james-hepworth/masters/Simulation/README.txt

Instructions to run this simulation can be obtained from:

James Hepworth
james@hepworth.systems
