james-hepworth/masters/Mechanical Design/Mechanical Design Calulations.pdf

# Mechanical Design Calculations

In this document, scans are taken from the author’s notebook of design calculations that were made for various load bearing parts designed for use in the ISP assembly.

## Body Mounting Stand

The body mount supports the entire mass of the gimbal assembly. These calculations estimated deflection in the part when manufactured from 4 mm steel.

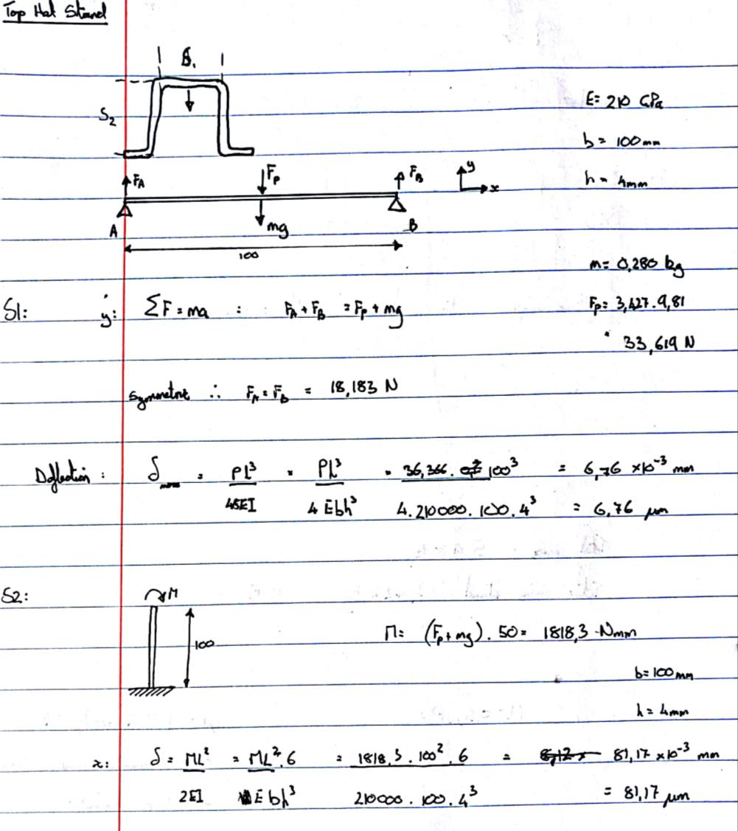
[picture p1: figure]

This part bore the load of the gimbal assembly, at the time of the design calculations, this part had a mass of 3.427 kg. The deflection of the horizontal section was estimated at only -6.76 μm in the y direction indicated, whilst calculations revealed that an x deflection of 81.17 μm would be present if the entire load was supported by one side of the vertical arms. Two arms clearly result in a smaller deflection. These estimates were very small and were acceptable values for the project. Therefore, the mounting stand was chosen to be made from 4 mm thick steel.

### Gimbal Base

The gimbal base supports the vertical uprights of the yaw gimbal which in turn support the telescope platform

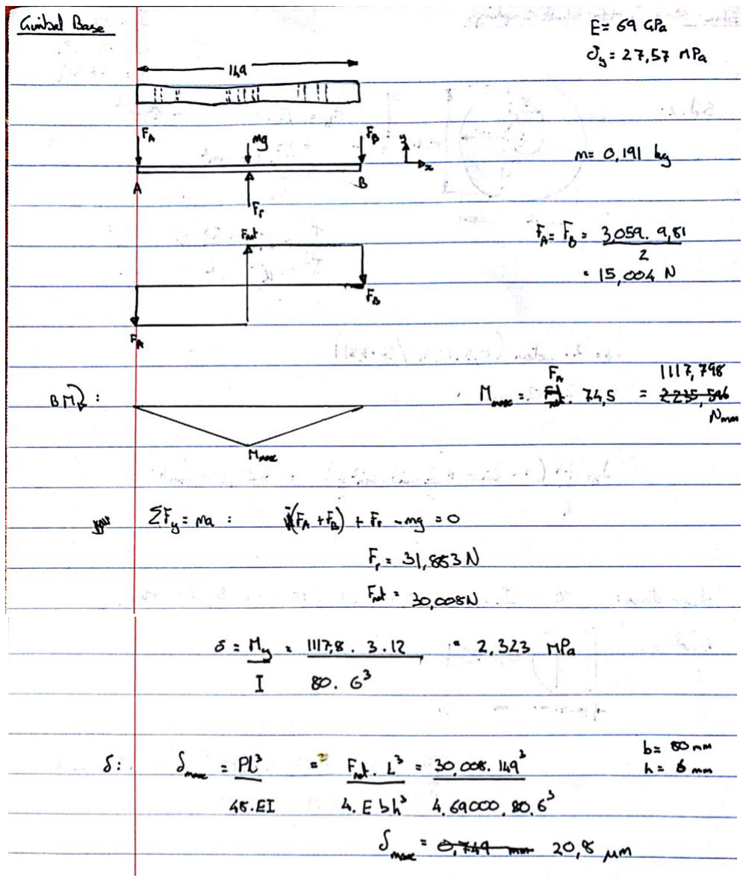
[picture p2: figure]

Calculations estimated an acceptable deflection of 20.8 μm being evident if the part was made from 6 mm Aluminum.

### Shear Stress in Motor Shaft Couplings

The motor shaft couplings joined the motors to the inertia of the gimbal or the telescope platform

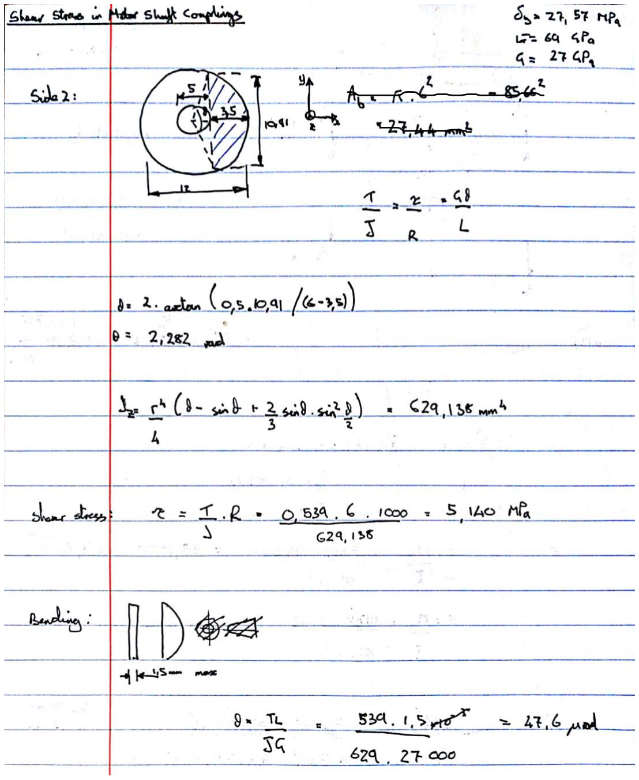
[picture p3: figure]

The calculations above show a shear stress of 5.14 MPa in response to the maximum motor torque of 0.539 Nm. This is well below the yield stress of approximately 27.57 MPa for 1060 Aluminum from which the parts are made. In addition, a twist angle 47.6 μrad was expected and was deemed acceptable for the project

### Gimbal Uprights

These parts support the pitch platform such that it can rotate freely.

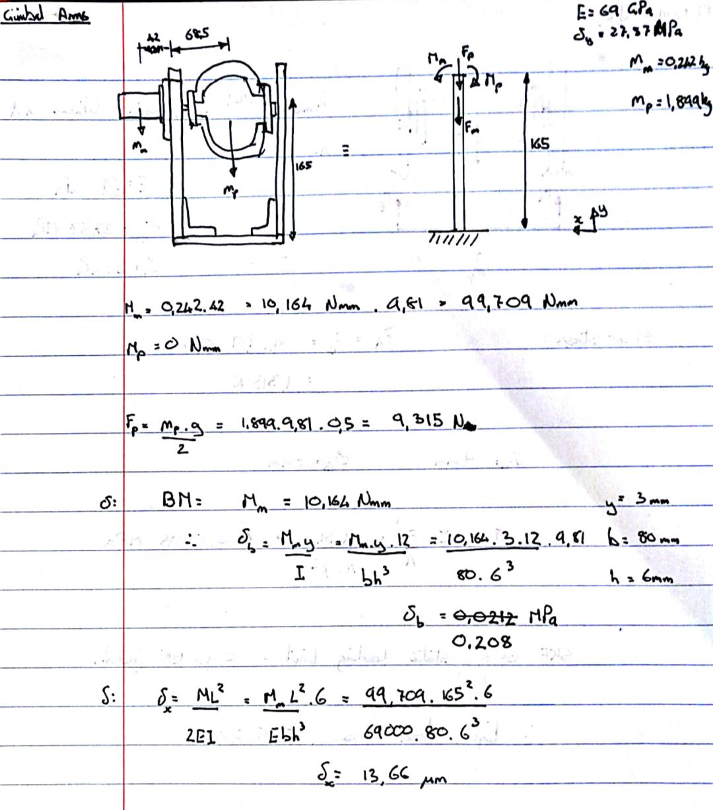
[picture p4: figure]

From the calculations above, a shear stress in the arms was evident at 0.208 MPa, far lower than the yield stress of the 1060 Aluminum from which they were made, and a deflection in the x direction of 13.7 μm was evident.

### Side 1 and Side 2 Turned

These parts supported the telescope platform and were required to bear the shear load of the telescope weight.

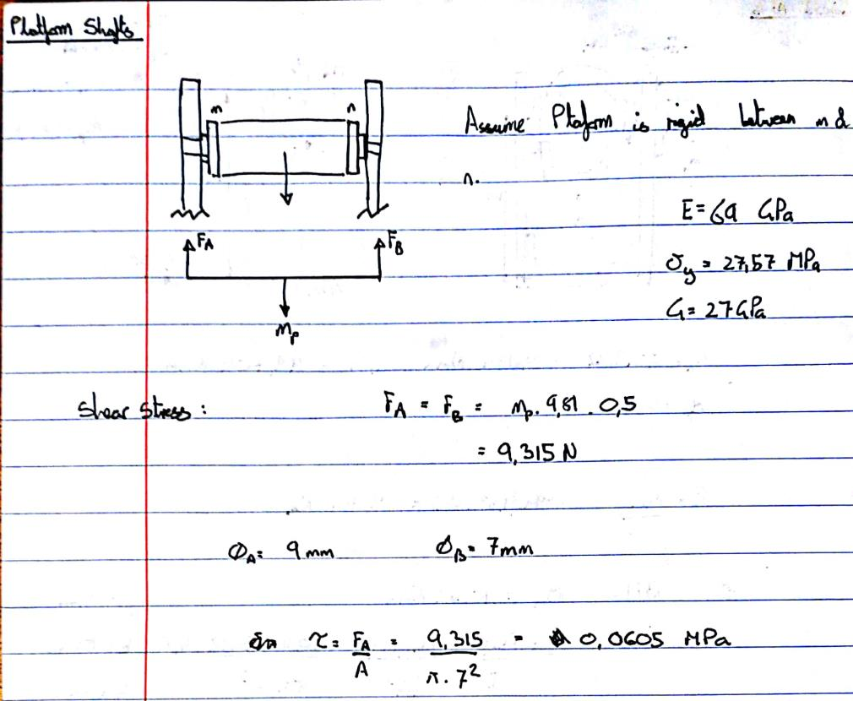
[picture p5: figure]

Shear stress in the parts at 0.061 MPa can be seen to be far lower than the limit for 1060 Aluminum from which they were made.

### Platform Sides

The platform sides support the load of the telescope and transfer it to the Side 1 and 2 turned parts. In the calculations below they can be seen to be under low stress and deflect by very small amounts when manufactured from 5 mm Aluminum.

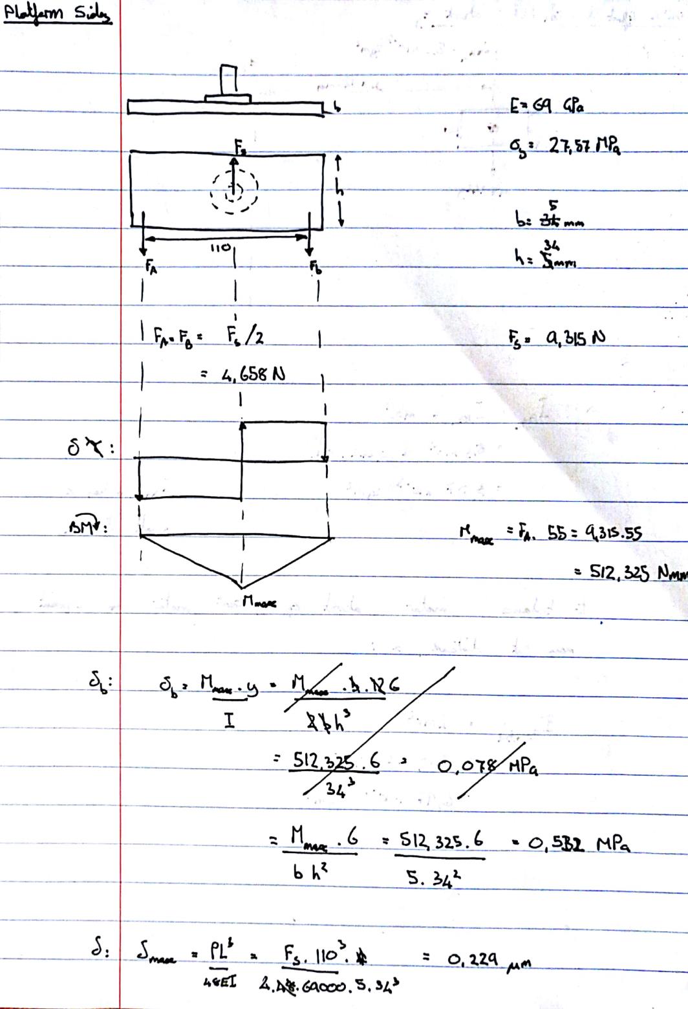
[picture p6: figure]
