james-hepworth/masters/Mechanical Design/SolidWorks Assemblies and Parts/Telescope Platform.SLDASM

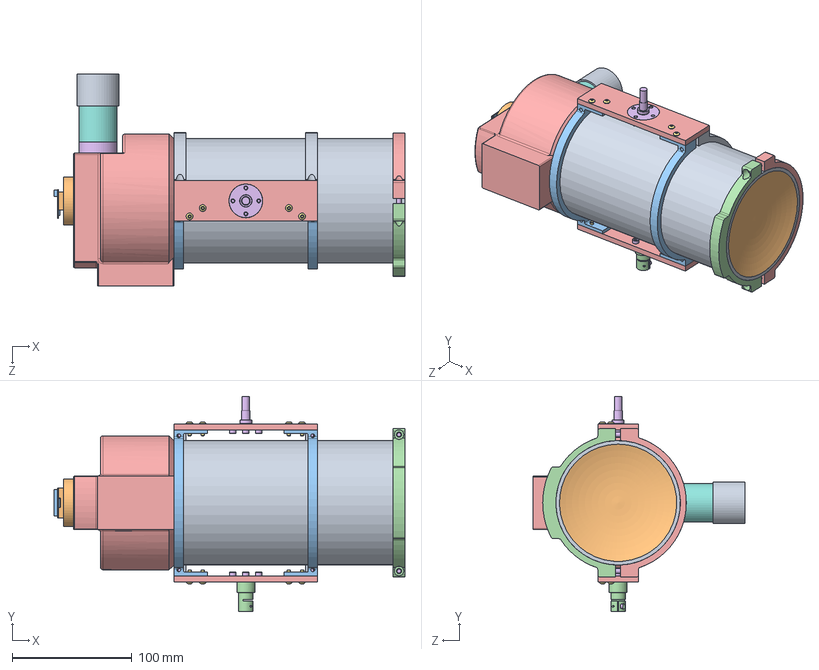
[picture p25: CAD file, 2018-11-27]
Mechanical Design/SolidWorks Assemblies and Parts/Telescope Platform.SLDASM
293.3 x 180.0 x 176.9 mm
Telescope Clamp x 2
CS-Mount Telescope Adapter
Raspberry Pi Cam
Telescope Mass2
Telescope Mass
socket head cap screw_iso x 15
Primary Mirror Mount
Primary Mirror
Tube
Filter
Secondary Mirror Mount
Lense Tube
Back Cover
Eyepiece 1
Lens 2
Eyepiece 2
Eyepiece 3
Lens 1
Tube Clamp Bottom x 2
Side2_Turned
Side_Housing x 2
Side1_Turned
socket button head screw_iso x 8
