james-hepworth/masters/Mechanical Design/SolidWorks Assemblies and Parts/Camera Assembly.SLDASM

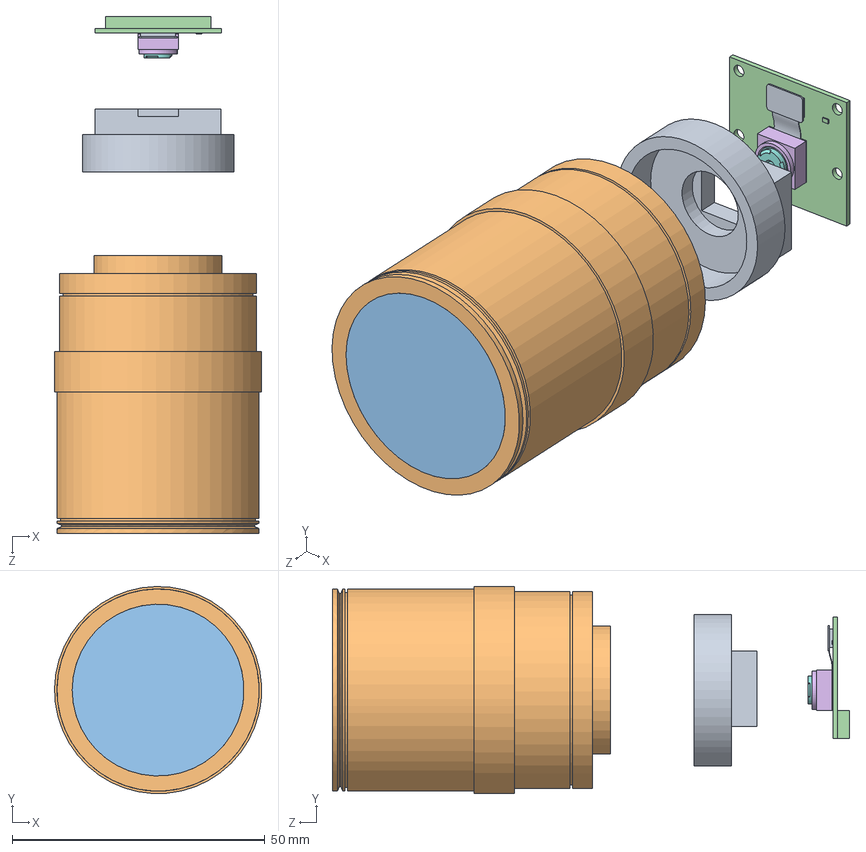
[picture p26: CAD file, 2018-11-27]
Mechanical Design/SolidWorks Assemblies and Parts/Camera Assembly.SLDASM
41.0 x 41.0 x 102.3 mm
CS-Mount Adapter
Actaul Lens
Lens Glass x 2
RasPi_Camera_Board
OVA5647
OVA5647_Housing
OVA5647_IR-Glas
OVA5647_Lens
OVA5647_Pigtail
