james-hepworth/masters/Mechanical Design/SolidWorks Assemblies and Parts/MPU 6050 IMU.SLDASM

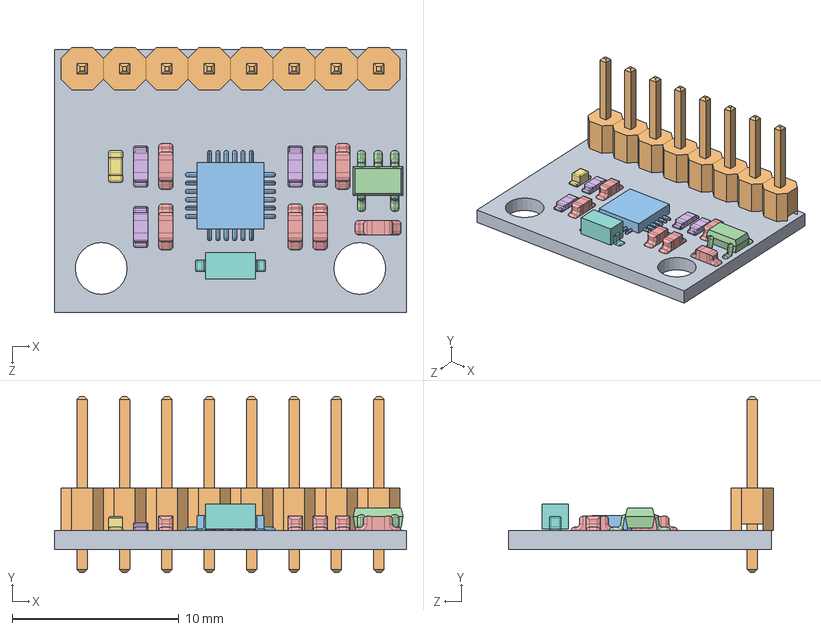
[picture p27: CAD file, 2018-11-27]
Mechanical Design/SolidWorks Assemblies and Parts/MPU 6050 IMU.SLDASM
21.1 x 10.6 x 15.9 mm
Base
pin header x 8
sensor chip
S2NH chip
Resistor small x 6
Resistor small black x 4
Small LED
Resistor black
