james-hepworth/masters/Mechanical Design/SolidWorks Assemblies and Parts/OVA5647.SLDASM

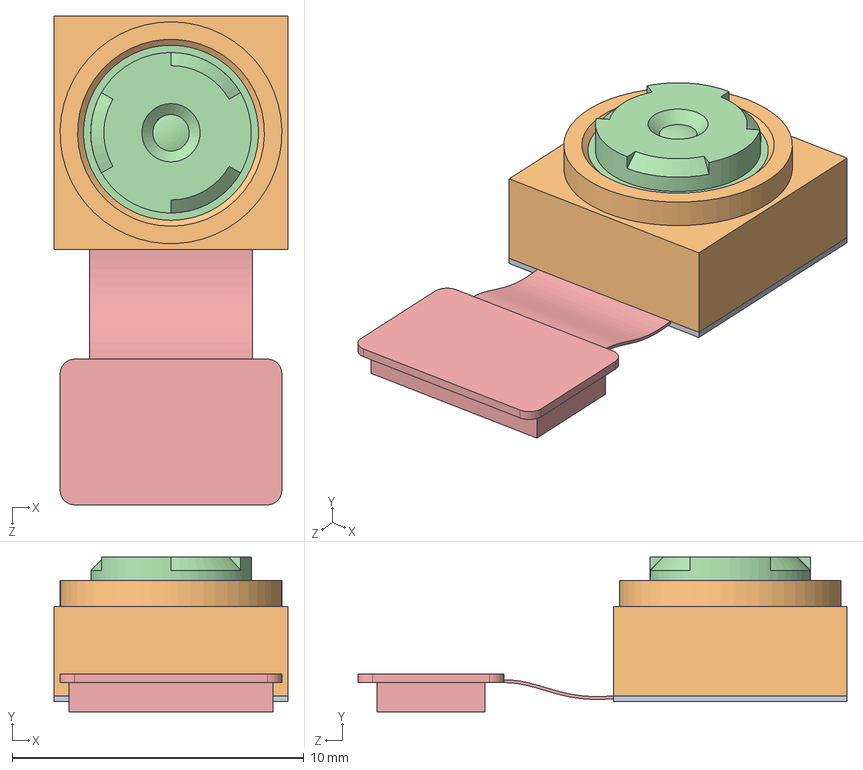
[picture p28: CAD file, 2018-11-27]
Mechanical Design/SolidWorks Assemblies and Parts/OVA5647.SLDASM
8.00 x 5.30 x 16.8 mm
OVA5647
OVA5647_Housing
OVA5647_IR-Glas
OVA5647_Lens
OVA5647_Pigtail
