james-hepworth/masters/Mechanical Design/SolidWorks Assemblies and Parts/Yaw Gimbal.SLDASM

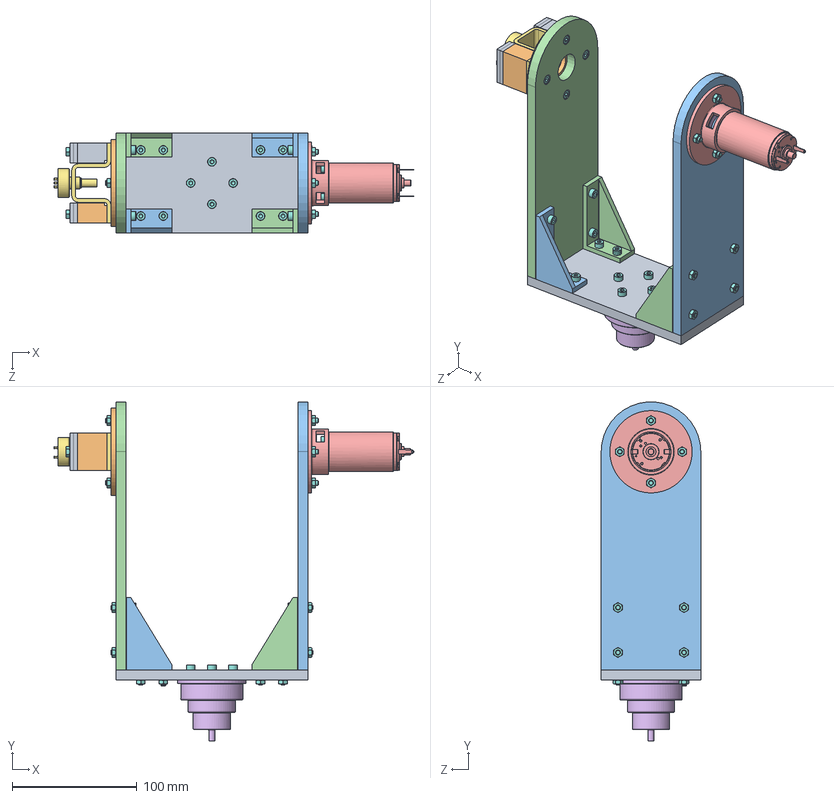
[picture p29: CAD file, 2018-11-27]
Mechanical Design/SolidWorks Assemblies and Parts/Yaw Gimbal.SLDASM
288.8 x 271.9 x 80.0 mm
Gimbal Base
Retaining Disk 1
Upright2
Upright1
3257 Mount
Bearing Mount
Pot Mount
socket head cap screw_iso x 34
Mass Block CNC L
Mass Block CNC R
Vertical Suport1 x 2
Vertical Suport2 x 2
3257G_CR_SW
Yaw Inner Race
Vishay 357 Pot
hex nut style 1 gradeab_iso x 24
Mass Block2 x 4
