james-hepworth/masters/Mechanical Design/SolidWorks Assemblies and Parts/Stand2.SLDASM

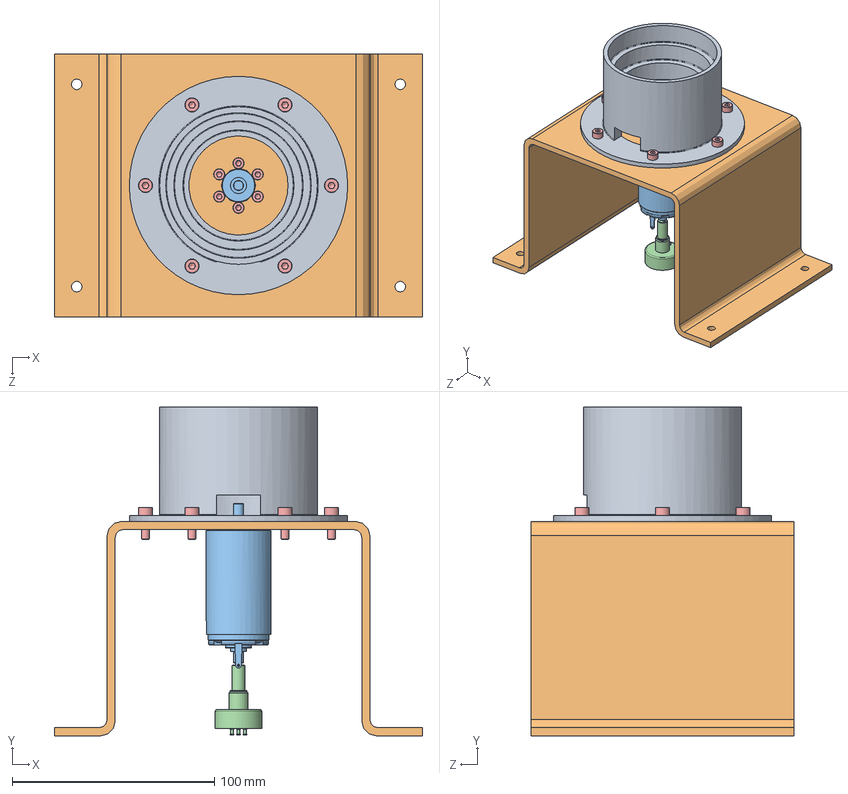
[picture p30: CAD file, 2018-11-27]
Mechanical Design/SolidWorks Assemblies and Parts/Stand2.SLDASM
182.0 x 162.5 x 130.0 mm
Body Mount
3257G_CR_SW
Yaw Outer Race
Vishay 357 Pot
socket head cap screw_iso x 12
