james-hepworth/masters/Mechanical Design/SolidWorks Assemblies and Parts/Eyepiece.SLDASM

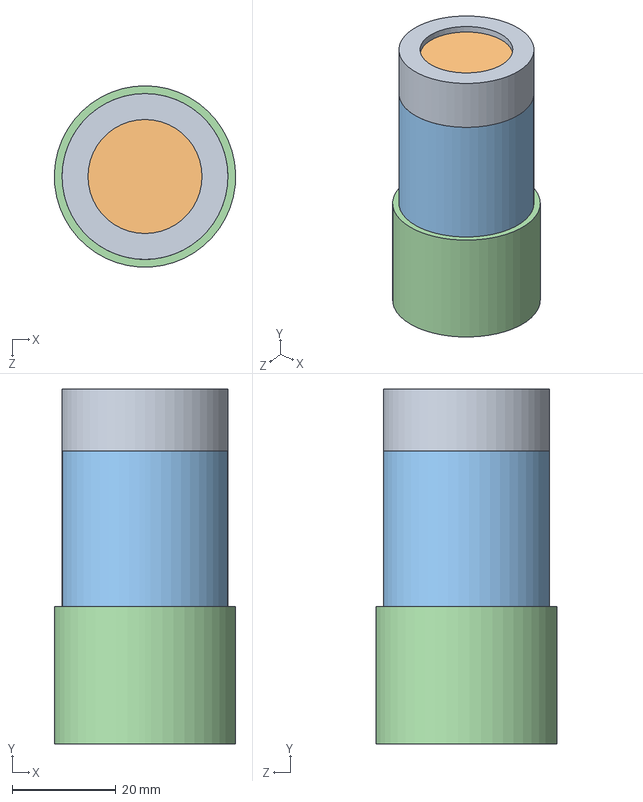
[picture p32: CAD file, 2018-11-27]
Mechanical Design/SolidWorks Assemblies and Parts/Eyepiece.SLDASM
35.0 x 68.5 x 35.0 mm
Eyepiece 1
Lens 2
Eyepiece 2
Eyepiece 3
Lens 1
