james-hepworth/masters/Mechanical Design/SolidWorks Assemblies and Parts/Gimbal.SLDASM

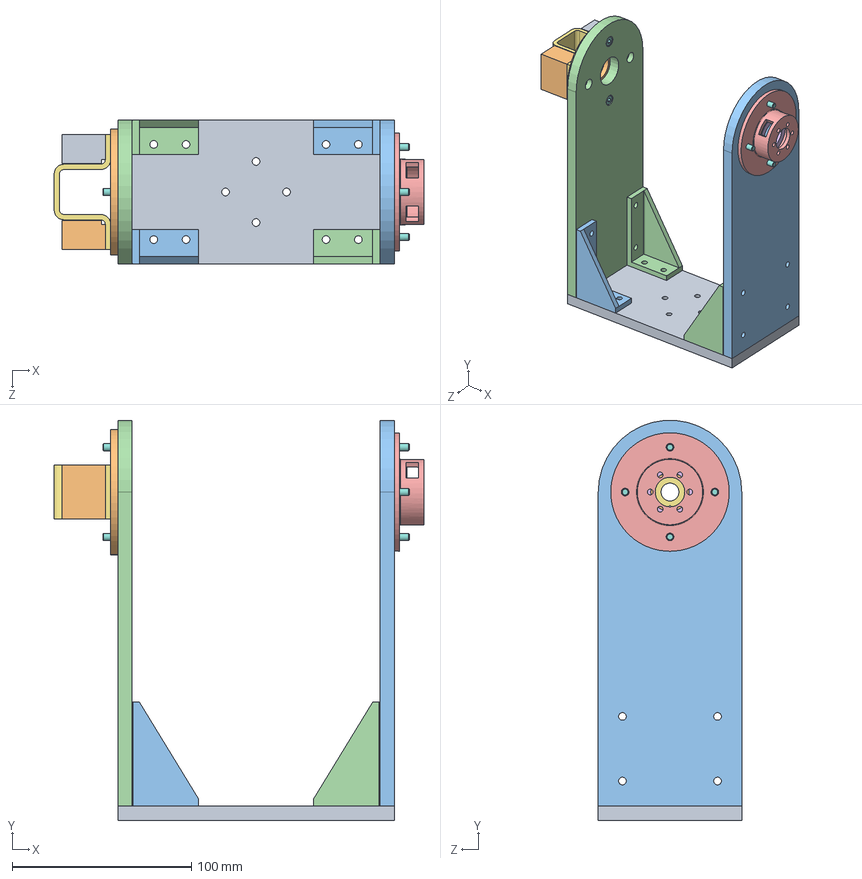
[picture p33: CAD file, 2018-11-27]
Mechanical Design/SolidWorks Assemblies and Parts/Gimbal.SLDASM
206.0 x 222.9 x 80.0 mm
Gimbal Base
Retaining Disk 1
Upright2
Upright1
3257 Mount
Bearing Mount
Pot Mount
socket head cap screw_iso x 6
Mass Block CNC L
Mass Block CNC R
Vertical Suport1 x 2
Vertical Suport2 x 2
