james-hepworth/masters/Mechanical Design/SolidWorks Assemblies and Parts/Base New.SLDASM

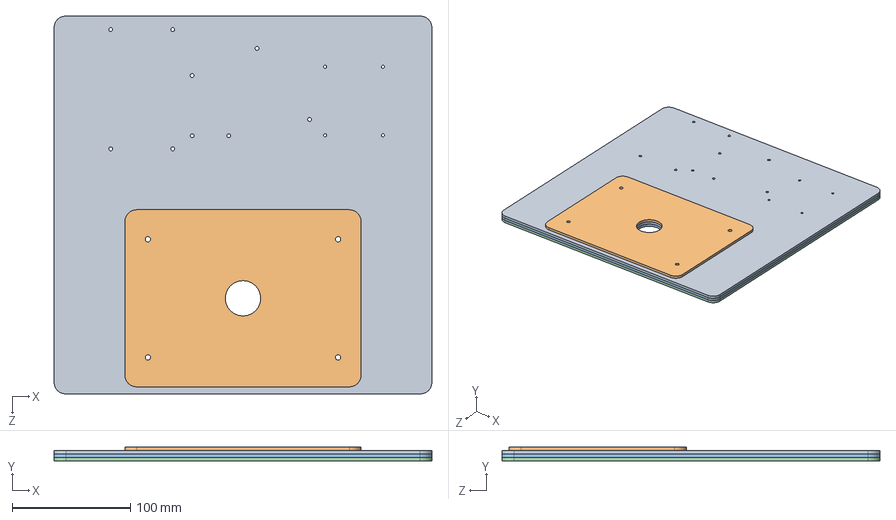
[picture p34: CAD file, 2018-11-27]
Mechanical Design/SolidWorks Assemblies and Parts/Base New.SLDASM
320.0 x 12.0 x 320.0 mm
System Base
System Base2
System Base3
System Base4
