james-hepworth/masters/Mechanical Design/SolidWorks Assemblies and Parts/127 TN9.sldasm

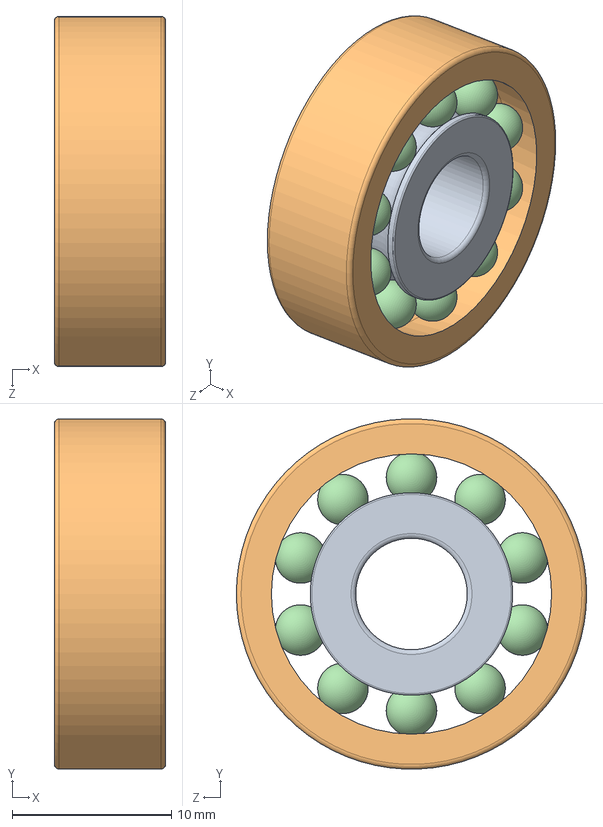
[picture p35: CAD file, 2018-11-27]
Mechanical Design/SolidWorks Assemblies and Parts/127 TN9.sldasm
7.00 x 22.0 x 22.0 mm
127 TN9_PART1
127 TN9_PART2
127 TN9_PART3 x 10
127 TN9_PART4 x 10
