james-hepworth/masters/Mechanical Design/SolidWorks Assemblies and Parts/ETX-90 Model.SLDASM

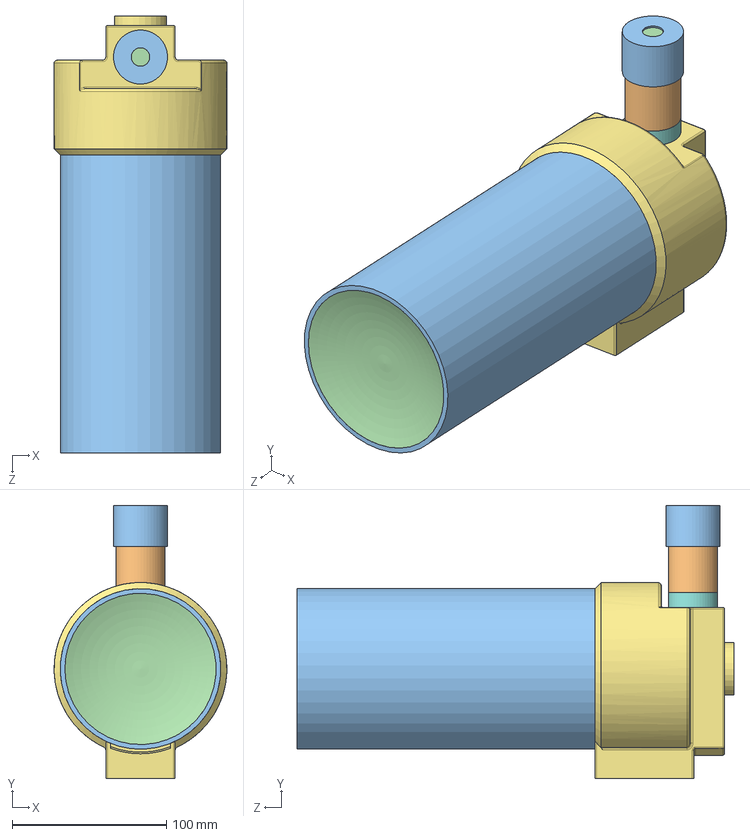
[picture p36: CAD file, 2018-11-27]
Mechanical Design/SolidWorks Assemblies and Parts/ETX-90 Model.SLDASM
112.0 x 176.9 x 283.0 mm
Primary Mirror Mount
Primary Mirror
Tube
Filter
Secondary Mirror Mount
Lense Tube
Back Cover
Eyepiece 1
Lens 2
Eyepiece 2
Eyepiece 3
Lens 1
