james-hepworth/masters/Mechanical Design/SolidWorks Assemblies and Parts/System Assembly.SLDASM

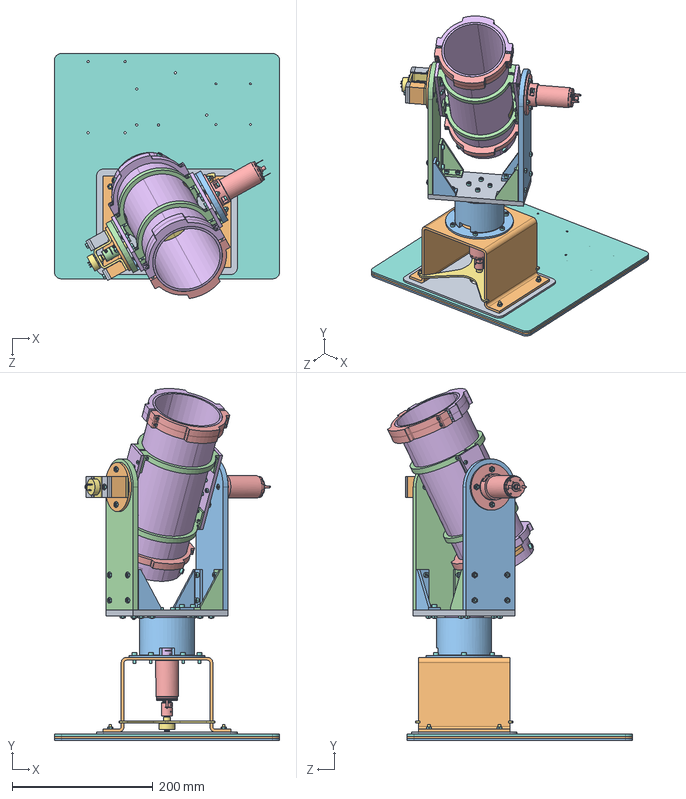
[picture p37: CAD file, 2018-11-27]
Mechanical Design/SolidWorks Assemblies and Parts/System Assembly.SLDASM
320.0 x 499.7 x 347.9 mm
Gimbal Base
Retaining Disk 1
Upright2
Upright1
3257 Mount
Bearing Mount
Pot Mount
socket head cap screw_iso x 72
Mass Block CNC L
Mass Block CNC R
Vertical Suport1 x 2
Vertical Suport2 x 2
3257G_CR_SW x 2
Yaw Inner Race
Vishay 357 Pot x 2
hex nut style 1 gradeab_iso x 36
Mass Block2 x 4
Body Mount
Yaw Outer Race
Tube Clamp Bottom x 2
Side2_Turned
Side_Housing x 2
Side1_Turned
socket button head screw_iso x 8
Cam Mount3
Cam Mount2
Cam Mount1
Base
pin header x 8
sensor chip
S2NH chip
Resistor small x 6
Resistor small black x 4
Small LED
Resistor black
IMU mount
CS-Mount Adapter
Actaul Lens
Lens Glass x 2
RasPi_Camera_Board
OVA5647
OVA5647_Housing
OVA5647_IR-Glas
OVA5647_Lens
OVA5647_Pigtail
Cam Tube x 2
Cam Holder x 4
pan head cross recess screw_iso x 6
Cam Mount3 H
Cam Mount2.1
M5 Insert x 4
Tube Clamp x 2
Tube Mass Bottom x 3
Tube Mass x 3
127 TN9_PART1
127 TN9_PART2
127 TN9_PART3 x 10
127 TN9_PART4 x 10
radial ball bearing_68_skf x 2
Pot Coupling1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
