james-hepworth/masters/Mechanical Design/SolidWorks Assemblies and Parts/Pitch Platform.SLDASM

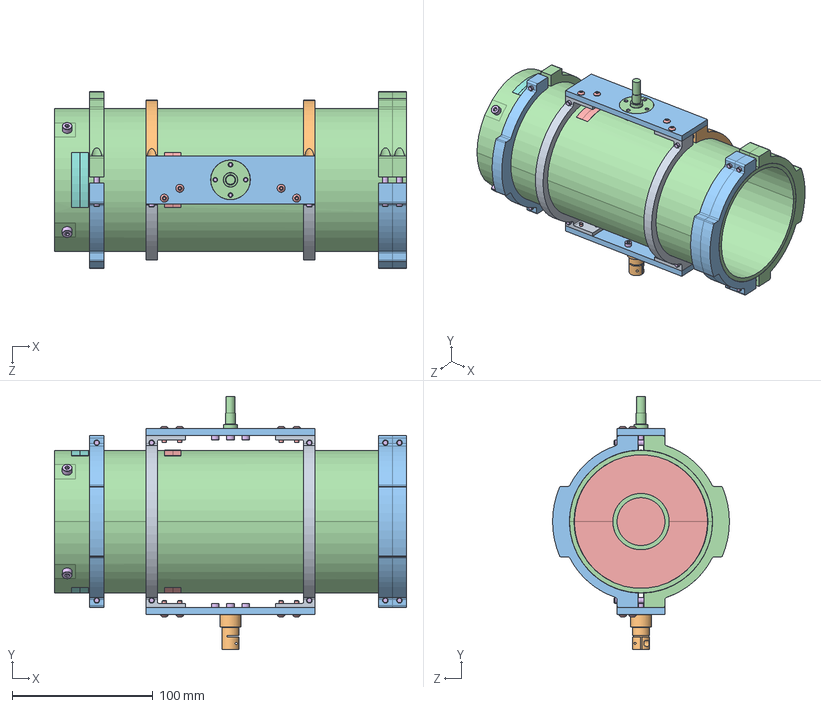
[picture p38: CAD file, 2018-11-27]
Mechanical Design/SolidWorks Assemblies and Parts/Pitch Platform.SLDASM
250.0 x 180.0 x 125.6 mm
Tube Clamp Bottom x 2
Side2_Turned
Side_Housing x 2
Side1_Turned
socket button head screw_iso x 8
socket head cap screw_iso x 26
Cam Mount3
Cam Mount2
Cam Mount1
Base
pin header x 8
sensor chip
S2NH chip
Resistor small x 6
Resistor small black x 4
Small LED
Resistor black
IMU mount
CS-Mount Adapter
Actaul Lens
Lens Glass x 2
RasPi_Camera_Board
OVA5647
OVA5647_Housing
OVA5647_IR-Glas
OVA5647_Lens
OVA5647_Pigtail
Cam Tube x 2
Cam Holder x 4
pan head cross recess screw_iso x 6
Cam Mount3 H
Cam Mount2.1
M5 Insert x 4
Tube Clamp x 2
Tube Mass Bottom x 3
Tube Mass x 3
