james-hepworth/masters/Mechanical Design/SolidWorks Assemblies and Parts/RasPi_Camera.SLDASM

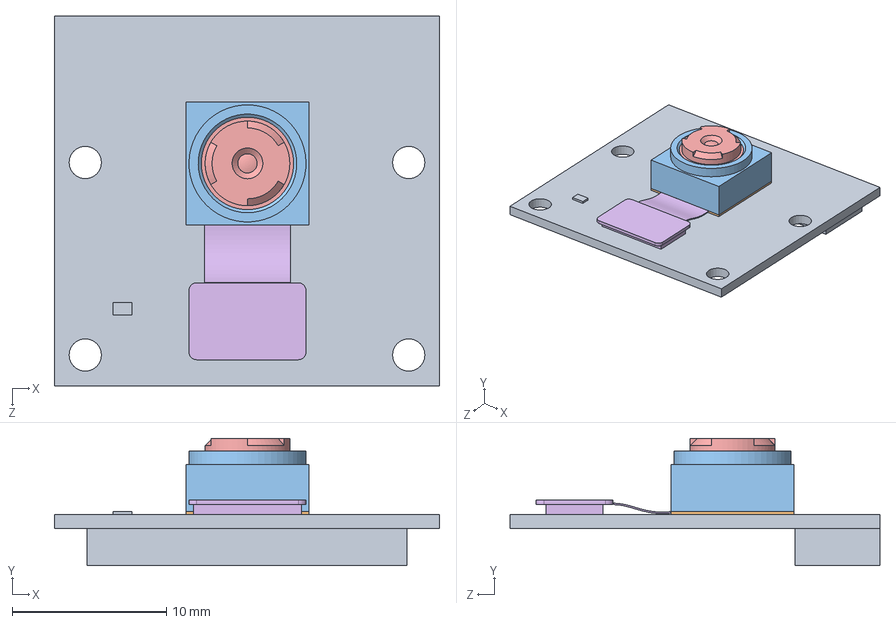
[picture p39: CAD file, 2018-11-27]
Mechanical Design/SolidWorks Assemblies and Parts/RasPi_Camera.SLDASM
25.0 x 8.25 x 24.0 mm
RasPi_Camera_Board
OVA5647
OVA5647_Housing
OVA5647_IR-Glas
OVA5647_Lens
OVA5647_Pigtail
