james-hepworth/masters/Mechanical Design/SolidWorks Assemblies and Parts/Telescop Modeller Tray.SLDASM

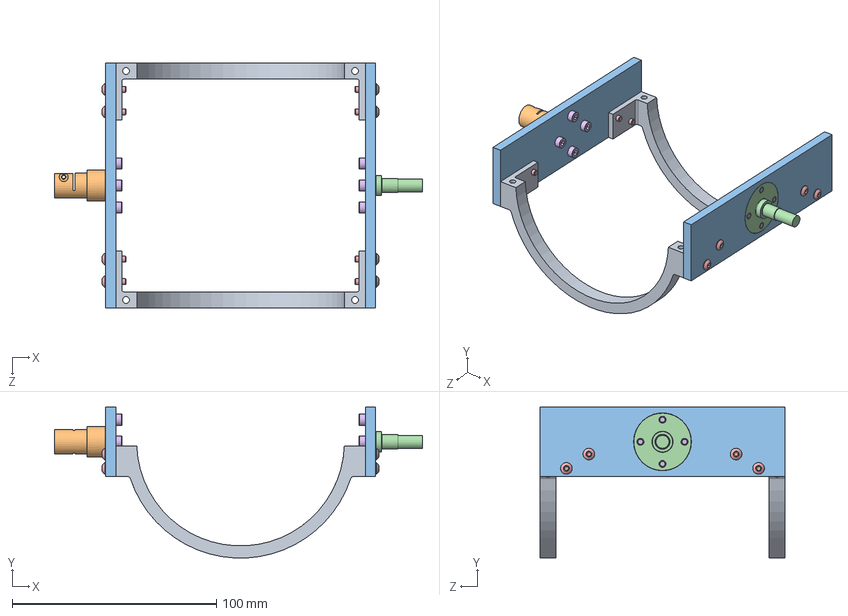
[picture p40: CAD file, 2018-11-27]
Mechanical Design/SolidWorks Assemblies and Parts/Telescop Modeller Tray.SLDASM
180.0 x 73.8 x 120.0 mm
Tube Clamp Bottom x 2
Side2_Turned
Side_Housing x 2
Side1_Turned
socket button head screw_iso x 8
socket head cap screw_iso x 8
