james-hepworth/masters/Mechanical Design/SolidWorks Assemblies and Parts/127 TN9_PART2.sldprt

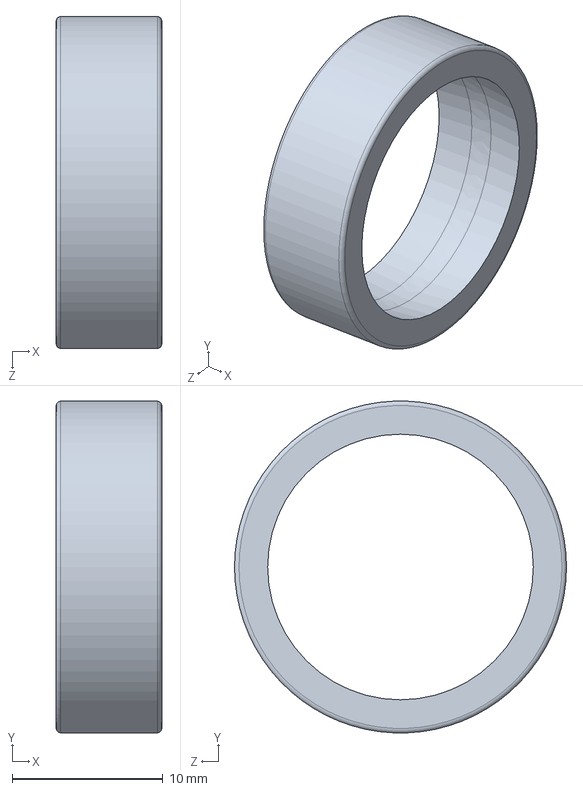
[picture p41: CAD file, 2018-11-27]
Mechanical Design/SolidWorks Assemblies and Parts/127 TN9_PART2.sldprt
7.00 x 22.0 x 22.0 mm
