james-hepworth/masters/Mechanical Design/SolidWorks Assemblies and Parts/Side1_Turned.SLDPRT

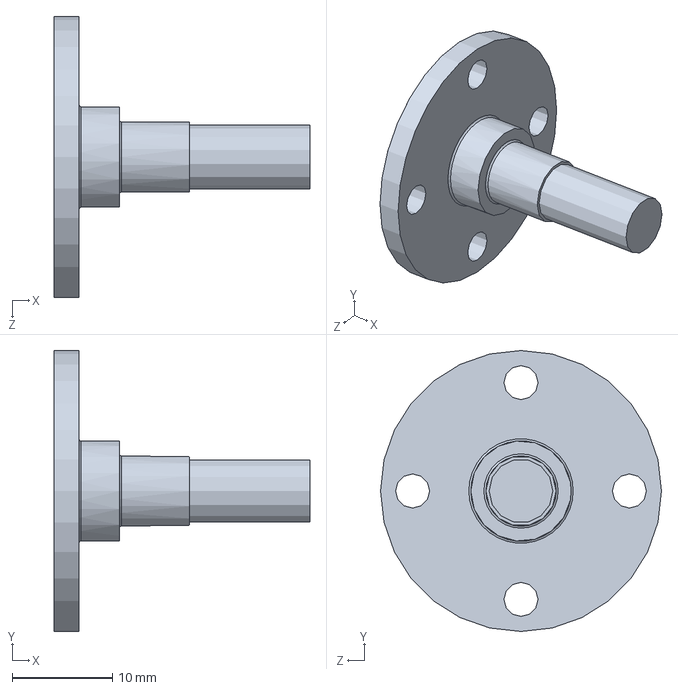
[picture p42: CAD file, 2018-11-27]
Mechanical Design/SolidWorks Assemblies and Parts/Side1_Turned.SLDPRT
25.5 x 28.0 x 28.0 mm
