james-hepworth/masters/Mechanical Design/SolidWorks Assemblies and Parts/OVA5647_Housing.SLDPRT

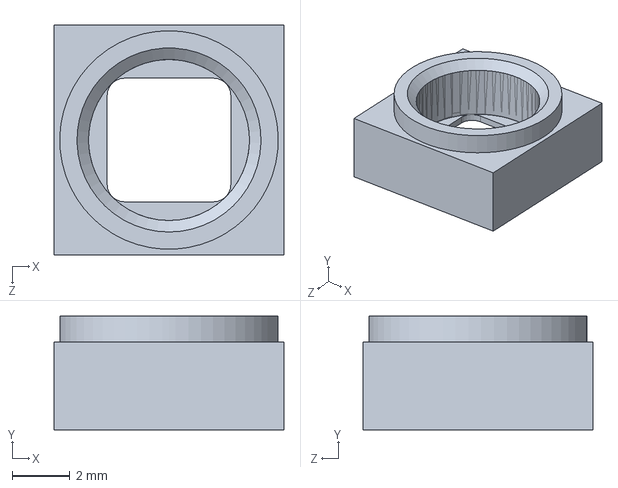
[picture p43: CAD file, 2018-11-27]
Mechanical Design/SolidWorks Assemblies and Parts/OVA5647_Housing.SLDPRT
8.00 x 3.95 x 8.00 mm
