james-hepworth/masters/Mechanical Design/SolidWorks Assemblies and Parts/Cam Mount3.SLDPRT

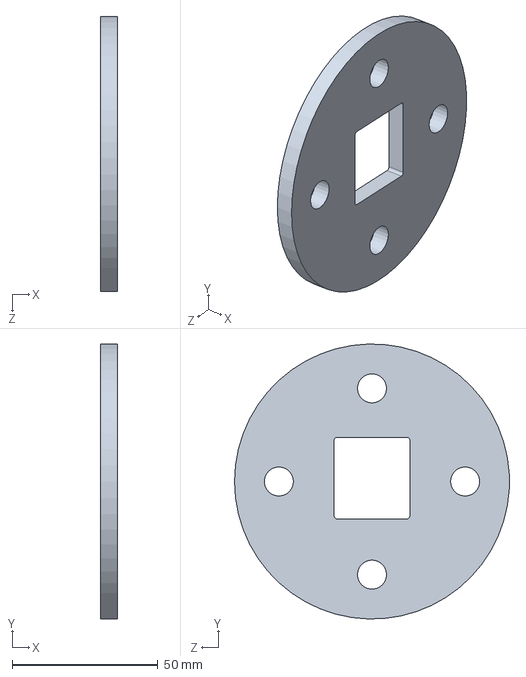
[picture p44: CAD file, 2018-11-27]
Mechanical Design/SolidWorks Assemblies and Parts/Cam Mount3.SLDPRT
6.00 x 94.5 x 94.5 mm
