james-hepworth/masters/Mechanical Design/SolidWorks Assemblies and Parts/Tube Mass.SLDPRT

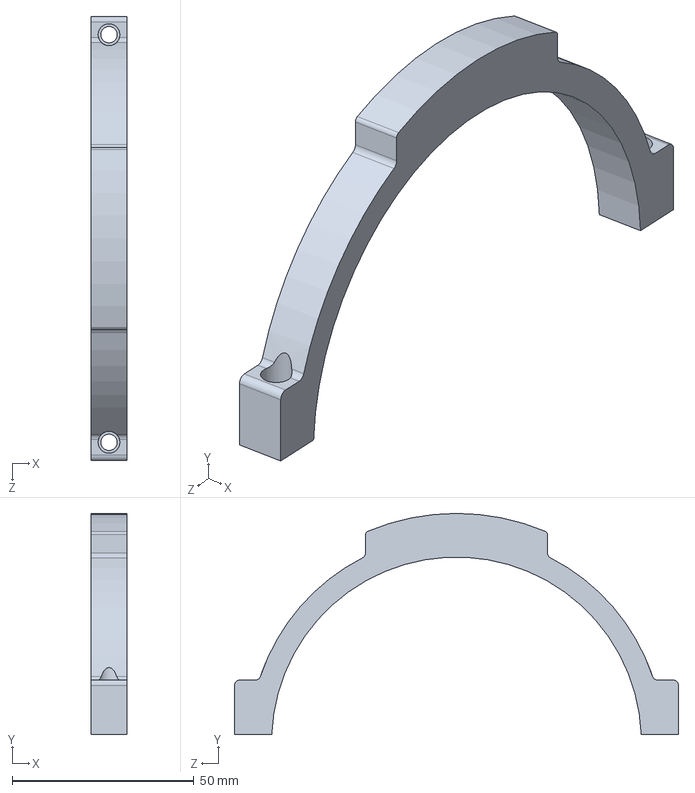
[picture p45: CAD file, 2018-11-27]
Mechanical Design/SolidWorks Assemblies and Parts/Tube Mass.SLDPRT
10.0 x 60.8 x 122.0 mm
