james-hepworth/masters/Mechanical Design/SolidWorks Assemblies and Parts/sensor chip.SLDPRT

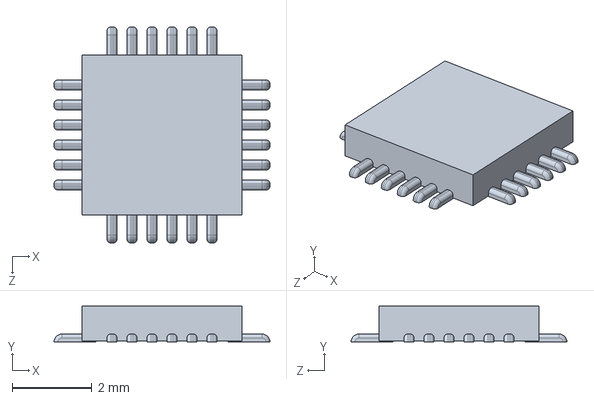
[picture p46: CAD file, 2018-11-27]
Mechanical Design/SolidWorks Assemblies and Parts/sensor chip.SLDPRT
5.40 x 0.9 x 5.40 mm
