james-hepworth/masters/Mechanical Design/SolidWorks Assemblies and Parts/Mass Block2.SLDPRT

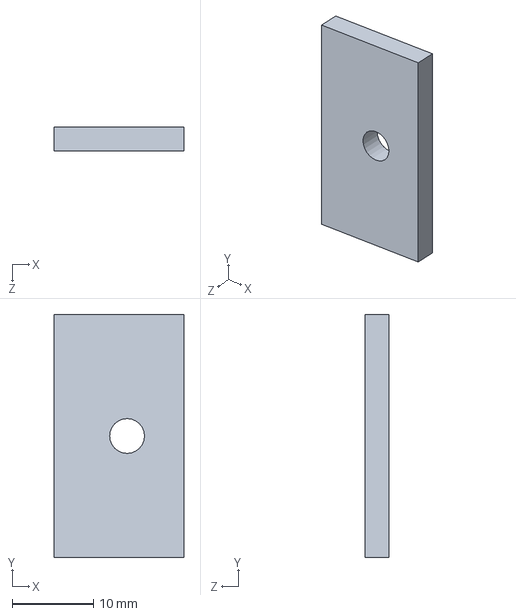
[picture p47: CAD file, 2018-11-27]
Mechanical Design/SolidWorks Assemblies and Parts/Mass Block2.SLDPRT
16.0 x 30.0 x 3.00 mm
