james-hepworth/masters/Mechanical Design/SolidWorks Assemblies and Parts/Pot Mount.SLDPRT

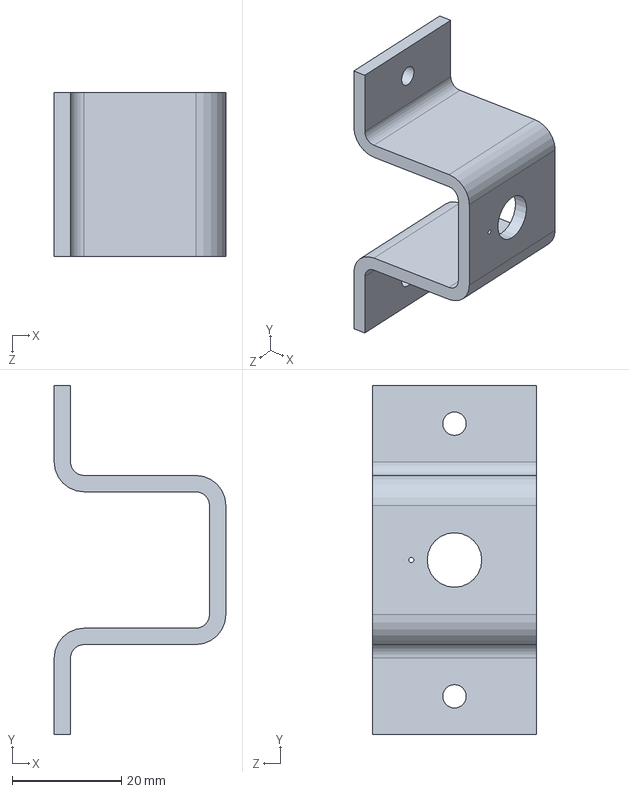
[picture p48: CAD file, 2018-11-27]
Mechanical Design/SolidWorks Assemblies and Parts/Pot Mount.SLDPRT
31.5 x 64.0 x 30.0 mm
