james-hepworth/masters/Mechanical Design/SolidWorks Assemblies and Parts/Side1.SLDPRT

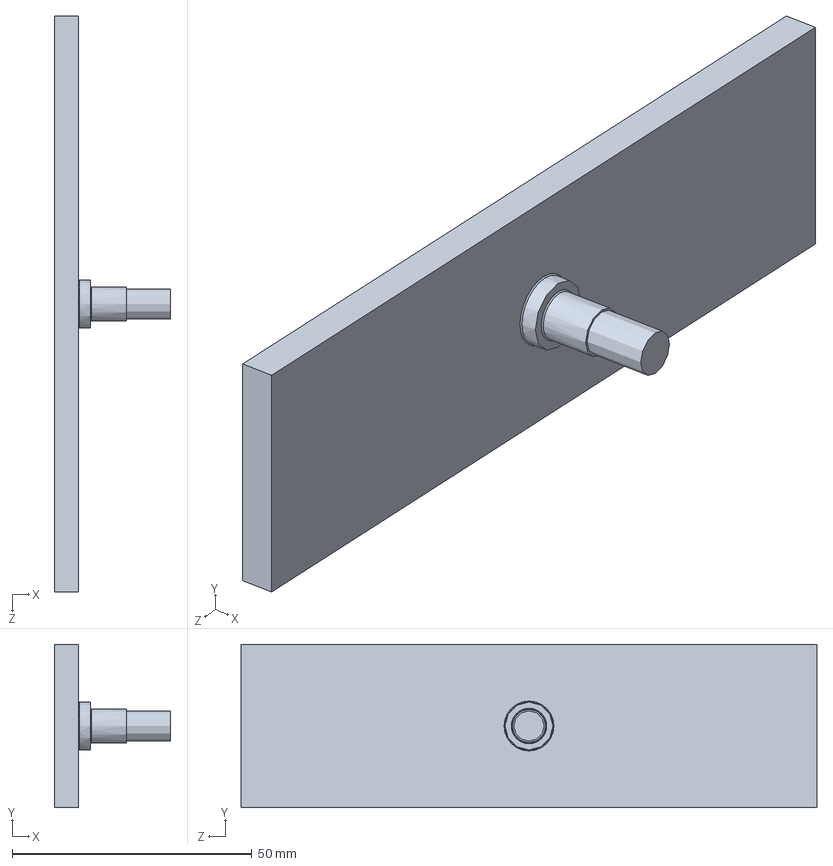
[picture p49: CAD file, 2018-11-27]
Mechanical Design/SolidWorks Assemblies and Parts/Side1.SLDPRT
24.2 x 34.0 x 120.0 mm
