james-hepworth/masters/Mechanical Design/SolidWorks Assemblies and Parts/Shaft Coupling.SLDPRT

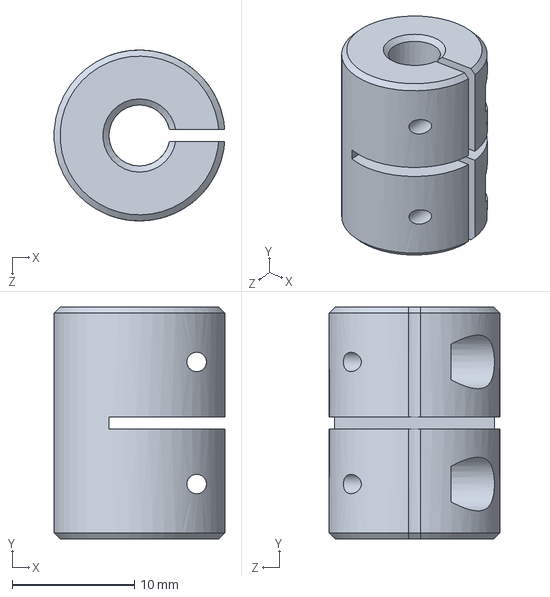
[picture p50: CAD file, 2018-11-27]
Mechanical Design/SolidWorks Assemblies and Parts/Shaft Coupling.SLDPRT
14.0 x 19.0 x 14.0 mm
