james-hepworth/masters/Mechanical Design/SolidWorks Assemblies and Parts/Yaw Inner Race.SLDPRT

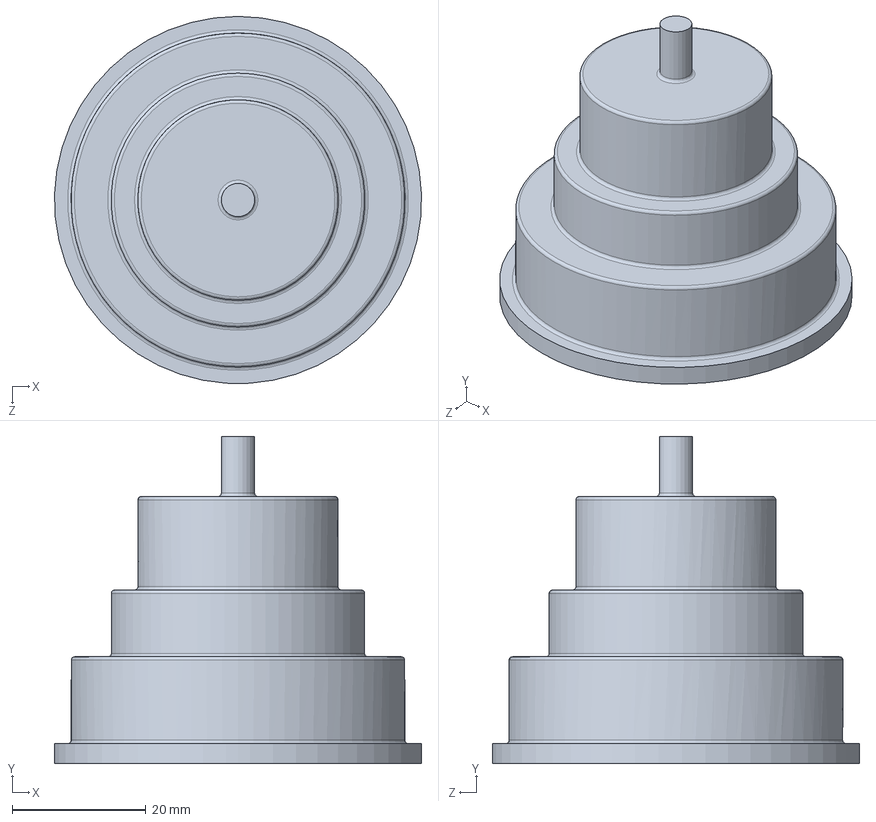
[picture p51: CAD file, 2018-11-27]
Mechanical Design/SolidWorks Assemblies and Parts/Yaw Inner Race.SLDPRT
55.0 x 49.0 x 55.0 mm
