james-hepworth/masters/Mechanical Design/SolidWorks Assemblies and Parts/System Base3.SLDPRT

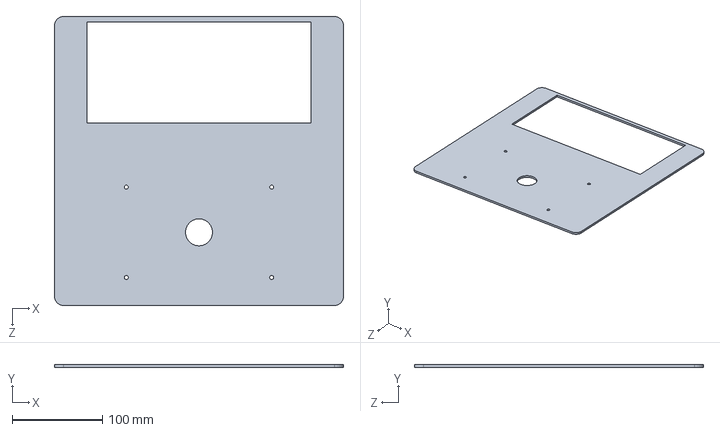
[picture p52: CAD file, 2018-11-27]
Mechanical Design/SolidWorks Assemblies and Parts/System Base3.SLDPRT
320.0 x 3.00 x 320.0 mm
