james-hepworth/masters/Mechanical Design/SolidWorks Assemblies and Parts/Part1.SLDPRT

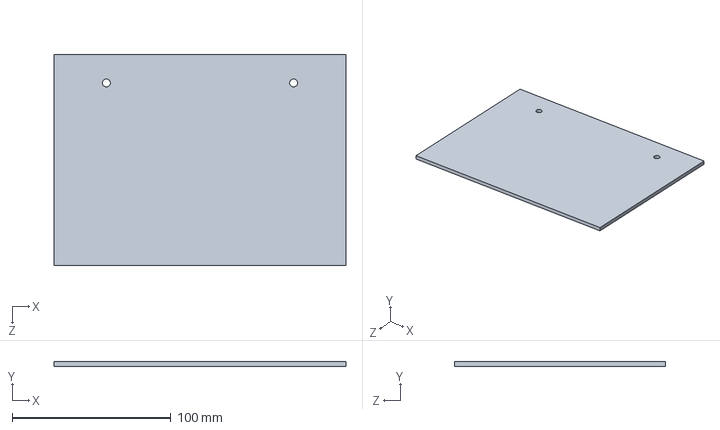
[picture p53: CAD file, 2018-11-27]
Mechanical Design/SolidWorks Assemblies and Parts/Part1.SLDPRT
183.8 x 3.00 x 133.0 mm
