james-hepworth/masters/Mechanical Design/SolidWorks Assemblies and Parts/Yaw Outer Race.SLDPRT

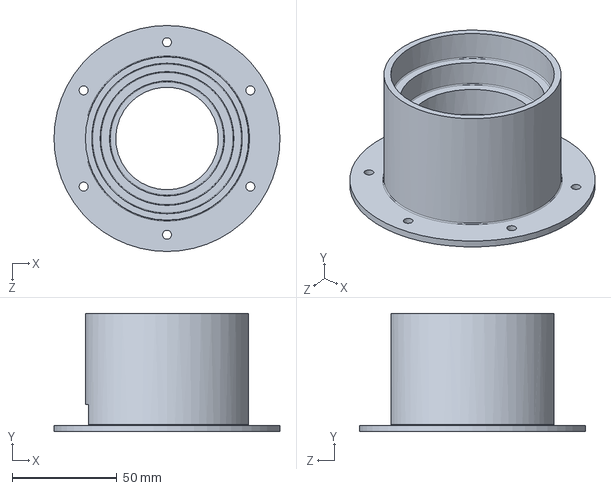
[picture p54: CAD file, 2018-11-27]
Mechanical Design/SolidWorks Assemblies and Parts/Yaw Outer Race.SLDPRT
108.0 x 56.5 x 108.0 mm
