james-hepworth/masters/Mechanical Design/SolidWorks Assemblies and Parts/Tube Mass Bottom.SLDPRT

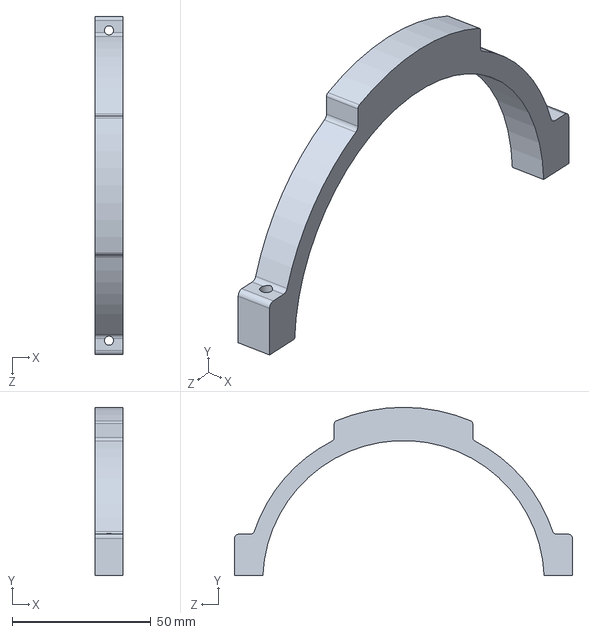
[picture p55: CAD file, 2018-11-27]
Mechanical Design/SolidWorks Assemblies and Parts/Tube Mass Bottom.SLDPRT
10.0 x 60.8 x 122.0 mm
