james-hepworth/masters/Mechanical Design/SolidWorks Assemblies and Parts/Back Cover.SLDPRT

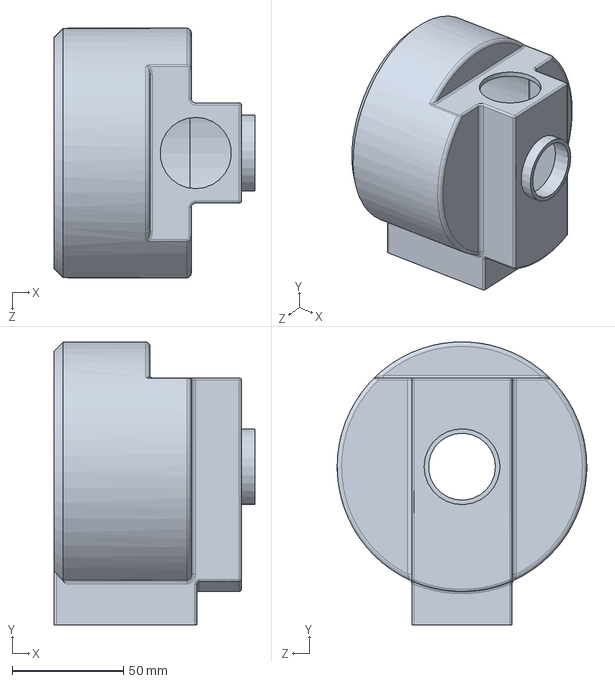
[picture p56: CAD file, 2018-11-27]
Mechanical Design/SolidWorks Assemblies and Parts/Back Cover.SLDPRT
90.0 x 126.9 x 112.0 mm
