james-hepworth/masters/Mechanical Design/SolidWorks Assemblies and Parts/Tube Clamp Bottom.SLDPRT

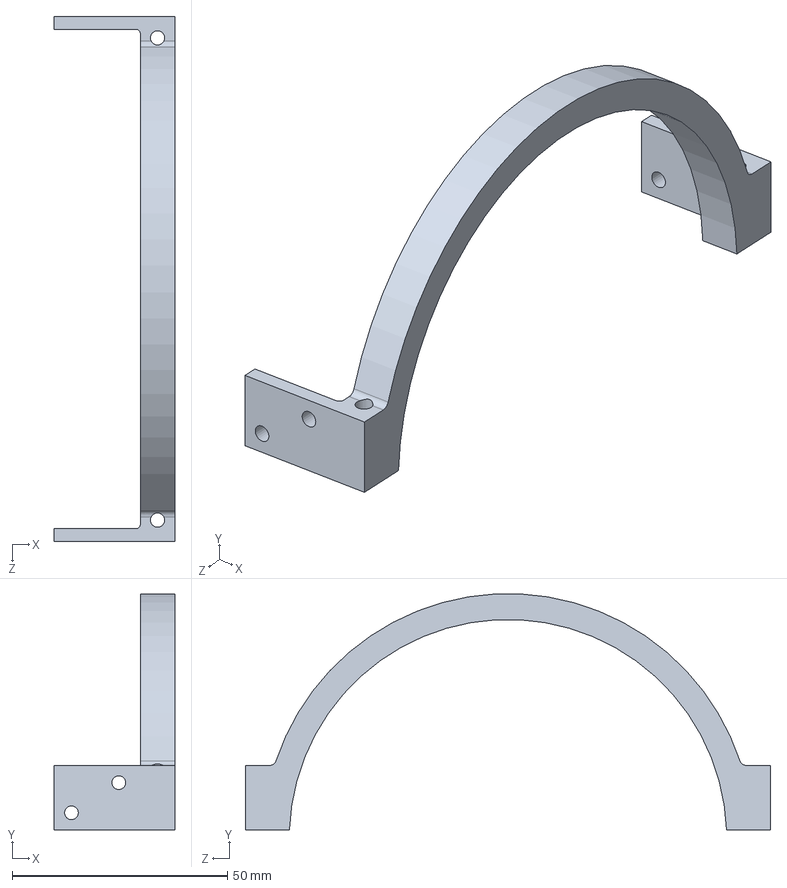
[picture p57: CAD file, 2018-11-27]
Mechanical Design/SolidWorks Assemblies and Parts/Tube Clamp Bottom.SLDPRT
28.0 x 54.8 x 122.0 mm
