james-hepworth/masters/Mechanical Design/SolidWorks Assemblies and Parts/Primary Mirror Mount.SLDPRT

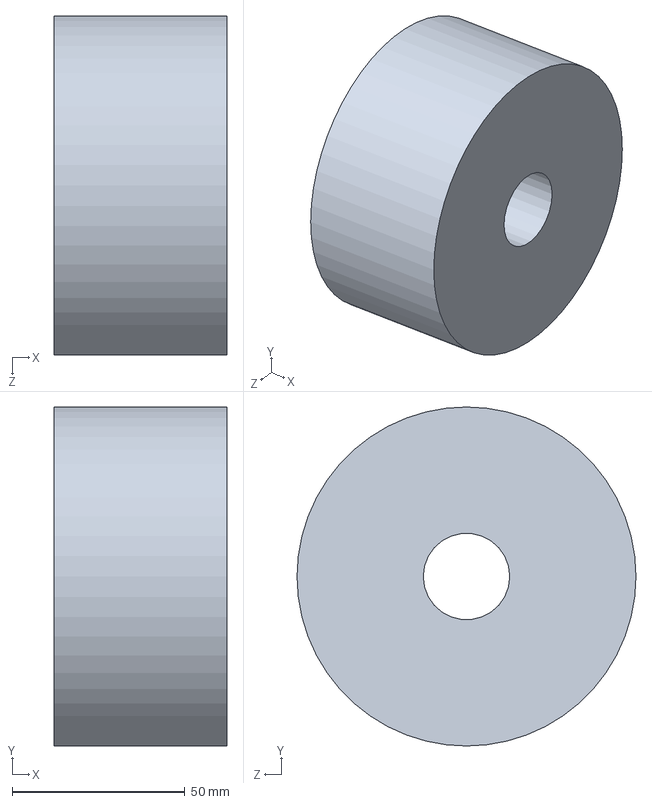
[picture p58: CAD file, 2018-11-27]
Mechanical Design/SolidWorks Assemblies and Parts/Primary Mirror Mount.SLDPRT
50.0 x 98.0 x 98.0 mm
