james-hepworth/masters/Mechanical Design/SolidWorks Assemblies and Parts/Small LED.SLDPRT

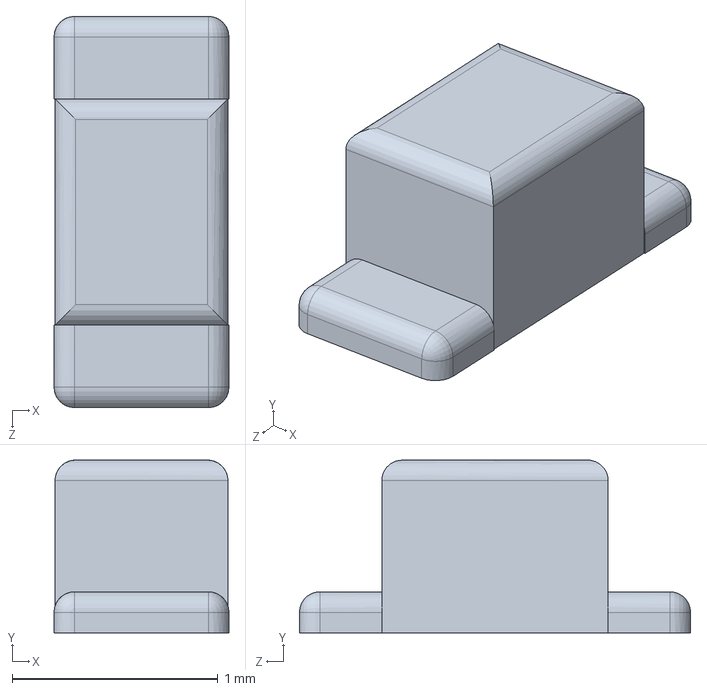
[picture p59: CAD file, 2018-11-27]
Mechanical Design/SolidWorks Assemblies and Parts/Small LED.SLDPRT
0.85 x 0.84 x 1.90 mm
