james-hepworth/masters/Mechanical Design/SolidWorks Assemblies and Parts/Pot Coupling2.SLDPRT

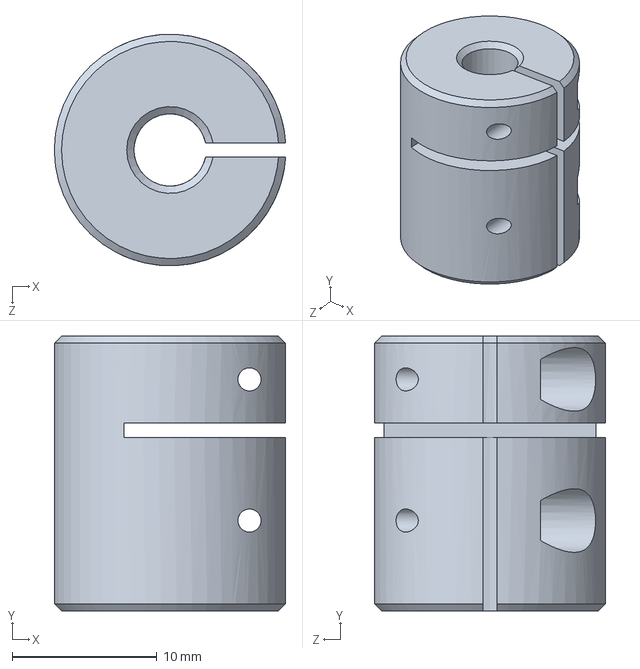
[picture p60: CAD file, 2018-11-27]
Mechanical Design/SolidWorks Assemblies and Parts/Pot Coupling2.SLDPRT
16.0 x 19.0 x 16.0 mm
