james-hepworth/masters/Mechanical Design/SolidWorks Assemblies and Parts/CS-Mount Telescope Adapter.SLDPRT

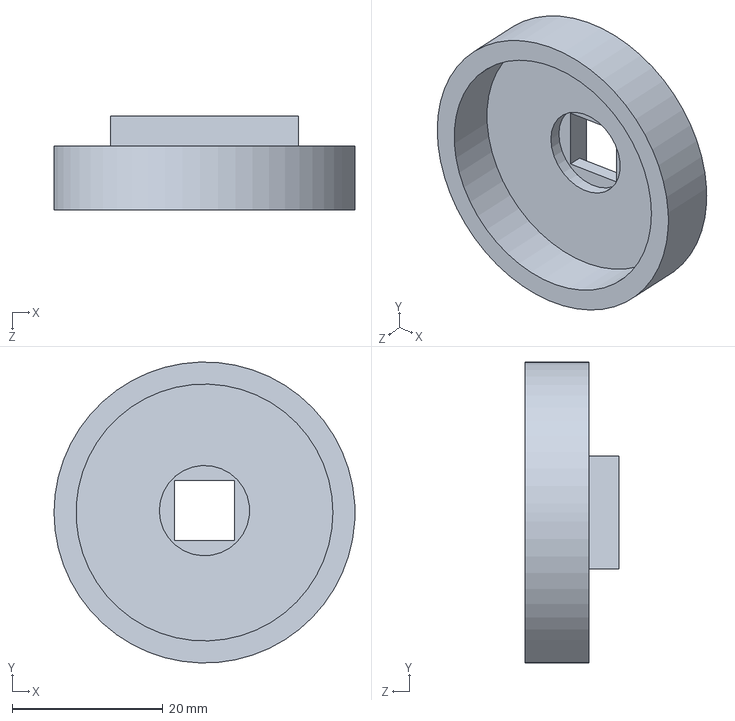
[picture p61: CAD file, 2018-11-27]
Mechanical Design/SolidWorks Assemblies and Parts/CS-Mount Telescope Adapter.SLDPRT
40.0 x 40.0 x 12.5 mm
