james-hepworth/masters/Mechanical Design/SolidWorks Assemblies and Parts/OVA5647_IR-Glas.SLDPRT

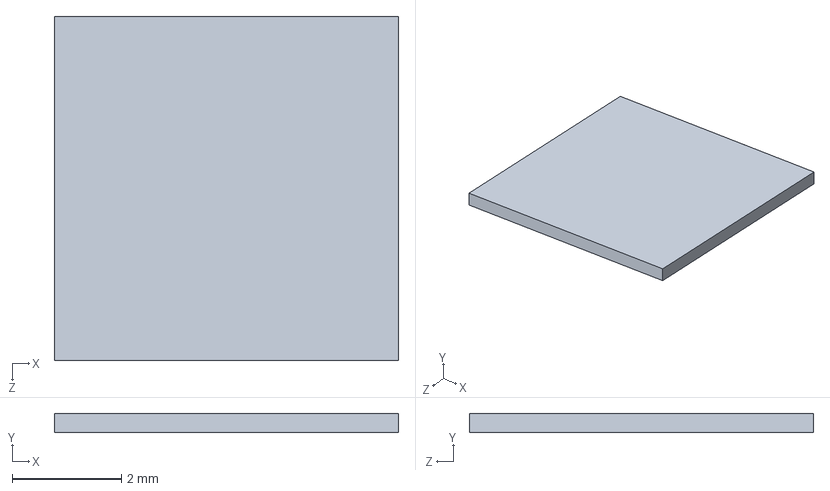
[picture p62: CAD file, 2018-11-27]
Mechanical Design/SolidWorks Assemblies and Parts/OVA5647_IR-Glas.SLDPRT
6.30 x 0.35 x 6.30 mm
