james-hepworth/masters/Mechanical Design/SolidWorks Assemblies and Parts/Lense Tube.SLDPRT

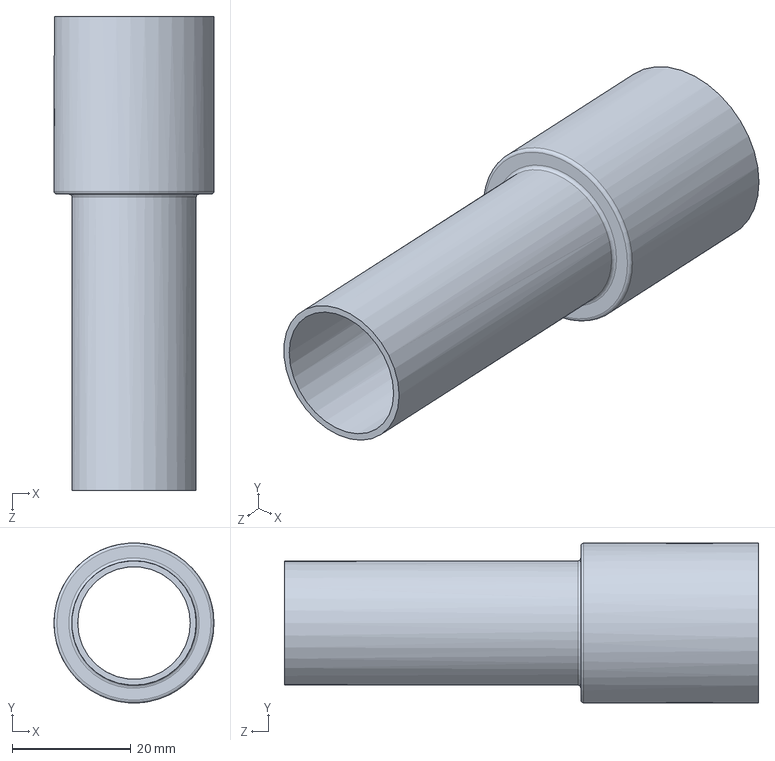
[picture p63: CAD file, 2018-11-27]
Mechanical Design/SolidWorks Assemblies and Parts/Lense Tube.SLDPRT
27.0 x 27.0 x 80.0 mm
