james-hepworth/masters/Mechanical Design/SolidWorks Assemblies and Parts/Raspberry Pi Cam.SLDPRT

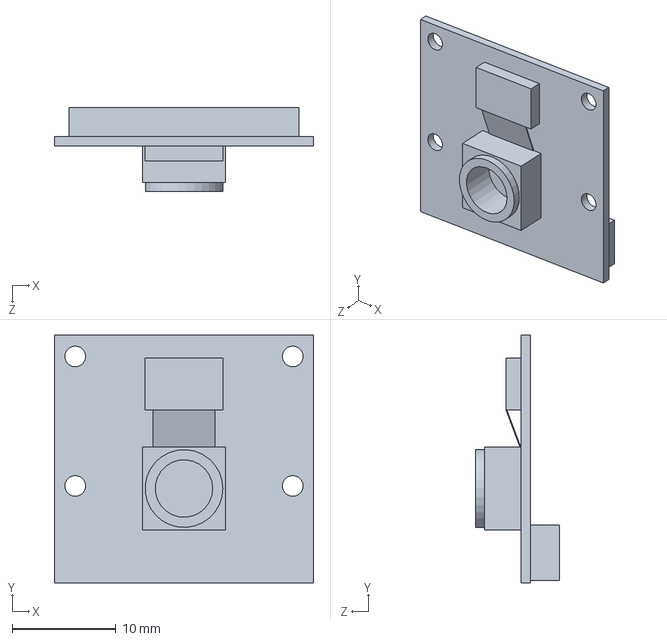
[picture p64: CAD file, 2018-11-27]
Mechanical Design/SolidWorks Assemblies and Parts/Raspberry Pi Cam.SLDPRT
25.0 x 23.9 x 8.15 mm
