james-hepworth/masters/Mechanical Design/SolidWorks Assemblies and Parts/Mass Block CNC L.SLDPRT

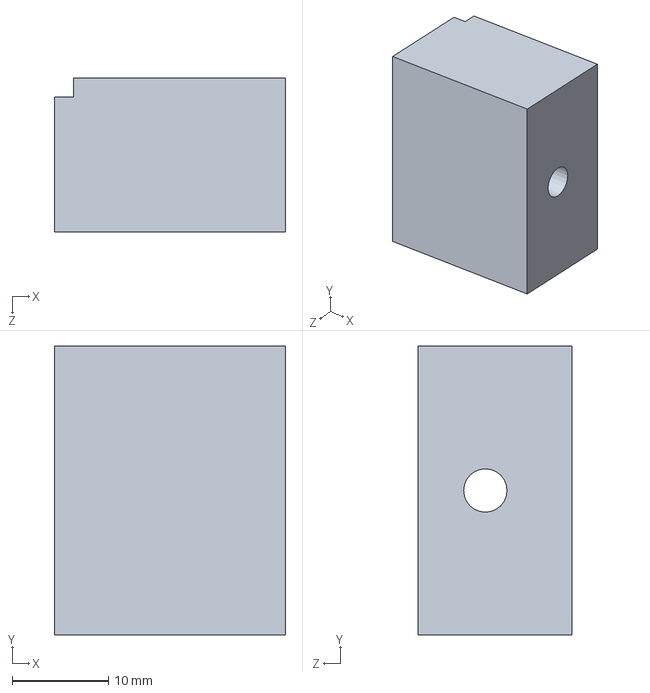
[picture p65: CAD file, 2018-11-27]
Mechanical Design/SolidWorks Assemblies and Parts/Mass Block CNC L.SLDPRT
24.0 x 30.0 x 16.0 mm
