james-hepworth/masters/Mechanical Design/SolidWorks Assemblies and Parts/Resistor small.SLDPRT

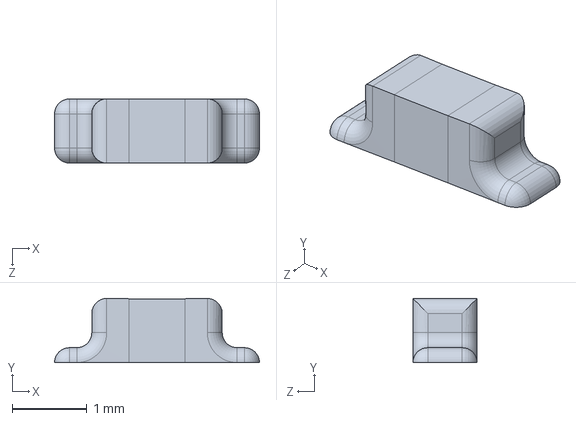
[picture p66: CAD file, 2018-11-27]
Mechanical Design/SolidWorks Assemblies and Parts/Resistor small.SLDPRT
2.75 x 0.86 x 0.86 mm
