james-hepworth/masters/Mechanical Design/SolidWorks Assemblies and Parts/Bearing Mount.SLDPRT

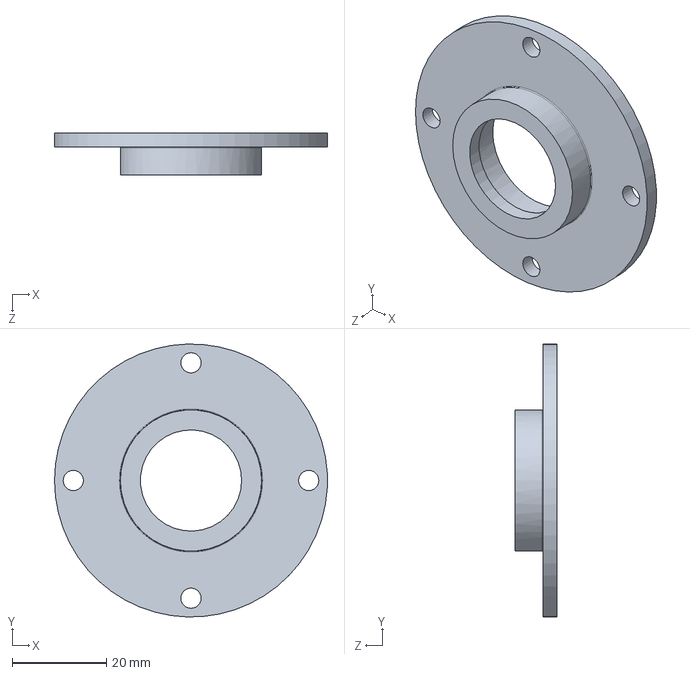
[picture p67: CAD file, 2018-11-27]
Mechanical Design/SolidWorks Assemblies and Parts/Bearing Mount.SLDPRT
58.0 x 58.0 x 9.00 mm
