james-hepworth/masters/Mechanical Design/SolidWorks Assemblies and Parts/Secondary Mirror Mount.SLDPRT

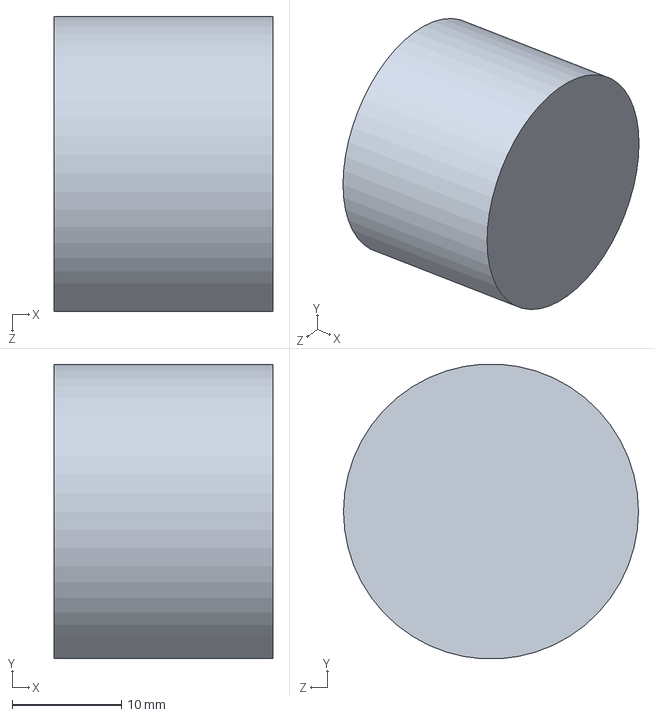
[picture p68: CAD file, 2018-11-27]
Mechanical Design/SolidWorks Assemblies and Parts/Secondary Mirror Mount.SLDPRT
20.0 x 26.9 x 27.0 mm
