james-hepworth/masters/Mechanical Design/SolidWorks Assemblies and Parts/Vertical Suport1.SLDPRT

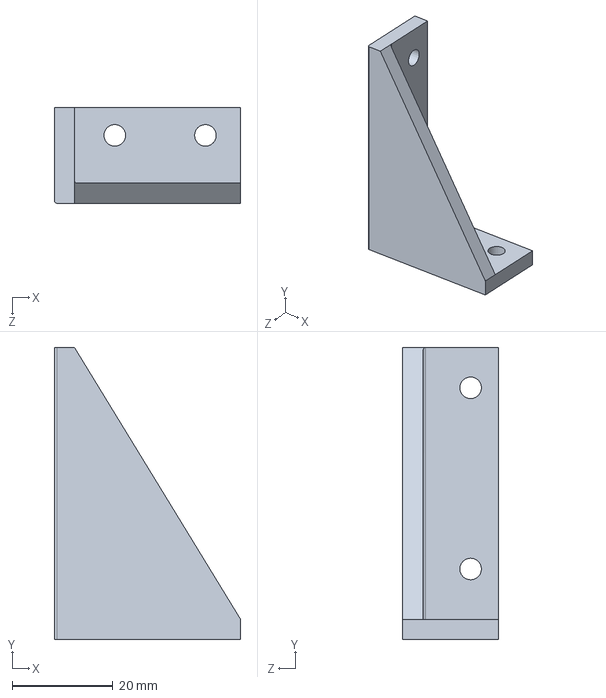
[picture p69: CAD file, 2018-11-27]
Mechanical Design/SolidWorks Assemblies and Parts/Vertical Suport1.SLDPRT
37.0 x 58.0 x 19.0 mm
