james-hepworth/masters/Mechanical Design/SolidWorks Assemblies and Parts/CS-Mount Adapter.SLDPRT

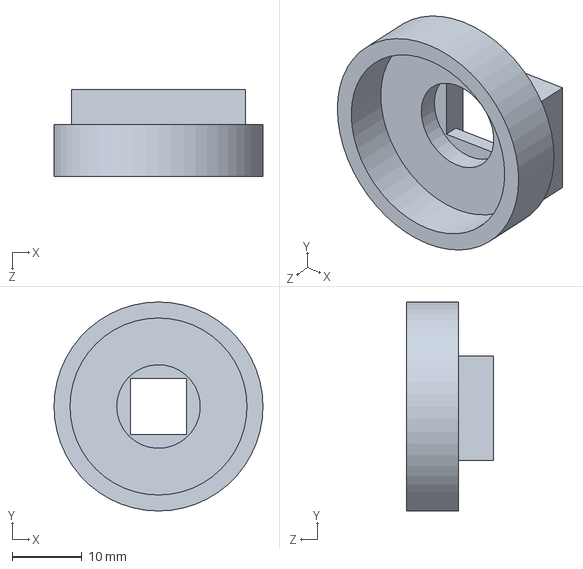
[picture p70: CAD file, 2018-11-27]
Mechanical Design/SolidWorks Assemblies and Parts/CS-Mount Adapter.SLDPRT
30.0 x 30.0 x 12.5 mm
