james-hepworth/masters/Mechanical Design/SolidWorks Assemblies and Parts/Primary Mirror.SLDPRT

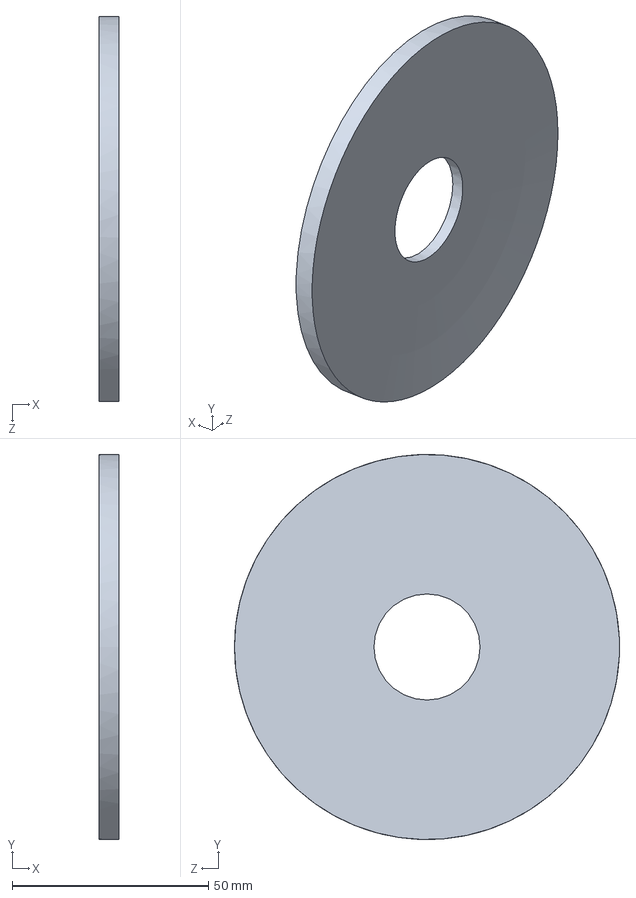
[picture p71: CAD file, 2018-11-27]
Mechanical Design/SolidWorks Assemblies and Parts/Primary Mirror.SLDPRT
5.00 x 98.0 x 98.0 mm
