james-hepworth/masters/Mechanical Design/SolidWorks Assemblies and Parts/Eyepiece 1.SLDPRT

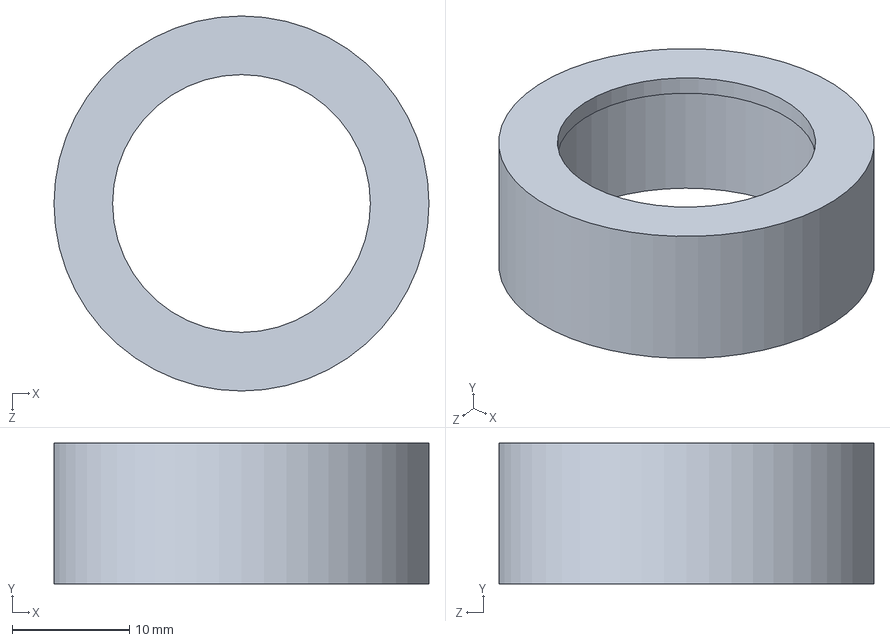
[picture p72: CAD file, 2018-11-27]
Mechanical Design/SolidWorks Assemblies and Parts/Eyepiece 1.SLDPRT
32.0 x 12.0 x 32.0 mm
