james-hepworth/masters/Mechanical Design/SolidWorks Assemblies and Parts/Side2.SLDPRT

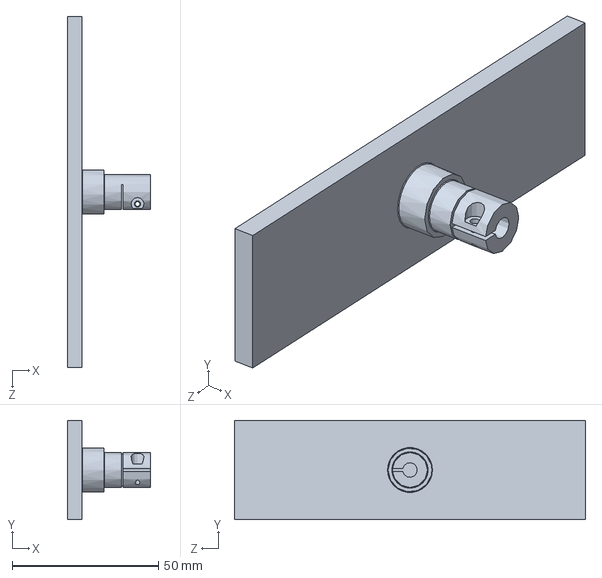
[picture p73: CAD file, 2018-11-27]
Mechanical Design/SolidWorks Assemblies and Parts/Side2.SLDPRT
28.5 x 34.0 x 120.0 mm
