james-hepworth/masters/Mechanical Design/SolidWorks Assemblies and Parts/Eyepiece 3.SLDPRT

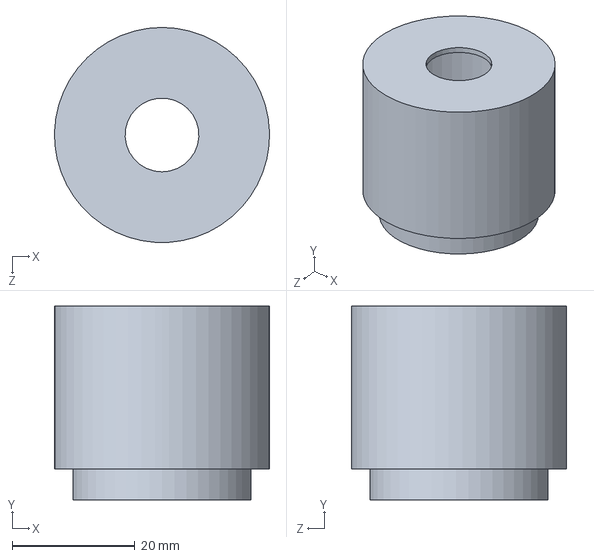
[picture p74: CAD file, 2018-11-27]
Mechanical Design/SolidWorks Assemblies and Parts/Eyepiece 3.SLDPRT
35.0 x 31.5 x 35.0 mm
