james-hepworth/masters/Mechanical Design/SolidWorks Assemblies and Parts/Cam Tube.SLDPRT

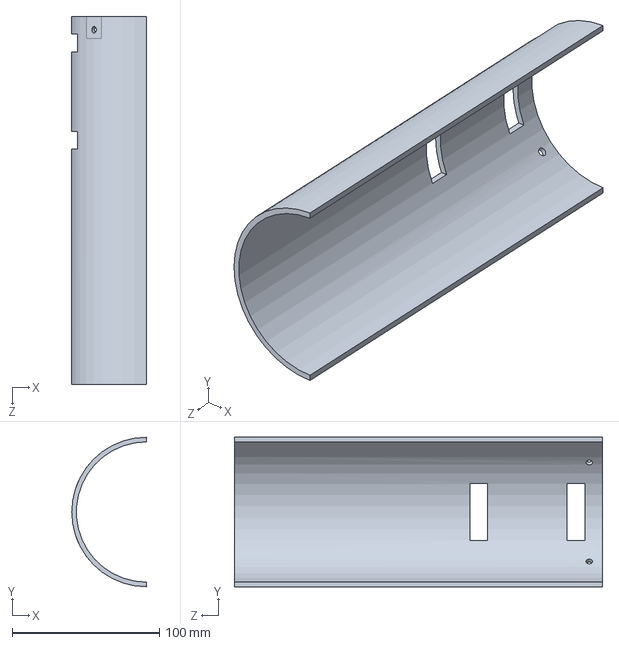
[picture p75: CAD file, 2018-11-27]
Mechanical Design/SolidWorks Assemblies and Parts/Cam Tube.SLDPRT
50.6 x 101.6 x 250.0 mm
