james-hepworth/masters/Mechanical Design/SolidWorks Assemblies and Parts/Pot Coupling1.SLDPRT

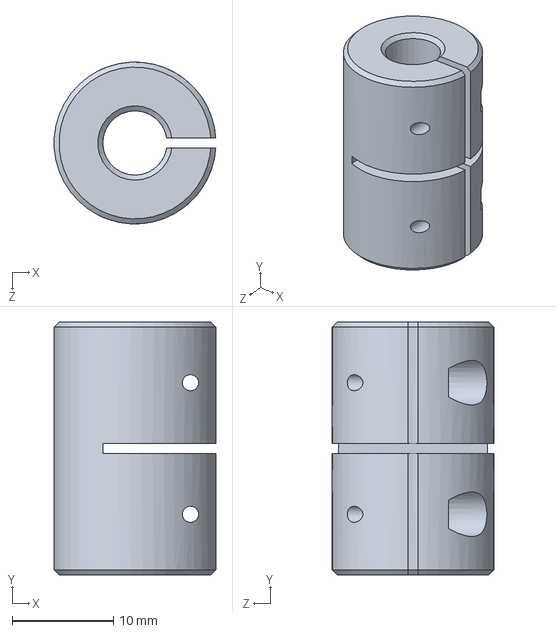
[picture p76: CAD file, 2018-11-27]
Mechanical Design/SolidWorks Assemblies and Parts/Pot Coupling1.SLDPRT
16.0 x 25.0 x 16.0 mm
