james-hepworth/masters/Mechanical Design/SolidWorks Assemblies and Parts/System Base.SLDPRT

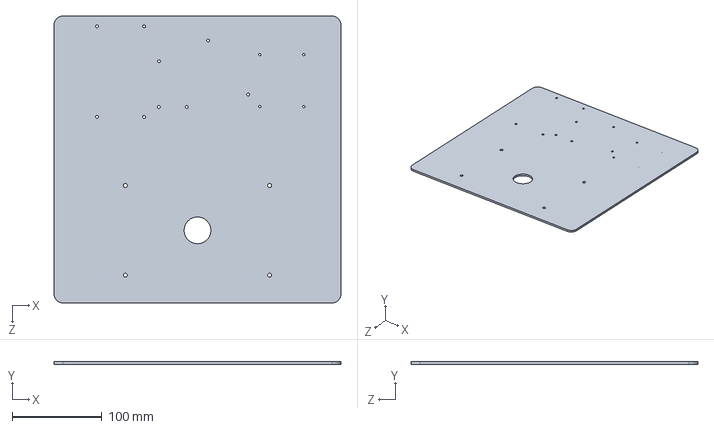
[picture p77: CAD file, 2018-11-27]
Mechanical Design/SolidWorks Assemblies and Parts/System Base.SLDPRT
320.0 x 3.00 x 320.0 mm
