james-hepworth/masters/Mechanical Design/SolidWorks Assemblies and Parts/Eyepiece 2.SLDPRT

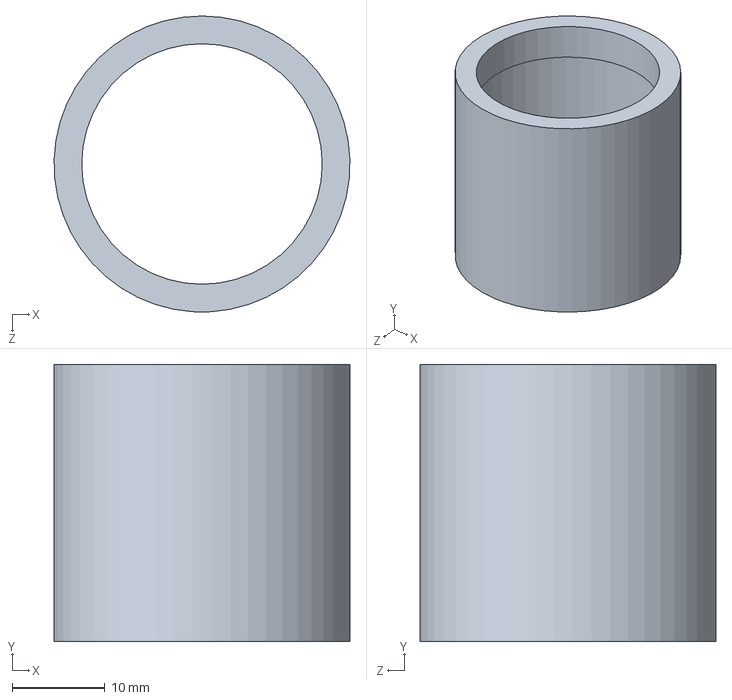
[picture p78: CAD file, 2018-11-27]
Mechanical Design/SolidWorks Assemblies and Parts/Eyepiece 2.SLDPRT
32.0 x 30.0 x 32.0 mm
