james-hepworth/masters/Mechanical Design/SolidWorks Assemblies and Parts/127 TN9_PART1.sldprt

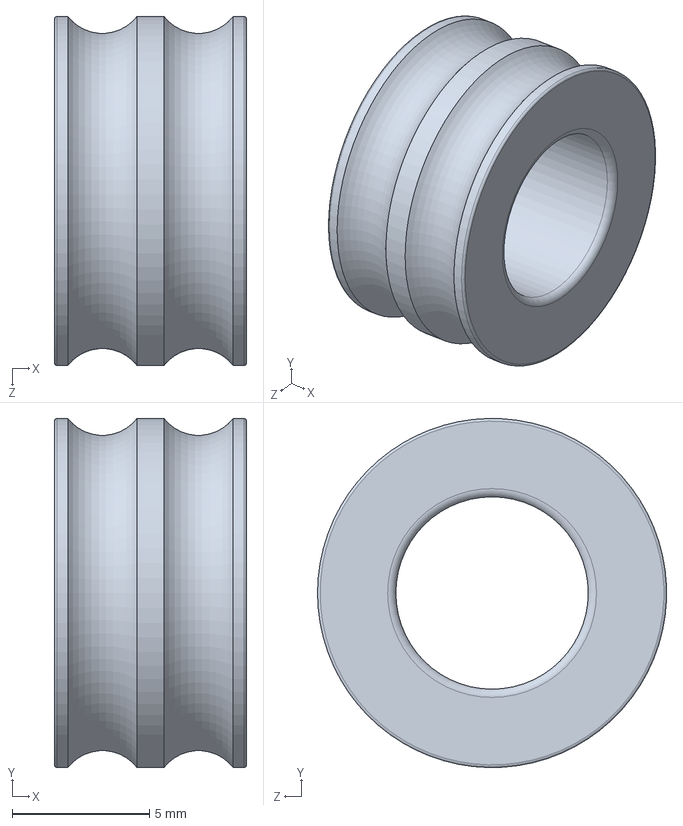
[picture p79: CAD file, 2018-11-27]
Mechanical Design/SolidWorks Assemblies and Parts/127 TN9_PART1.sldprt
7.00 x 12.7 x 12.7 mm
