james-hepworth/masters/Mechanical Design/SolidWorks Assemblies and Parts/Gimbal Support B.SLDPRT

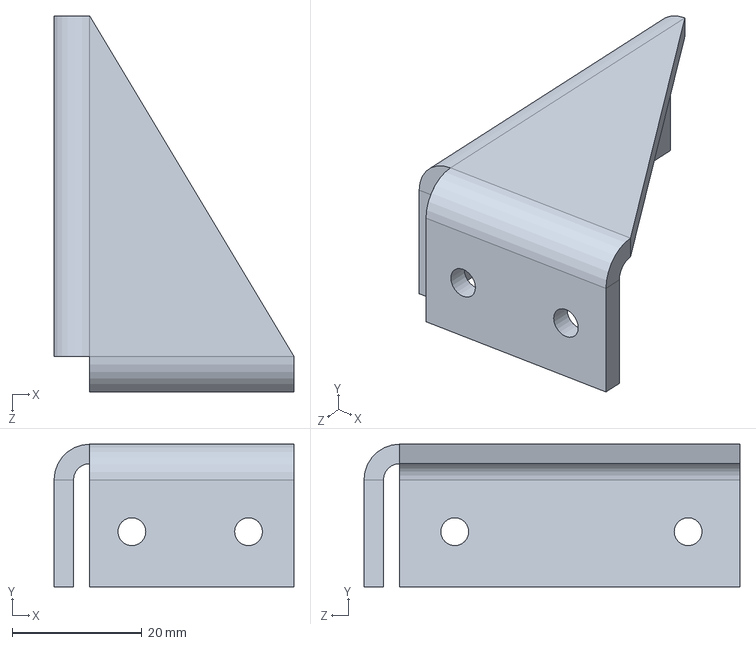
[picture p80: CAD file, 2018-11-27]
Mechanical Design/SolidWorks Assemblies and Parts/Gimbal Support B.SLDPRT
37.0 x 22.0 x 58.0 mm
