james-hepworth/masters/Mechanical Design/SolidWorks Assemblies and Parts/radial ball bearing_68_skf.sldprt

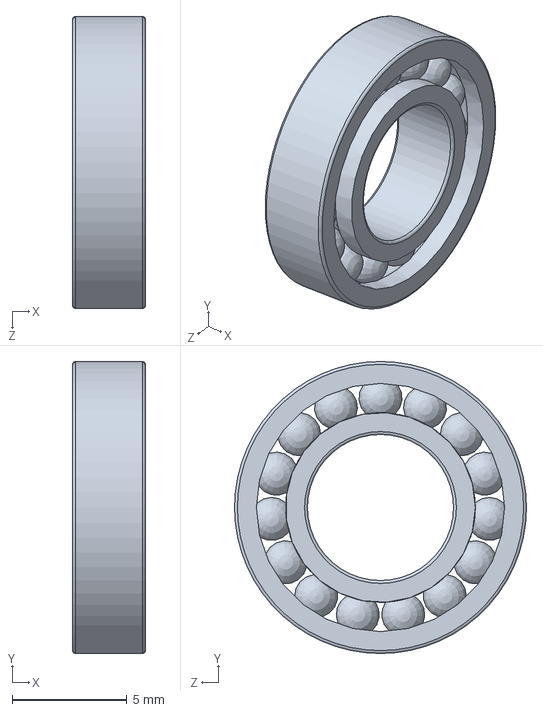
[picture p81: CAD file, 2018-11-27]
Mechanical Design/SolidWorks Assemblies and Parts/radial ball bearing_68_skf.sldprt
3.17 x 12.7 x 12.7 mm
