james-hepworth/masters/Mechanical Design/SolidWorks Assemblies and Parts/Retaining Disk 1.SLDPRT

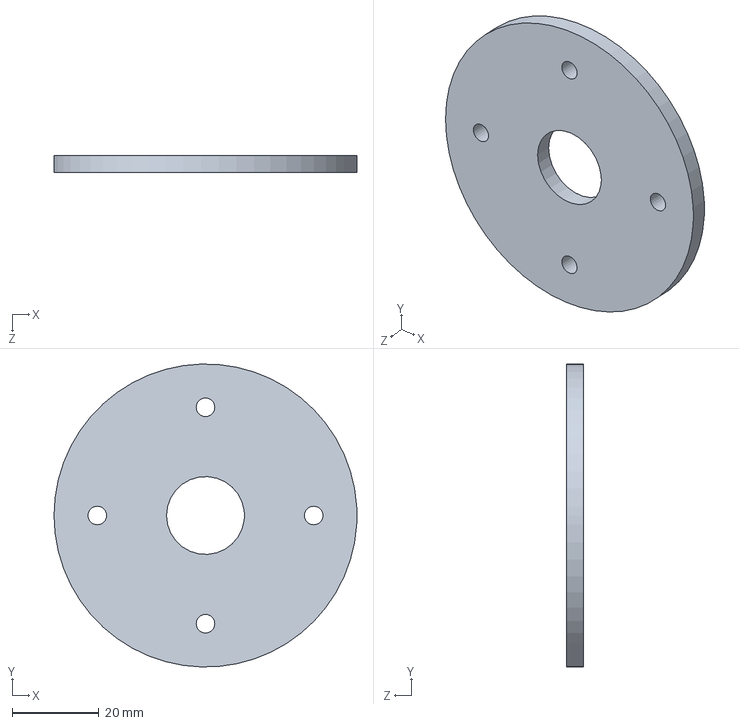
[picture p82: CAD file, 2018-11-27]
Mechanical Design/SolidWorks Assemblies and Parts/Retaining Disk 1.SLDPRT
70.0 x 70.0 x 4.00 mm
