james-hepworth/masters/Mechanical Design/SolidWorks Assemblies and Parts/Pot X-Mount.SLDPRT

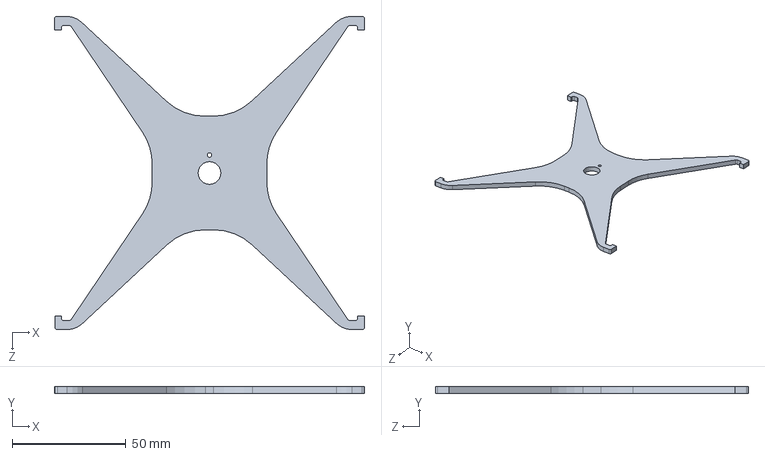
[picture p83: CAD file, 2018-11-27]
Mechanical Design/SolidWorks Assemblies and Parts/Pot X-Mount.SLDPRT
136.5 x 3.00 x 138.0 mm
