james-hepworth/masters/Mechanical Design/SolidWorks Assemblies and Parts/Side2_Turned.SLDPRT

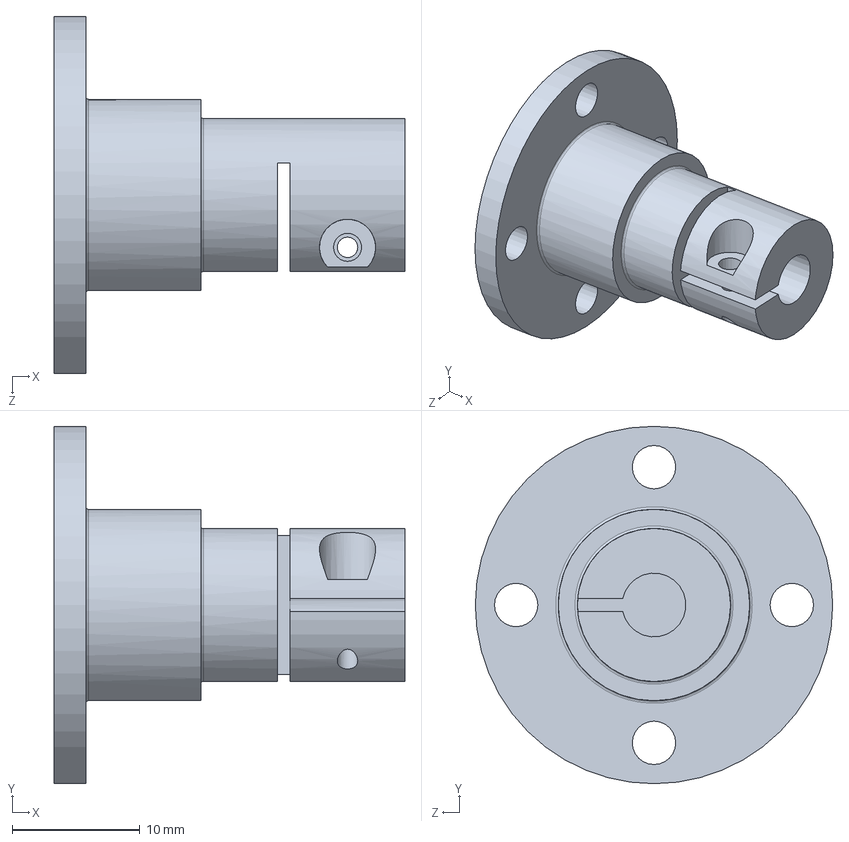
[picture p84: CAD file, 2018-11-27]
Mechanical Design/SolidWorks Assemblies and Parts/Side2_Turned.SLDPRT
27.5 x 28.0 x 28.0 mm
