james-hepworth/masters/Mechanical Design/SolidWorks Assemblies and Parts/View Finder.SLDPRT

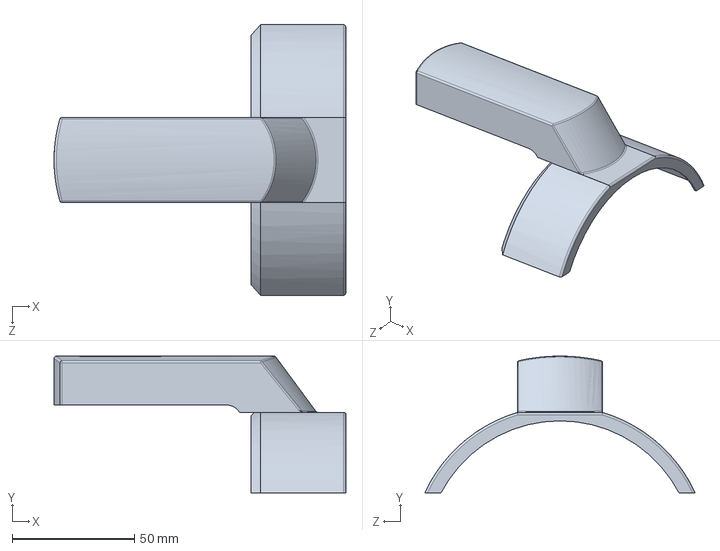
[picture p85: CAD file, 2018-11-27]
Mechanical Design/SolidWorks Assemblies and Parts/View Finder.SLDPRT
119.6 x 56.0 x 110.8 mm
