james-hepworth/masters/Mechanical Design/SolidWorks Assemblies and Parts/Resistor black.SLDPRT

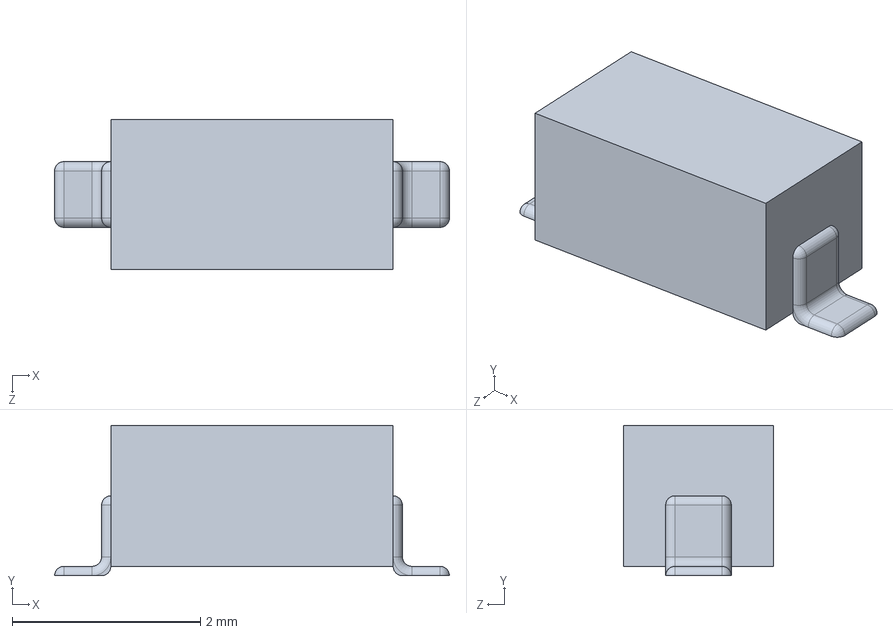
[picture p86: CAD file, 2018-11-27]
Mechanical Design/SolidWorks Assemblies and Parts/Resistor black.SLDPRT
4.20 x 1.60 x 1.60 mm
