james-hepworth/masters/Mechanical Design/SolidWorks Assemblies and Parts/Resistor small black.SLDPRT

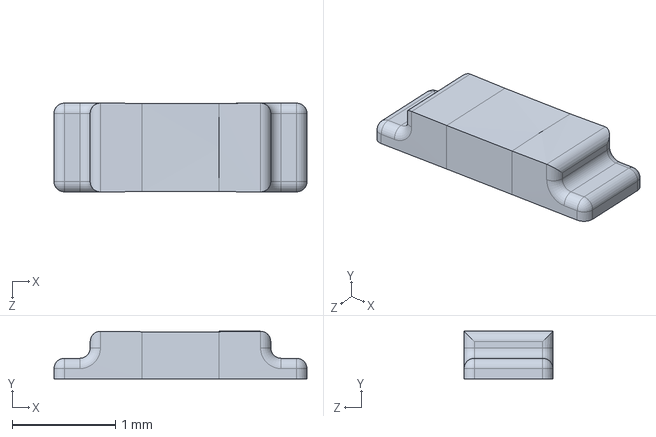
[picture p87: CAD file, 2018-11-27]
Mechanical Design/SolidWorks Assemblies and Parts/Resistor small black.SLDPRT
2.45 x 0.46 x 0.86 mm
