james-hepworth/masters/Mechanical Design/SolidWorks Assemblies and Parts/Lens 2.SLDPRT

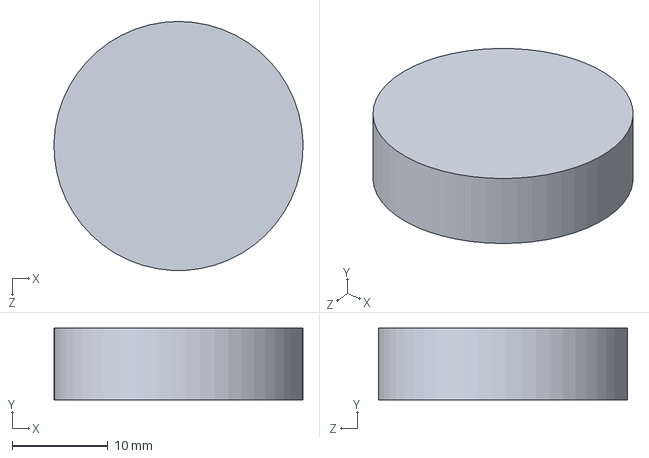
[picture p88: CAD file, 2018-11-27]
Mechanical Design/SolidWorks Assemblies and Parts/Lens 2.SLDPRT
26.0 x 7.50 x 26.0 mm
