james-hepworth/masters/Mechanical Design/SolidWorks Assemblies and Parts/127 TN9_PART4.sldprt

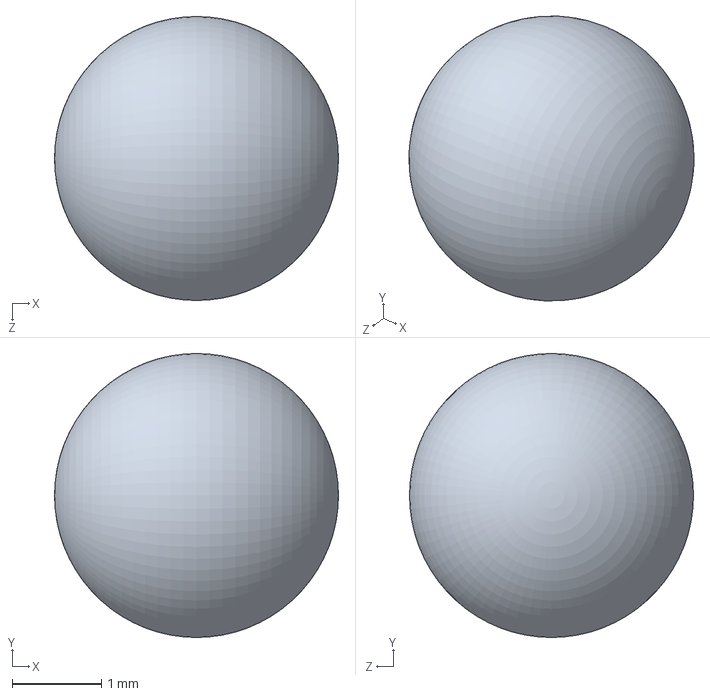
[picture p89: CAD file, 2018-11-27]
Mechanical Design/SolidWorks Assemblies and Parts/127 TN9_PART4.sldprt
3.17 x 3.18 x 3.17 mm
