james-hepworth/masters/Mechanical Design/SolidWorks Assemblies and Parts/3257 Mount.SLDPRT

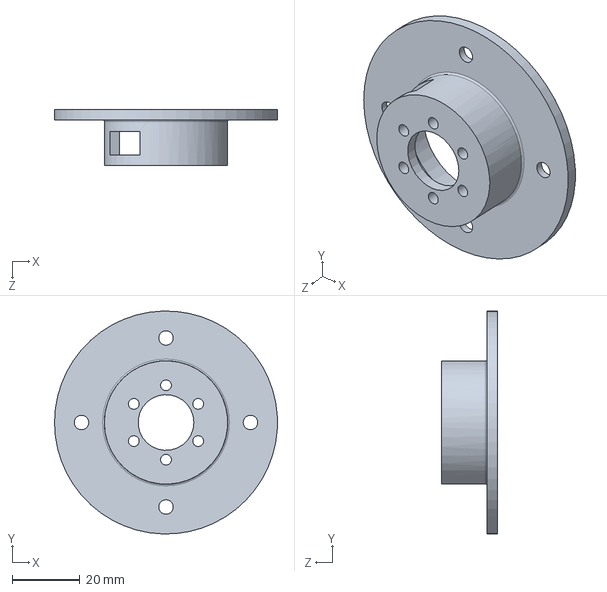
[picture p90: CAD file, 2018-11-27]
Mechanical Design/SolidWorks Assemblies and Parts/3257 Mount.SLDPRT
66.0 x 66.0 x 16.5 mm
