james-hepworth/masters/Mechanical Design/SolidWorks Assemblies and Parts/Lens 1.SLDPRT

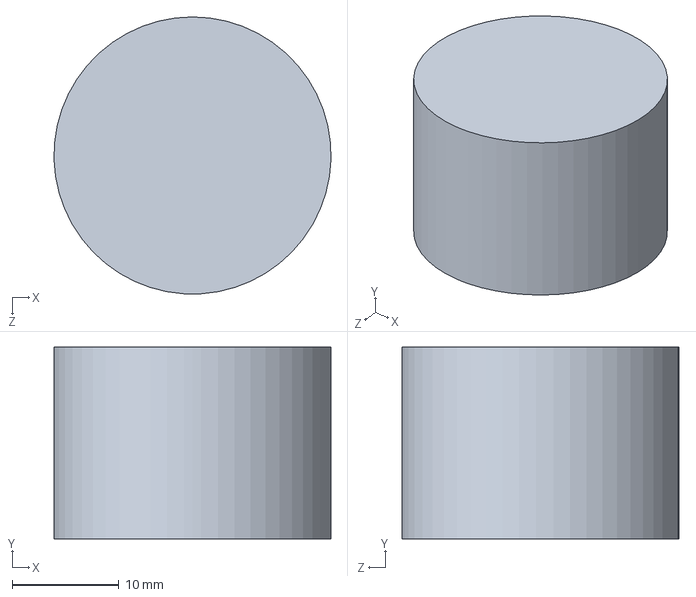
[picture p91: CAD file, 2018-11-27]
Mechanical Design/SolidWorks Assemblies and Parts/Lens 1.SLDPRT
26.0 x 18.0 x 26.0 mm
