james-hepworth/masters/Mechanical Design/SolidWorks Assemblies and Parts/IMU mount.SLDPRT

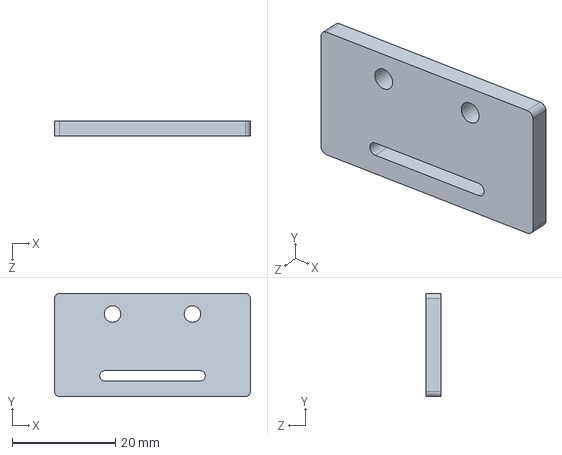
[picture p92: CAD file, 2018-11-27]
Mechanical Design/SolidWorks Assemblies and Parts/IMU mount.SLDPRT
38.0 x 20.0 x 3.00 mm
