james-hepworth/masters/Mechanical Design/SolidWorks Assemblies and Parts/Cam Holder.SLDPRT

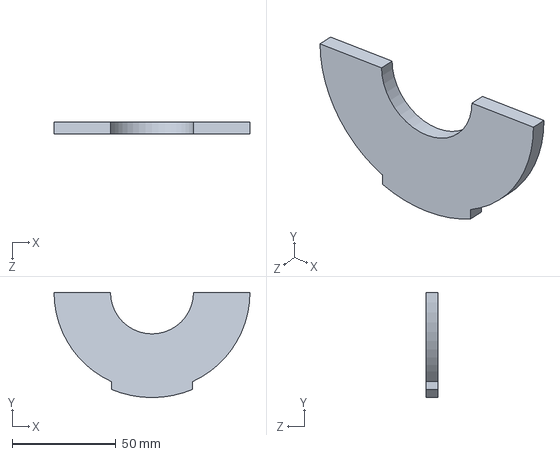
[picture p93: CAD file, 2018-11-27]
Mechanical Design/SolidWorks Assemblies and Parts/Cam Holder.SLDPRT
94.5 x 50.7 x 6.00 mm
