james-hepworth/masters/Mechanical Design/SolidWorks Assemblies and Parts/OVA5647_Lens.SLDPRT

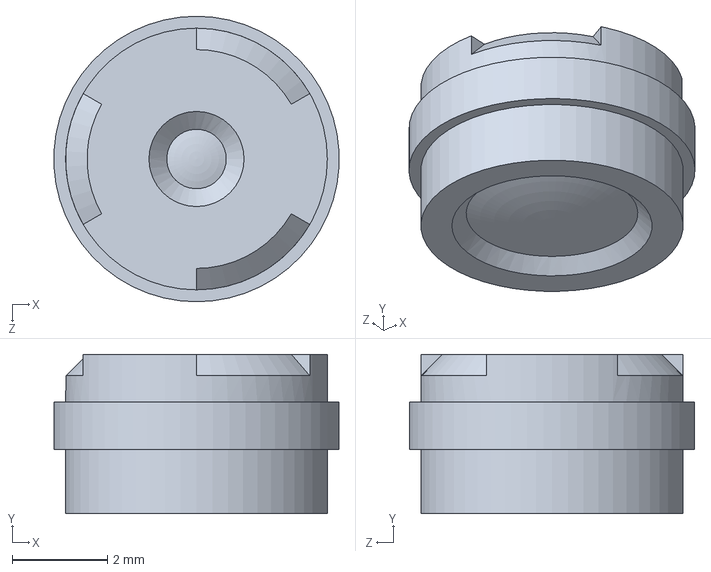
[picture p94: CAD file, 2018-11-27]
Mechanical Design/SolidWorks Assemblies and Parts/OVA5647_Lens.SLDPRT
5.99 x 3.35 x 6.00 mm
