james-hepworth/masters/Mechanical Design/SolidWorks Assemblies and Parts/pin header.SLDPRT

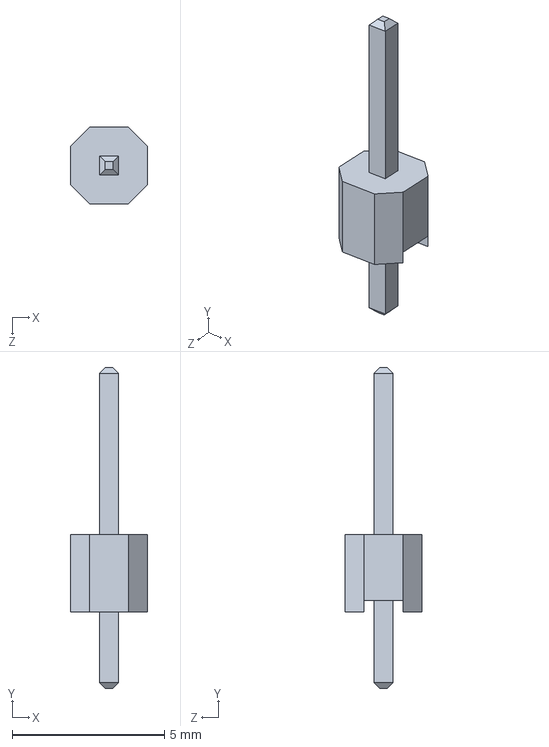
[picture p95: CAD file, 2018-11-27]
Mechanical Design/SolidWorks Assemblies and Parts/pin header.SLDPRT
2.54 x 10.6 x 2.54 mm
