james-hepworth/masters/Mechanical Design/SolidWorks Assemblies and Parts/System Base4.SLDPRT

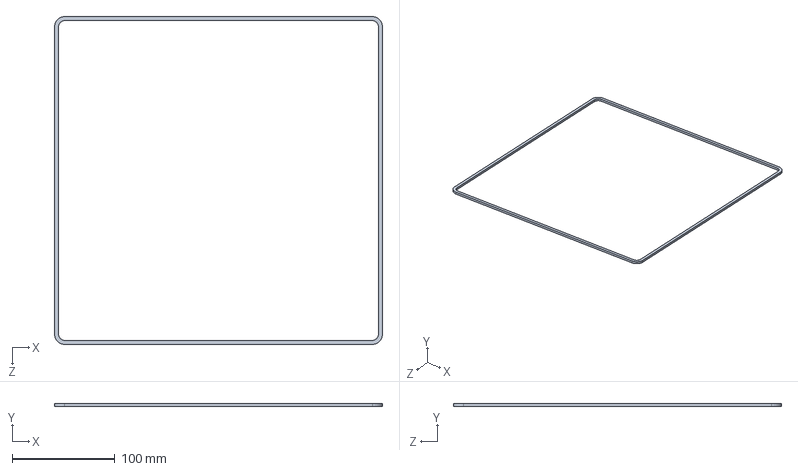
[picture p96: CAD file, 2018-11-27]
Mechanical Design/SolidWorks Assemblies and Parts/System Base4.SLDPRT
320.0 x 3.00 x 320.0 mm
