james-hepworth/masters/Mechanical Design/SolidWorks Assemblies and Parts/OVA5647_Pigtail.SLDPRT

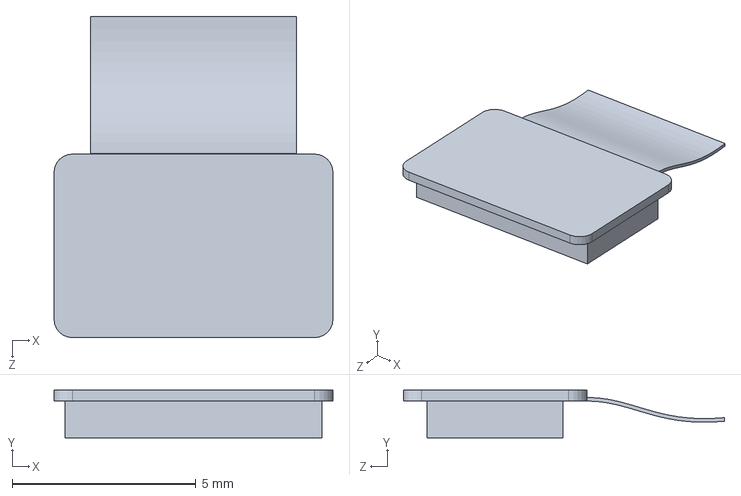
[picture p97: CAD file, 2018-11-27]
Mechanical Design/SolidWorks Assemblies and Parts/OVA5647_Pigtail.SLDPRT
7.60 x 1.30 x 8.75 mm
