james-hepworth/masters/Mechanical Design/SolidWorks Assemblies and Parts/Upright1.SLDPRT

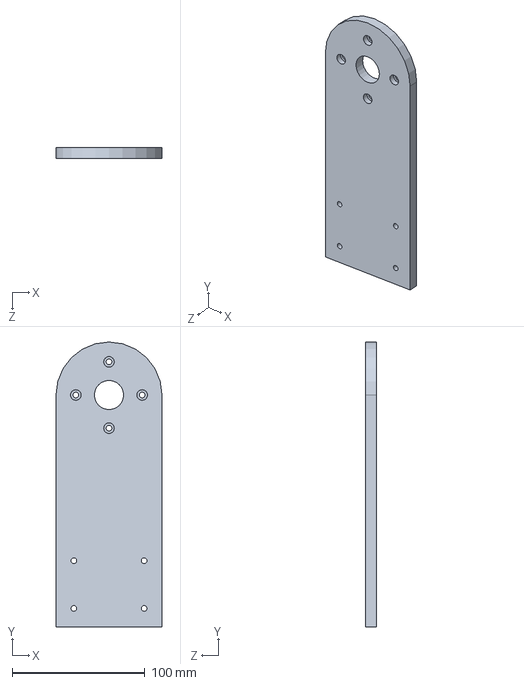
[picture p98: CAD file, 2018-11-27]
Mechanical Design/SolidWorks Assemblies and Parts/Upright1.SLDPRT
80.0 x 215.0 x 8.00 mm
