james-hepworth/masters/Mechanical Design/SolidWorks Assemblies and Parts/Telescope Clamp.SLDPRT

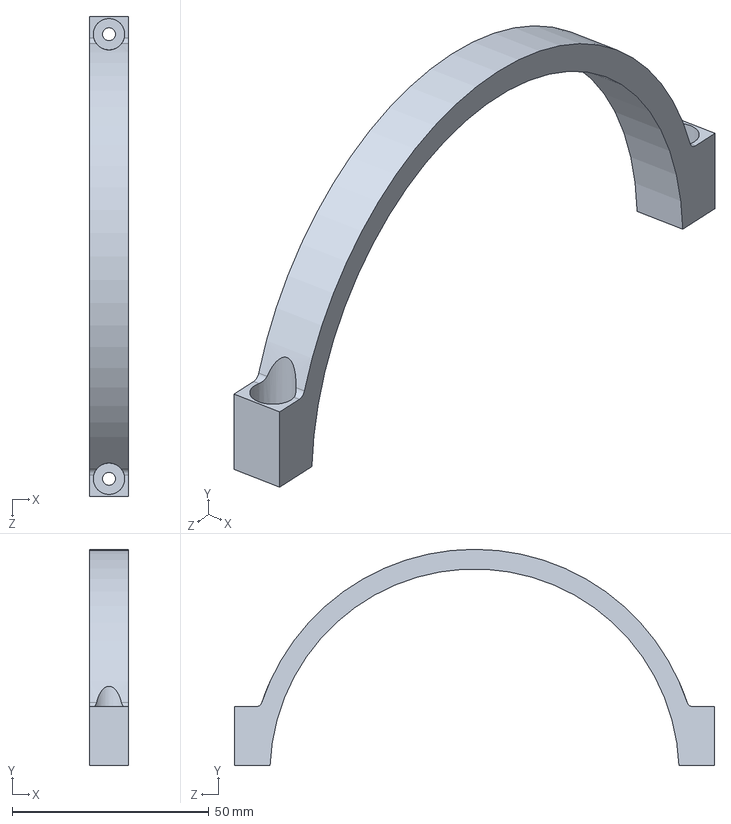
[picture p99: CAD file, 2018-11-27]
Mechanical Design/SolidWorks Assemblies and Parts/Telescope Clamp.SLDPRT
10.0 x 55.0 x 122.0 mm
