james-hepworth/masters/Mechanical Design/SolidWorks Assemblies and Parts/Telescope Mass.SLDPRT

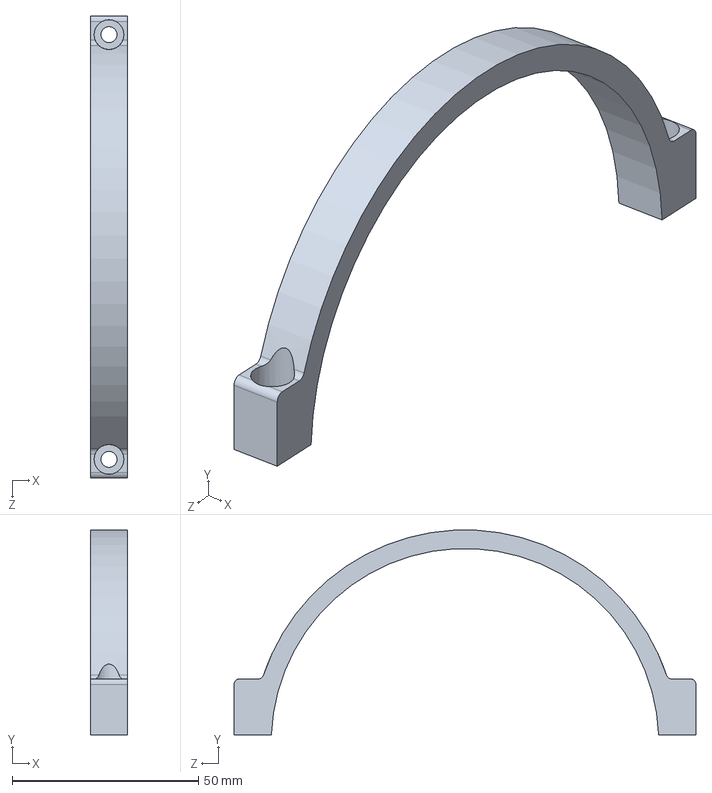
[picture p100: CAD file, 2018-11-27]
Mechanical Design/SolidWorks Assemblies and Parts/Telescope Mass.SLDPRT
10.0 x 54.9 x 124.0 mm
