james-hepworth/masters/Mechanical Design/SolidWorks Assemblies and Parts/System Base2.SLDPRT

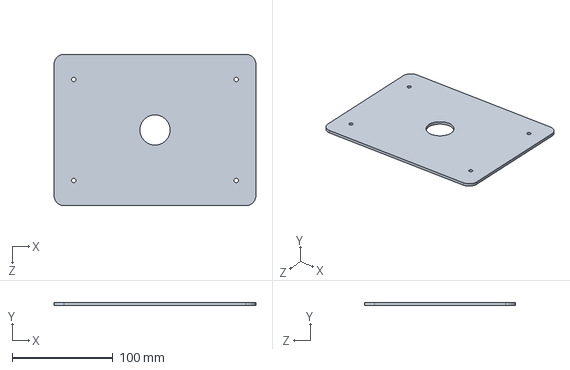
[picture p101: CAD file, 2018-11-27]
Mechanical Design/SolidWorks Assemblies and Parts/System Base2.SLDPRT
200.0 x 3.00 x 150.0 mm
