james-hepworth/masters/Mechanical Design/SolidWorks Assemblies and Parts/Actaul Lens.SLDPRT

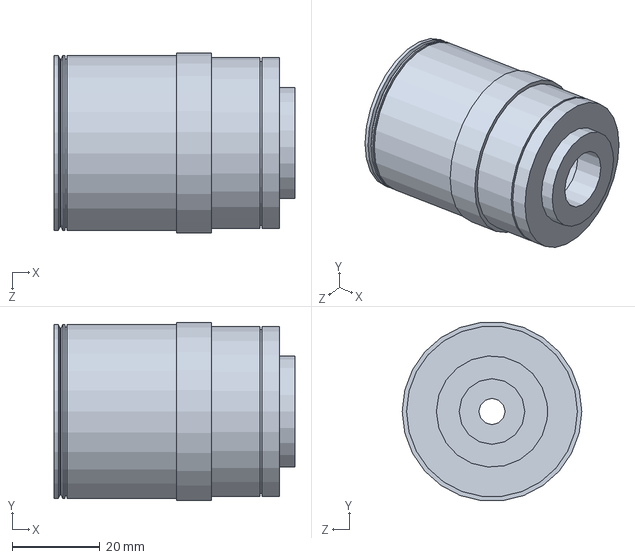
[picture p102: CAD file, 2018-11-27]
Mechanical Design/SolidWorks Assemblies and Parts/Actaul Lens.SLDPRT
55.0 x 40.7 x 41.0 mm
