james-hepworth/masters/Mechanical Design/SolidWorks Assemblies and Parts/S2NH chip.SLDPRT

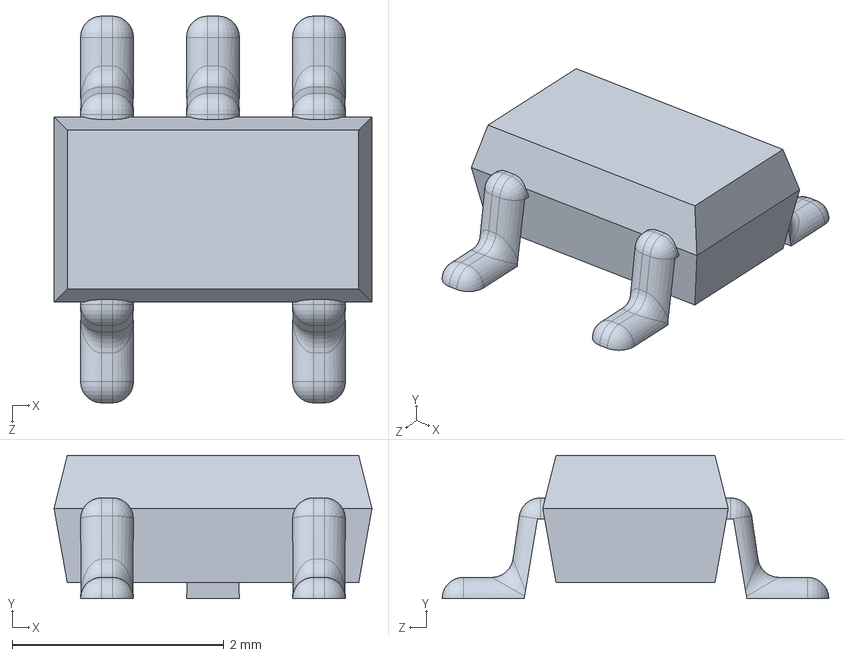
[picture p103: CAD file, 2018-11-27]
Mechanical Design/SolidWorks Assemblies and Parts/S2NH chip.SLDPRT
3.00 x 1.35 x 3.65 mm
