james-hepworth/masters/Mechanical Design/SolidWorks Assemblies and Parts/Tube.SLDPRT

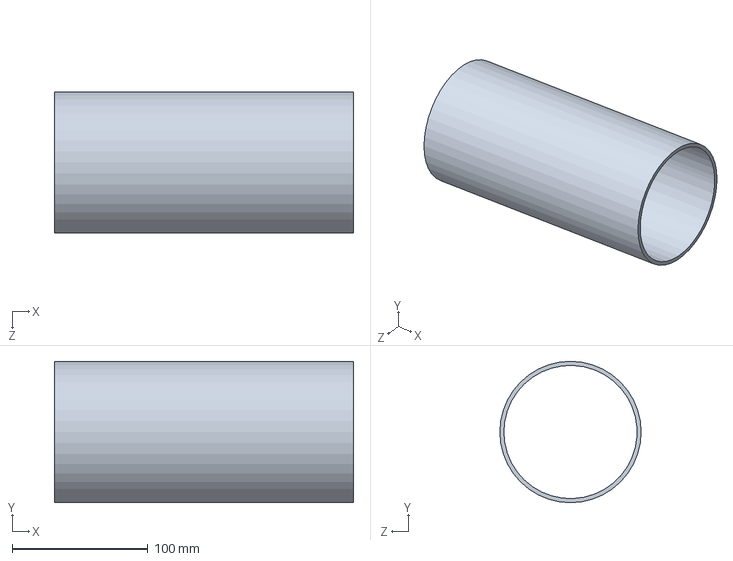
[picture p104: CAD file, 2018-11-27]
Mechanical Design/SolidWorks Assemblies and Parts/Tube.SLDPRT
220.0 x 104.0 x 104.0 mm
