james-hepworth/masters/Mechanical Design/SolidWorks Assemblies and Parts/Body Mount.SLDPRT

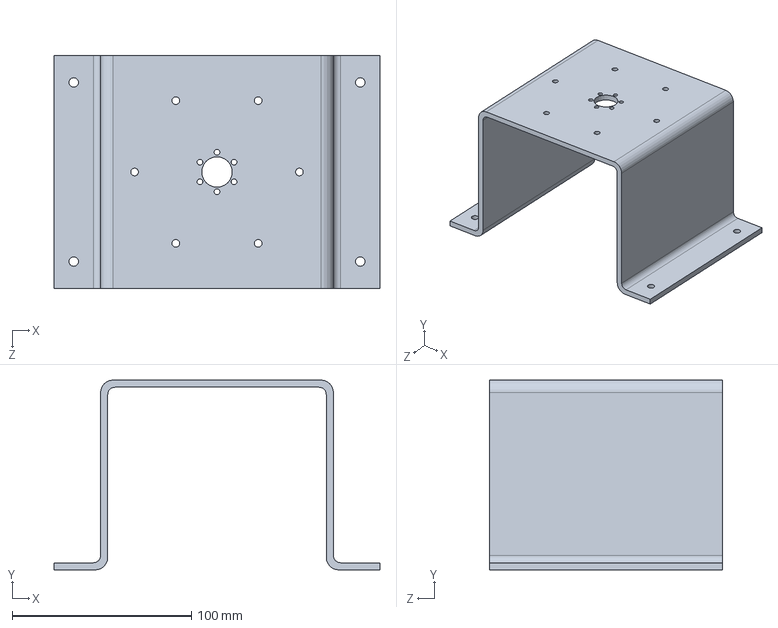
[picture p105: CAD file, 2018-11-27]
Mechanical Design/SolidWorks Assemblies and Parts/Body Mount.SLDPRT
182.0 x 106.0 x 130.0 mm
