james-hepworth/masters/Mechanical Design/SolidWorks Assemblies and Parts/Vishay 357 Pot.SLDPRT

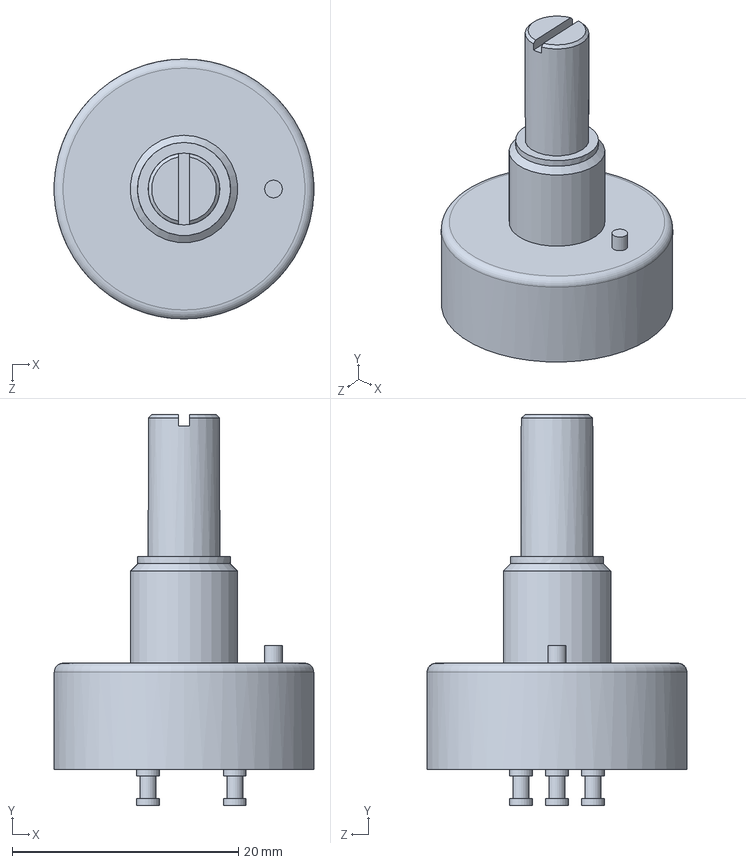
[picture p106: CAD file, 2018-11-27]
Mechanical Design/SolidWorks Assemblies and Parts/Vishay 357 Pot.SLDPRT
23.0 x 34.6 x 23.0 mm
