james-hepworth/masters/Mechanical Design/SolidWorks Assemblies and Parts/M5 Insert.SLDPRT

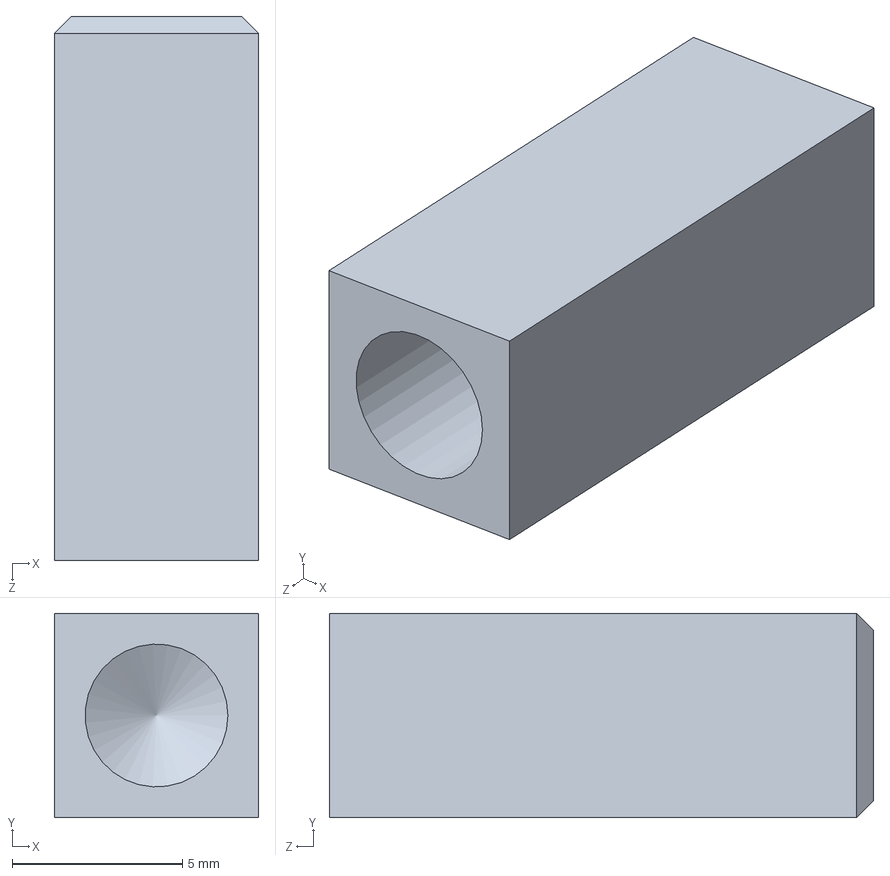
[picture p107: CAD file, 2018-11-27]
Mechanical Design/SolidWorks Assemblies and Parts/M5 Insert.SLDPRT
6.00 x 6.00 x 16.0 mm
