james-hepworth/masters/Mechanical Design/SolidWorks Assemblies and Parts/Cam Mount1.SLDPRT

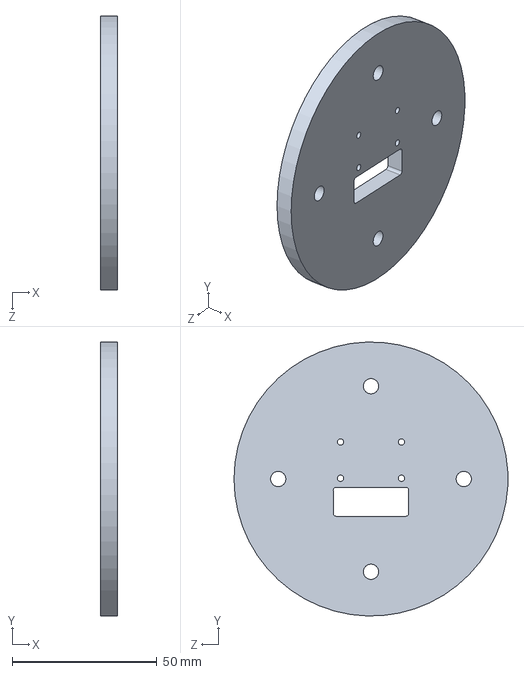
[picture p108: CAD file, 2018-11-27]
Mechanical Design/SolidWorks Assemblies and Parts/Cam Mount1.SLDPRT
6.00 x 94.5 x 94.5 mm
