james-hepworth/masters/Mechanical Design/SolidWorks Assemblies and Parts/Base.SLDPRT

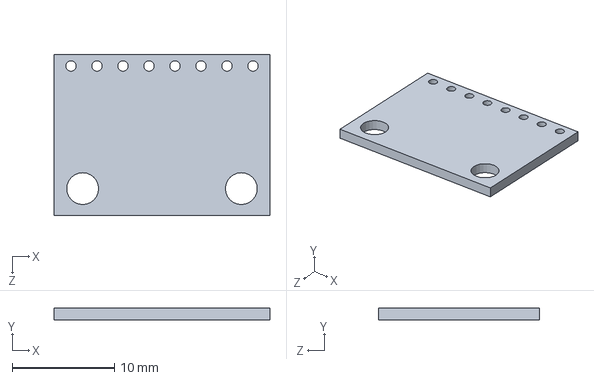
[picture p109: CAD file, 2018-11-27]
Mechanical Design/SolidWorks Assemblies and Parts/Base.SLDPRT
21.1 x 1.14 x 15.7 mm
