james-hepworth/masters/Mechanical Design/SolidWorks Assemblies and Parts/Filter.SLDPRT

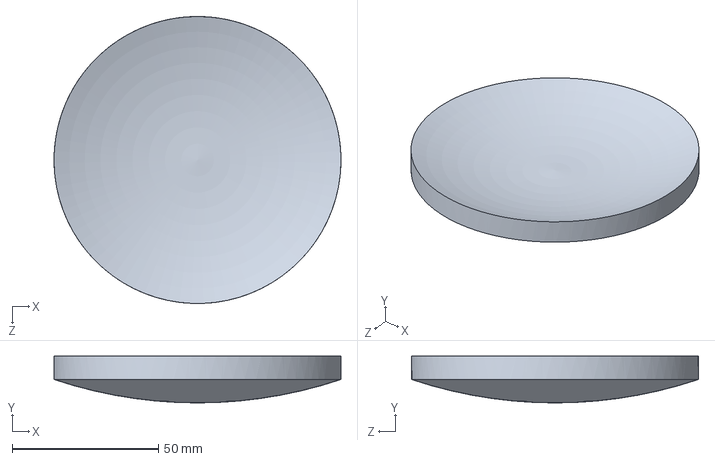
[picture p110: CAD file, 2018-11-27]
Mechanical Design/SolidWorks Assemblies and Parts/Filter.SLDPRT
98.0 x 16.0 x 98.0 mm
