james-hepworth/masters/Mechanical Design/SolidWorks Assemblies and Parts/Clamping Plate.SLDPRT

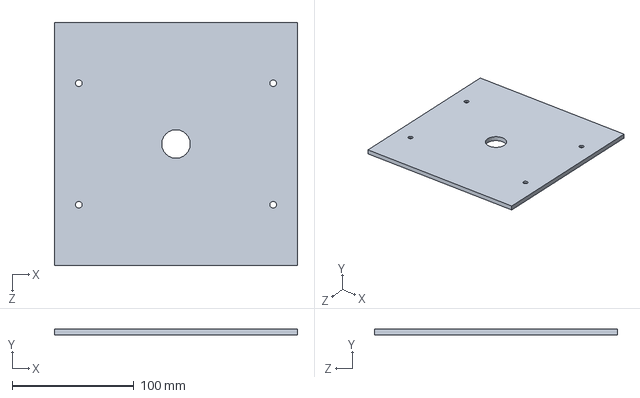
[picture p111: CAD file, 2018-11-27]
Mechanical Design/SolidWorks Assemblies and Parts/Clamping Plate.SLDPRT
200.0 x 5.00 x 200.0 mm
