james-hepworth/masters/Mechanical Design/SolidWorks Assemblies and Parts/Gimbal Base.SLDPRT

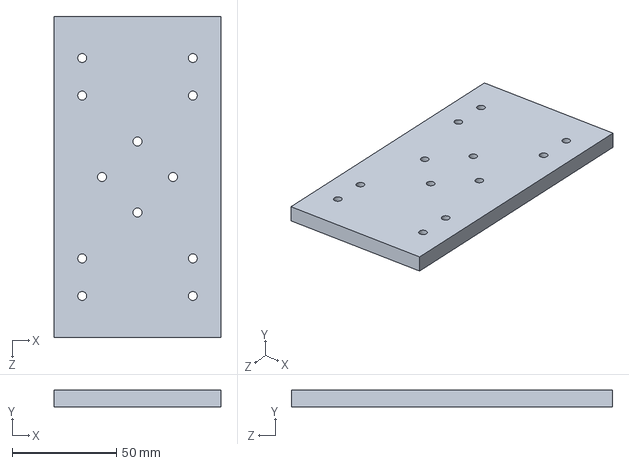
[picture p112: CAD file, 2018-11-27]
Mechanical Design/SolidWorks Assemblies and Parts/Gimbal Base.SLDPRT
80.0 x 8.00 x 154.0 mm
