james-hepworth/masters/Mechanical Design/SolidWorks Assemblies and Parts/3257G_CR_SW.SLDPRT

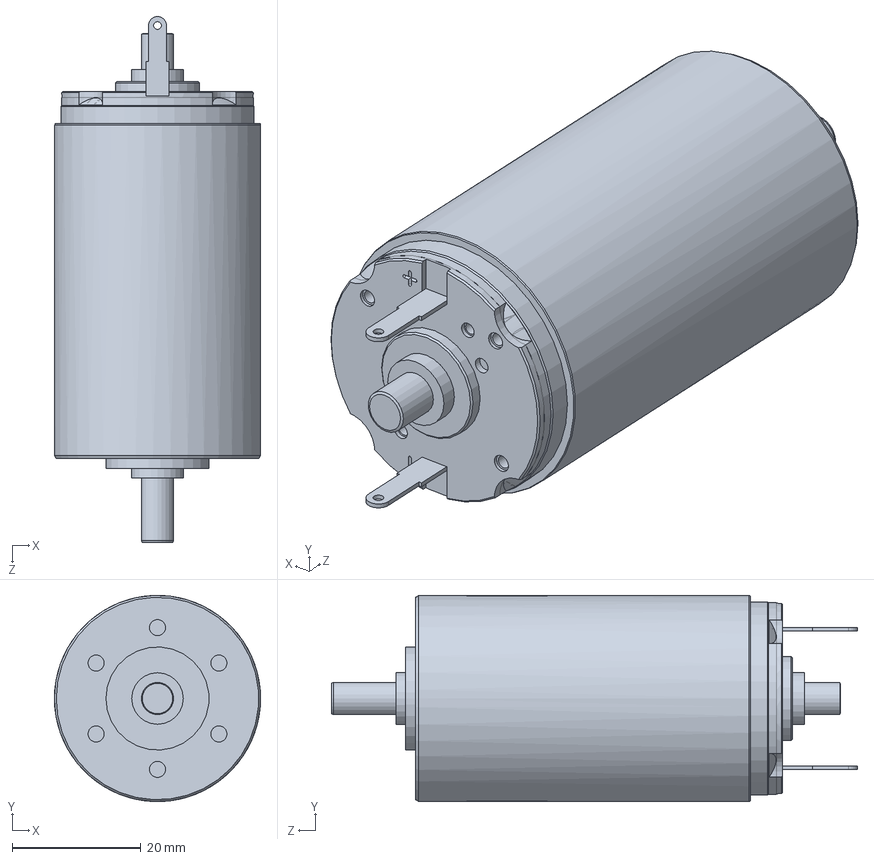
[picture p113: CAD file, 2018-11-27]
Mechanical Design/SolidWorks Assemblies and Parts/3257G_CR_SW.SLDPRT
32.0 x 32.0 x 81.6 mm
