james-hepworth/masters/Mechanical Design/SolidWorks Assemblies and Parts/Tube Clamp.SLDPRT

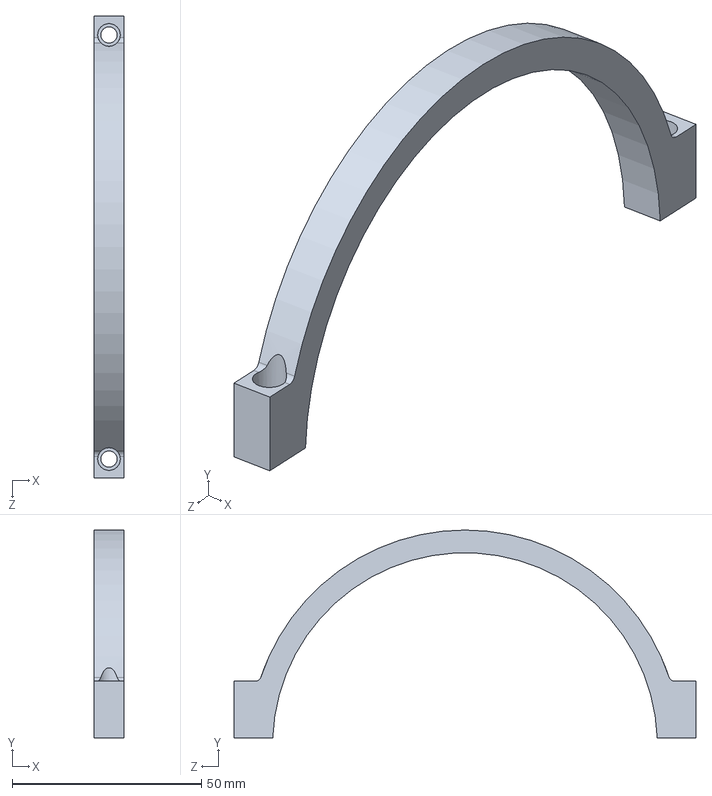
[picture p114: CAD file, 2018-11-27]
Mechanical Design/SolidWorks Assemblies and Parts/Tube Clamp.SLDPRT
8.00 x 54.9 x 122.0 mm
