james-hepworth/masters/Mechanical Design/SolidWorks Assemblies and Parts/Side_Housing.SLDPRT

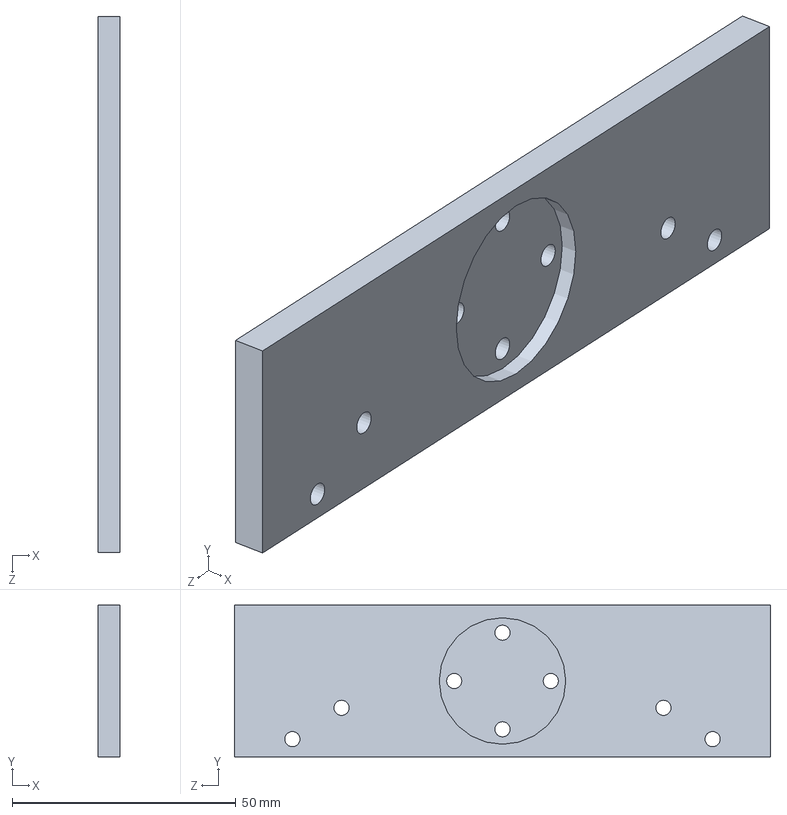
[picture p115: CAD file, 2018-11-27]
Mechanical Design/SolidWorks Assemblies and Parts/Side_Housing.SLDPRT
5.00 x 34.0 x 120.0 mm
