james-hepworth/masters/Mechanical Design/SolidWorks Assemblies and Parts/Lens Glass.SLDPRT

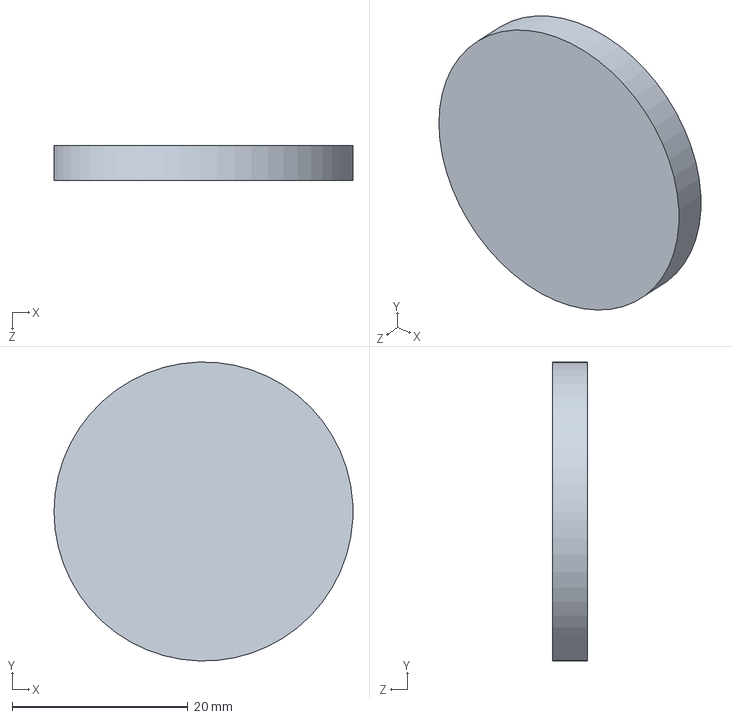
[picture p116: CAD file, 2018-11-27]
Mechanical Design/SolidWorks Assemblies and Parts/Lens Glass.SLDPRT
34.0 x 34.0 x 4.00 mm
