james-hepworth/masters/Mechanical Design/SolidWorks Assemblies and Parts/Cam Mount2.1.SLDPRT

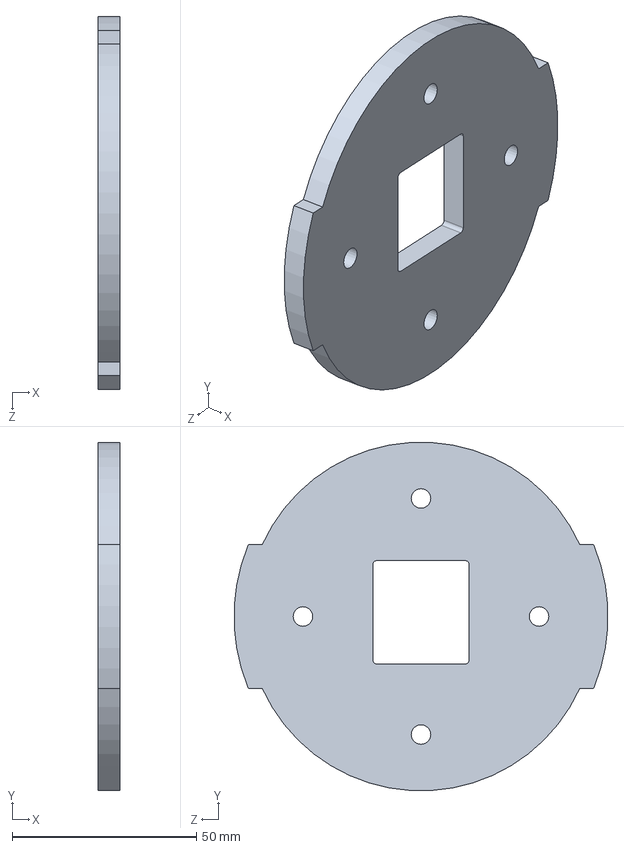
[picture p117: CAD file, 2018-11-27]
Mechanical Design/SolidWorks Assemblies and Parts/Cam Mount2.1.SLDPRT
6.00 x 94.3 x 101.2 mm
