james-hepworth/masters/Mechanical Design/SolidWorks Assemblies and Parts/RasPi_Camera_Board.SLDPRT

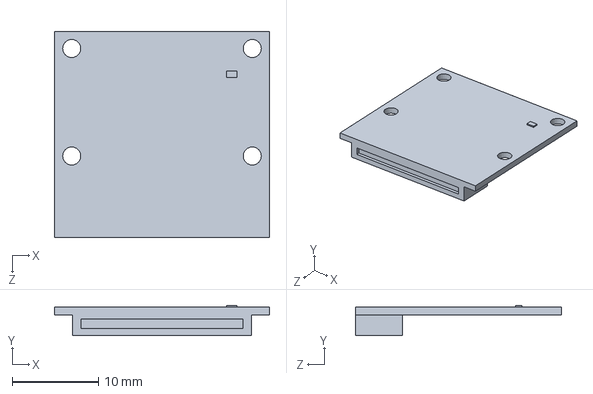
[picture p118: CAD file, 2018-11-27]
Mechanical Design/SolidWorks Assemblies and Parts/RasPi_Camera_Board.SLDPRT
25.0 x 3.50 x 24.0 mm
