james-hepworth/masters/Mechanical Design/SolidWorks Assemblies and Parts/Telescope Clamp2.SLDPRT

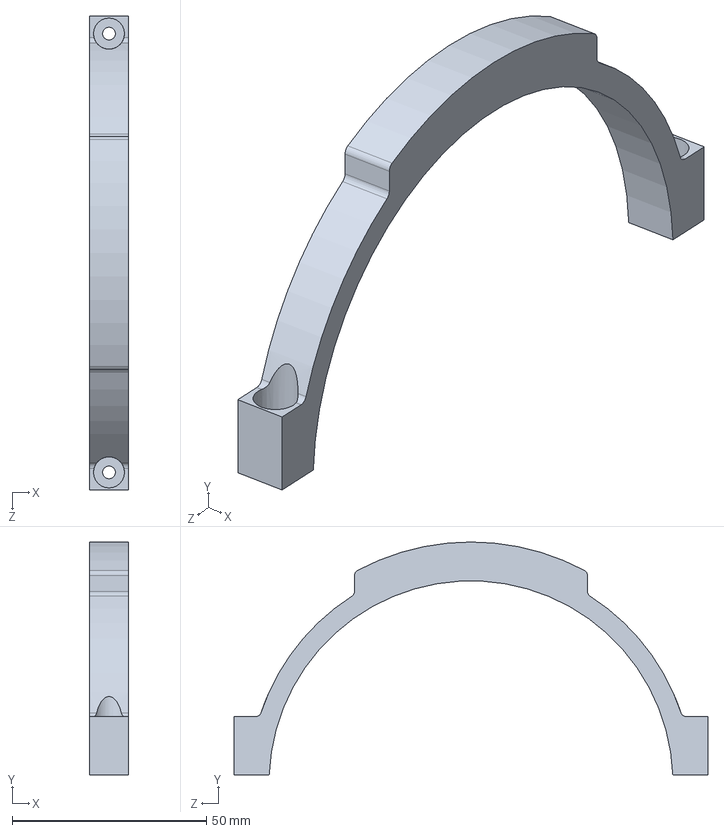
[picture p119: CAD file, 2018-11-27]
Mechanical Design/SolidWorks Assemblies and Parts/Telescope Clamp2.SLDPRT
10.0 x 60.0 x 122.0 mm
