james-hepworth/masters/(list of files, cad)

Other CAD files:
Mechanical Design/SolidWorks Assemblies and Parts/Gimbal Support A.SLDPRT
Mechanical Design/SolidWorks Assemblies and Parts/Telescope Mass2.SLDPRT
Mechanical Design/SolidWorks Assemblies and Parts/127 TN9_PART3.sldprt
Mechanical Design/SolidWorks Assemblies and Parts/Vertical Suport2.SLDPRT
Mechanical Design/SolidWorks Assemblies and Parts/Upright2.SLDPRT
Mechanical Design/SolidWorks Assemblies and Parts/Cam Mount3 H.SLDPRT
Mechanical Design/SolidWorks Assemblies and Parts/Cam Mount2.SLDPRT
Mechanical Design/SolidWorks Assemblies and Parts/Mass Block CNC R.SLDPRT
Mechanical Design/SolidWorks Assemblies and Parts/61901-2Z.sldasm
Mechanical Design/SolidWorks Assemblies and Parts/61901-2Z_PART1.sldprt
Mechanical Design/SolidWorks Assemblies and Parts/61901-2Z_PART2.sldprt
Mechanical Design/SolidWorks Assemblies and Parts/61901-2Z_PART3.sldprt
Mechanical Design/SolidWorks Assemblies and Parts/OVA5647.SLDPRT
Mechanical Design/SolidWorks Assemblies and Parts/countersunk flat head cross recess screw_iso.sldprt
Mechanical Design/SolidWorks Assemblies and Parts/hex nut style 1 gradeab_iso.sldprt
Mechanical Design/SolidWorks Assemblies and Parts/pan head cross recess screw_iso.sldprt
Mechanical Design/SolidWorks Assemblies and Parts/slotted pan head screw_iso.sldprt
Mechanical Design/SolidWorks Assemblies and Parts/socket button head screw_iso.sldprt
Mechanical Design/SolidWorks Assemblies and Parts/socket head cap screw_iso.sldprt
Mechanical Design/SolidWorks Drawings/3257 Mount.SLDDRW
Mechanical Design/SolidWorks Drawings/Bearing Mount.SLDDRW
Mechanical Design/SolidWorks Drawings/Body Mount.SLDDRW
Mechanical Design/SolidWorks Drawings/CS-Mount Adapter.SLDDRW
Mechanical Design/SolidWorks Drawings/Cam Holder.SLDDRW
Mechanical Design/SolidWorks Drawings/Cam Mount1.SLDDRW
Mechanical Design/SolidWorks Drawings/Cam Mount2.1.SLDDRW
Mechanical Design/SolidWorks Drawings/Cam Mount2.SLDDRW
Mechanical Design/SolidWorks Drawings/Cam Mount3 H.SLDDRW
Mechanical Design/SolidWorks Drawings/Cam Mount3.SLDDRW
Mechanical Design/SolidWorks Drawings/Cam Tube.SLDDRW
Mechanical Design/SolidWorks Drawings/Gimbal Base.SLDDRW
Mechanical Design/SolidWorks Drawings/Gimbal Support A.SLDDRW
Mechanical Design/SolidWorks Drawings/Gimbal Support B.SLDDRW
Mechanical Design/SolidWorks Drawings/IMU mount.SLDDRW
Mechanical Design/SolidWorks Drawings/M5 Insert.SLDDRW
Mechanical Design/SolidWorks Drawings/Mass Block CNC L.SLDDRW
Mechanical Design/SolidWorks Drawings/Mass Block CNC R.SLDDRW
Mechanical Design/SolidWorks Drawings/Mass Block2.SLDDRW
Mechanical Design/SolidWorks Drawings/Part1.SLDDRW
Mechanical Design/SolidWorks Drawings/Pitch Platform Isometric.SLDDRW
Mechanical Design/SolidWorks Drawings/Pitch Platform Orthographic.SLDDRW
Mechanical Design/SolidWorks Drawings/Pitch Platform.SLDDRW
Mechanical Design/SolidWorks Drawings/Pot Coupling1.SLDDRW
Mechanical Design/SolidWorks Drawings/Pot Coupling2.SLDDRW
Mechanical Design/SolidWorks Drawings/Pot Mount.SLDDRW
Mechanical Design/SolidWorks Drawings/Pot X-Mount.SLDDRW
Mechanical Design/SolidWorks Drawings/Retaining Disk 1.SLDDRW
Mechanical Design/SolidWorks Drawings/Shaft Coupling.SLDDRW
Mechanical Design/SolidWorks Drawings/Side1.SLDDRW
Mechanical Design/SolidWorks Drawings/Side1_Turned.SLDDRW
Mechanical Design/SolidWorks Drawings/Side2.SLDDRW
Mechanical Design/SolidWorks Drawings/Side2_Turned.SLDDRW
Mechanical Design/SolidWorks Drawings/Side_Housing.SLDDRW
Mechanical Design/SolidWorks Drawings/Stand2.SLDDRW
Mechanical Design/SolidWorks Drawings/System Assembly.SLDDRW
Mechanical Design/SolidWorks Drawings/System Base.SLDDRW
Mechanical Design/SolidWorks Drawings/Telescop Modeller Tray.SLDDRW
Mechanical Design/SolidWorks Drawings/Telescope Mass.SLDDRW
Mechanical Design/SolidWorks Drawings/Tube Clamp Bottom.SLDDRW
Mechanical Design/SolidWorks Drawings/Tube Clamp.SLDDRW
Mechanical Design/SolidWorks Drawings/Tube Mass Bottom.SLDDRW
Mechanical Design/SolidWorks Drawings/Tube Mass.SLDDRW
Mechanical Design/SolidWorks Drawings/Upright1.SLDDRW
Mechanical Design/SolidWorks Drawings/Upright2.SLDDRW
Mechanical Design/SolidWorks Drawings/Yaw Gimbal Isometric.SLDDRW
Mechanical Design/SolidWorks Drawings/Yaw Gimbal.SLDDRW
Mechanical Design/SolidWorks Drawings/Yaw Inner Race.SLDDRW
Mechanical Design/SolidWorks Drawings/Yaw Outer Race.SLDDRW
