james-hepworth/masters/Simulation/YT_Simulation Test Result.bmp

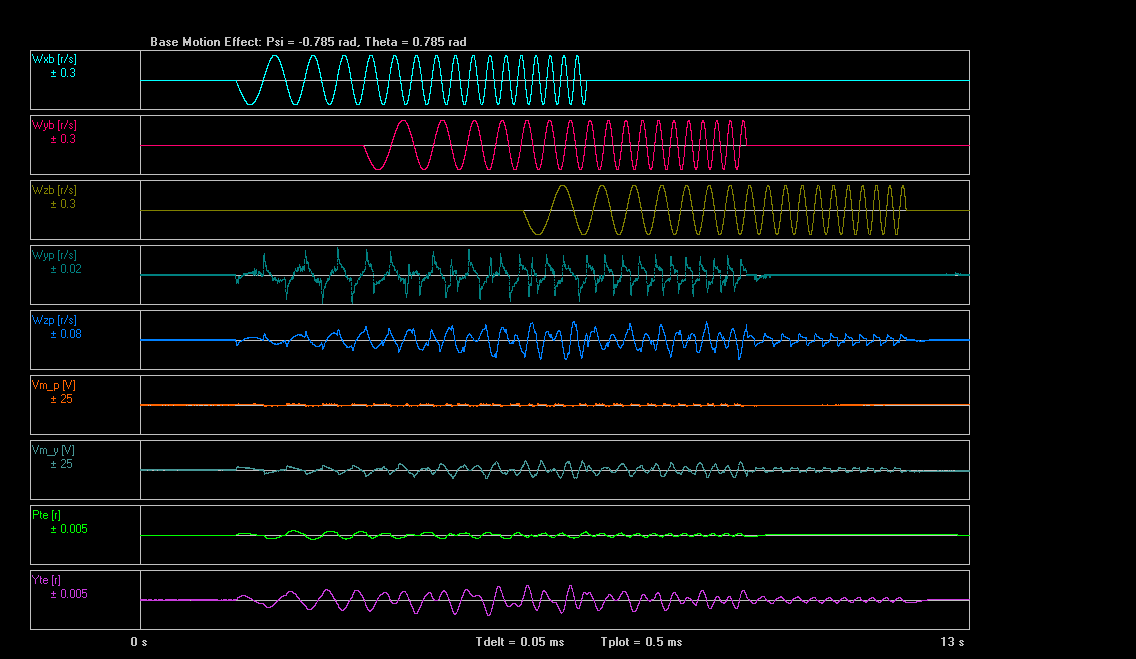
Simulation/YT_Simulation Test Result.bmp
