james-hepworth/masters/Mechanical Design/PDF Drawings/3257 Mount.pdf

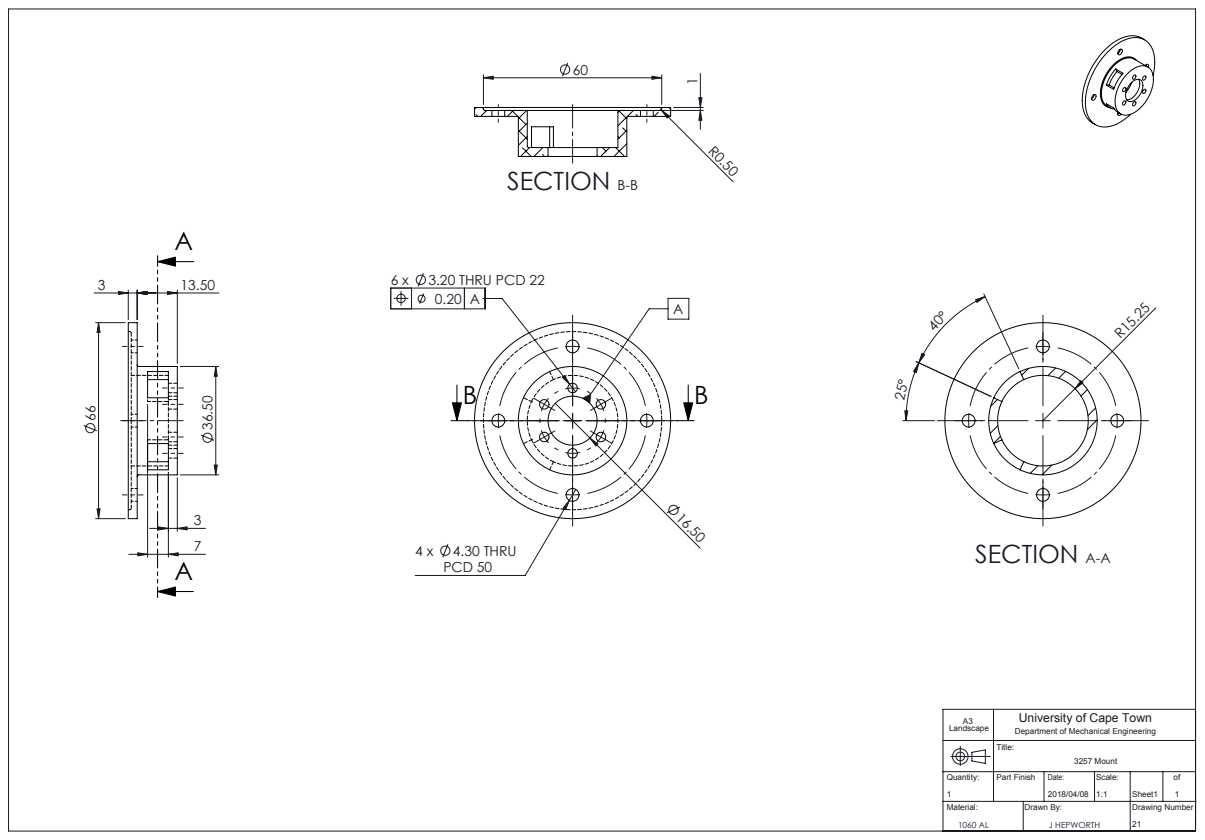
[picture p121: page 1]
6 x 3.20 THRU PCD 22; 4 x 4.30 THRU PCD 50; SECTION A-A; SECTION B-B; J HEPWORTH; 3257 Mount; Sheet1; Part Finish; Scale:; Drawn By:; Drawing Number

University of Cape Town
Department of Mechanical Engineering
Title:
