james-hepworth/masters/Mechanical Design/PDF Drawings/Bearing Mount.pdf

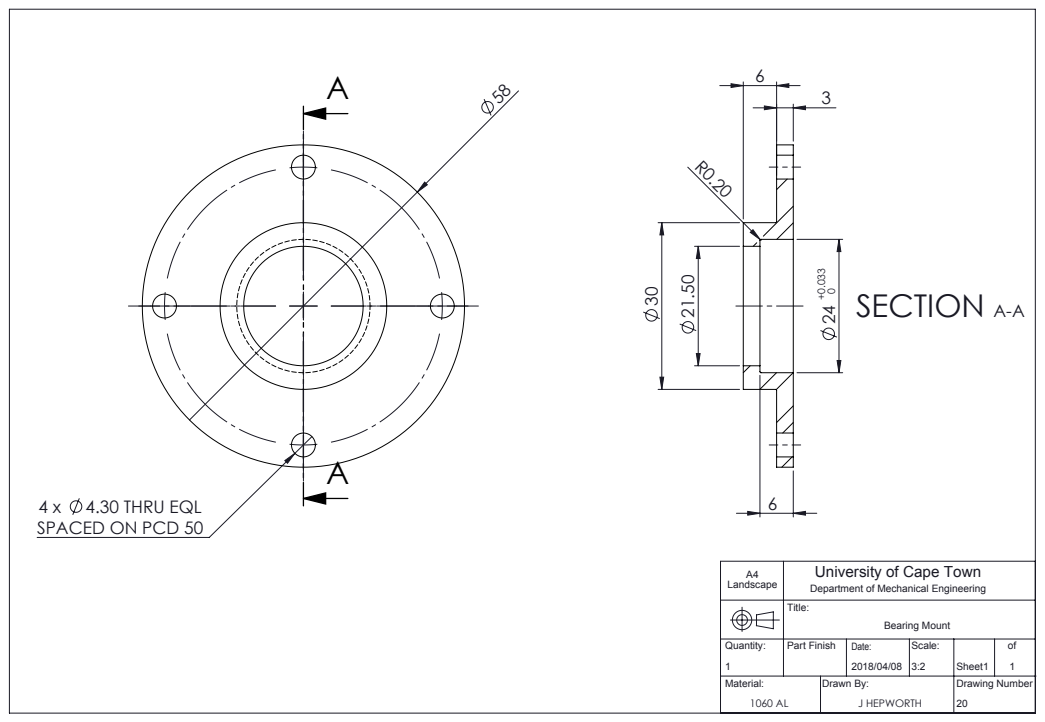
[picture p122: page 1]
SECTION A-A; J HEPWORTH; Drawing Number; Drawn By:; Part Finish; Scale:; Sheet1; Bearing Mount

4 x 4.30 THRU EQL
SPACED ON PCD 50

University of Cape Town
Department of Mechanical Engineering
Title:
