james-hepworth/masters/Mechanical Design/PDF Drawings/Body Mount.pdf

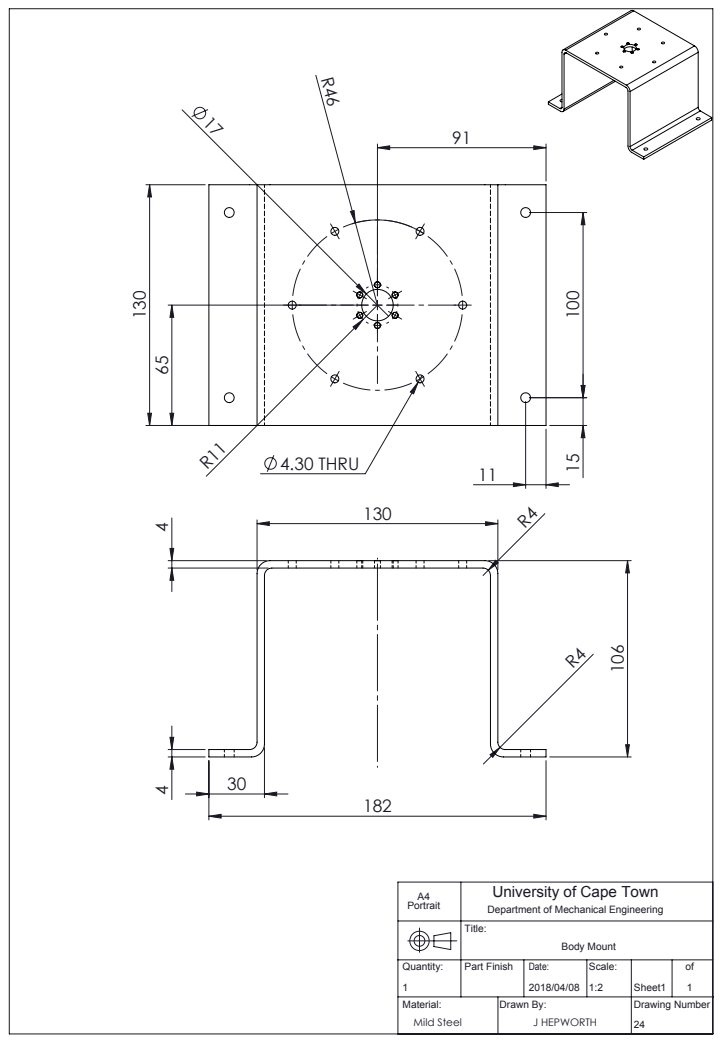
[picture p123: page 1]
4.30 THRU; Mild Steel; J HEPWORTH; Drawing Number; Drawn By:; Part Finish; Scale:; Sheet1; Body Mount

University of Cape Town
Department of Mechanical Engineering
Title:
