james-hepworth/masters/Mechanical Design/PDF Drawings/Cam Mount1.pdf

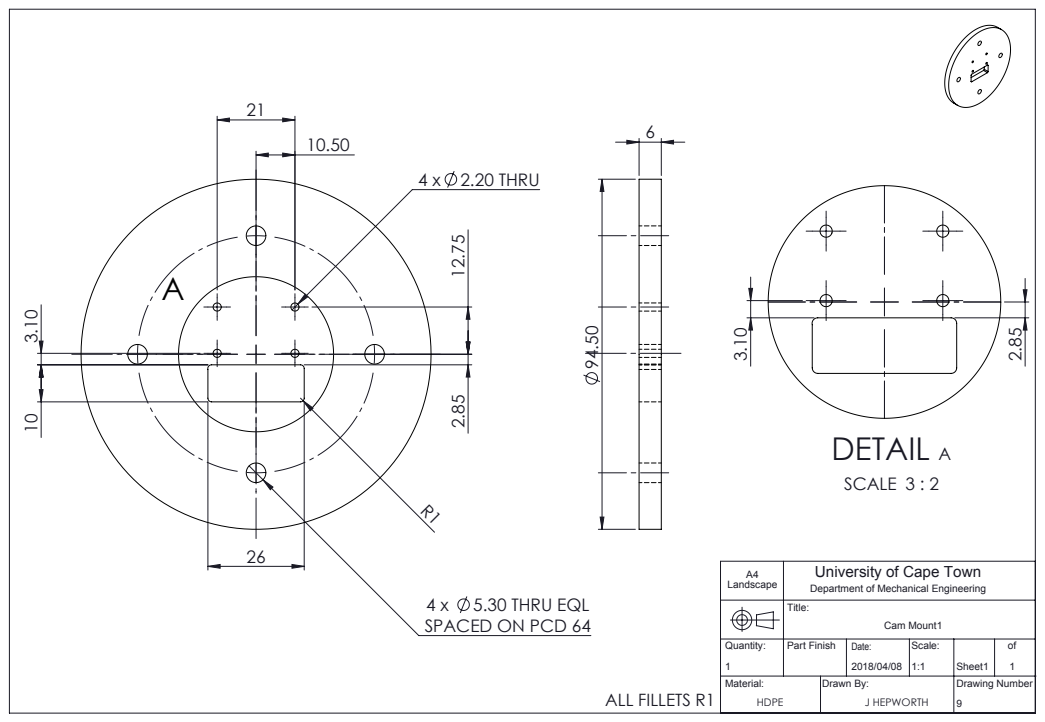
[picture p124: page 1]
4 x 5.30 THRU EQL; 4 x 2.20 THRU; DETAIL A; SCALE 3 : 2; ALL FILLETS R1; HDPE; J HEPWORTH; Drawing Number; Drawn By:; Part Finish; Scale:; Sheet1; Cam Mount1

SPACED ON PCD 64 2.85

University of Cape Town
Department of Mechanical Engineering
Title:
