james-hepworth/masters/Mechanical Design/PDF Drawings/Cam Mount2.1.pdf

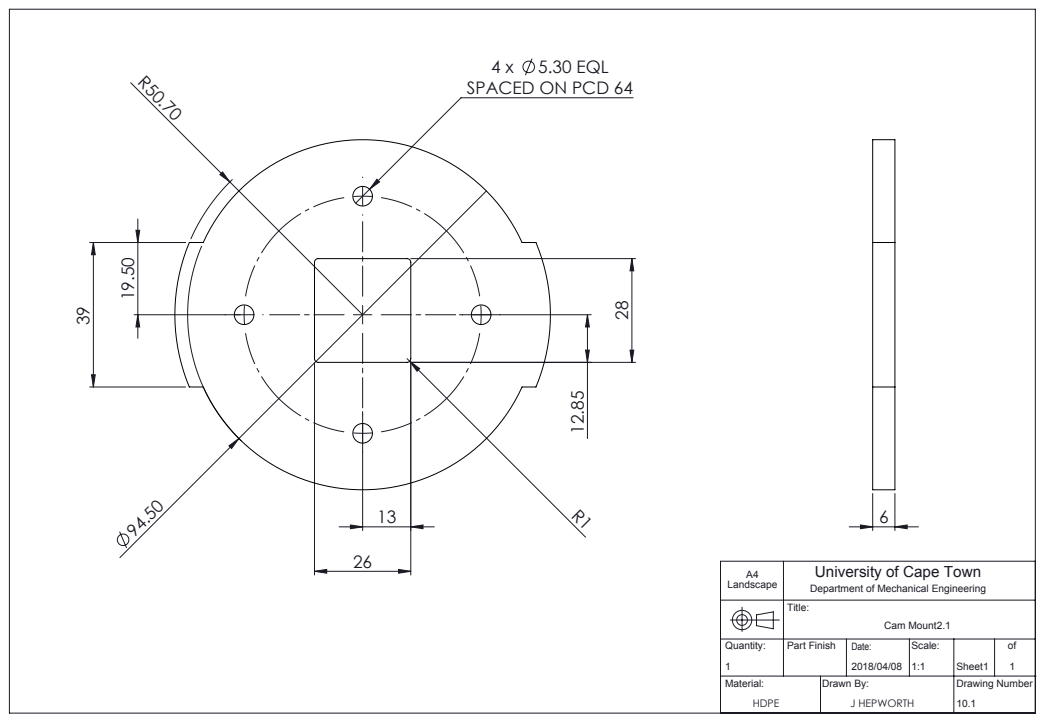
[picture p125: page 1]
HDPE; J HEPWORTH; Drawing Number; Drawn By:; Part Finish; Scale:; Sheet1; Cam Mount2.1

4 x 5.30 EQL
SPACED ON PCD 64

University of Cape Town
Department of Mechanical Engineering
Title:
