james-hepworth/masters/Mechanical Design/PDF Drawings/Cam Mount2.pdf

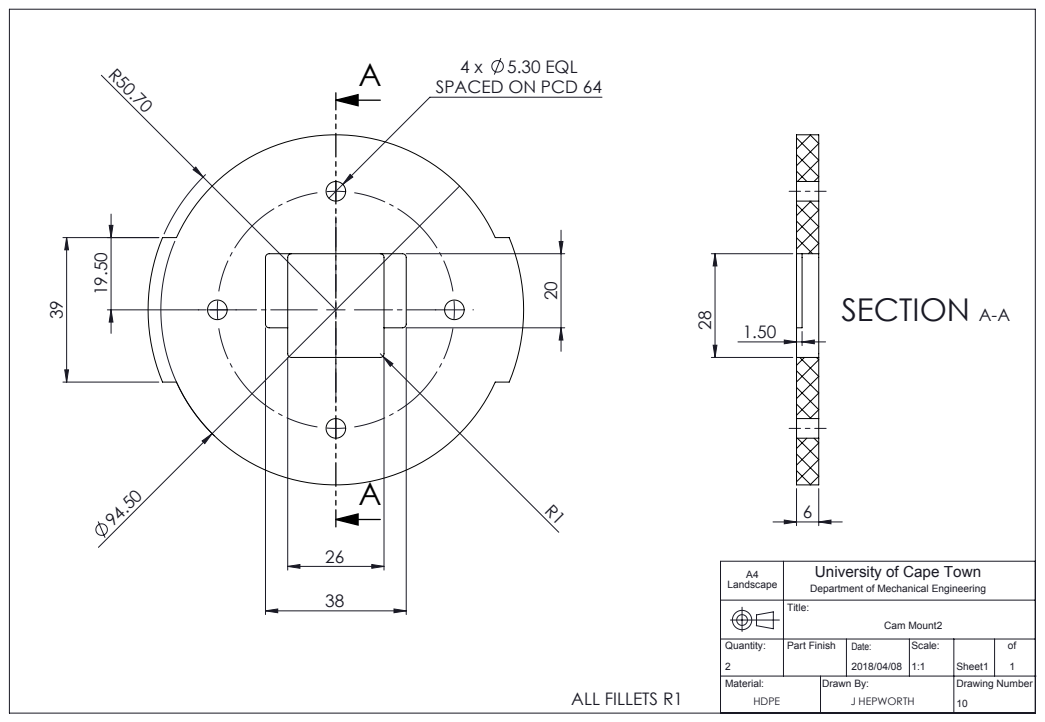
[picture p126: page 1]
4 x 5.30 EQL A; SPACED ON PCD 64; SECTION A-A; ALL FILLETS R1; HDPE; J HEPWORTH; Drawing Number; Drawn By:; Part Finish; Scale:; Sheet1; Cam Mount2

University of Cape Town
Department of Mechanical Engineering
Title:
