james-hepworth/masters/Mechanical Design/PDF Drawings/Cam Mount3 H.pdf

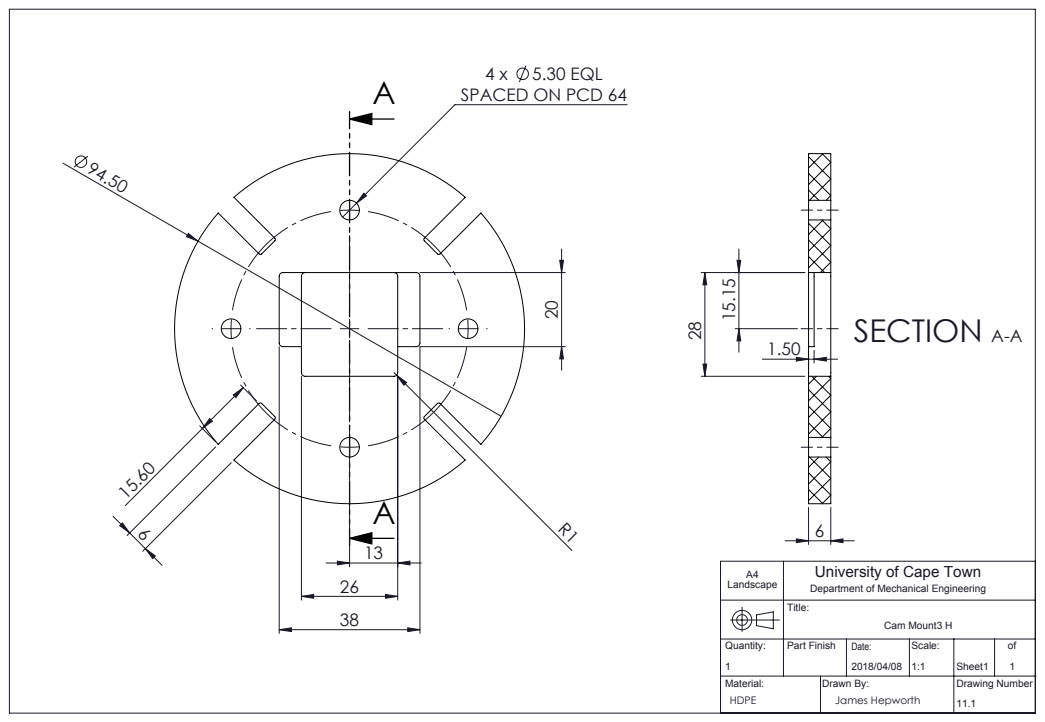
[picture p127: page 1]
4 x 5.30 EQL; SECTION A-A; HDPE; James Hepworth; Drawing Number; Drawn By:; Part Finish; Scale:; Sheet1; Cam Mount3 H

SPACED ON PCD 64

University of Cape Town
Department of Mechanical Engineering
Title:
