james-hepworth/masters/Mechanical Design/PDF Drawings/Cam Mount3.pdf

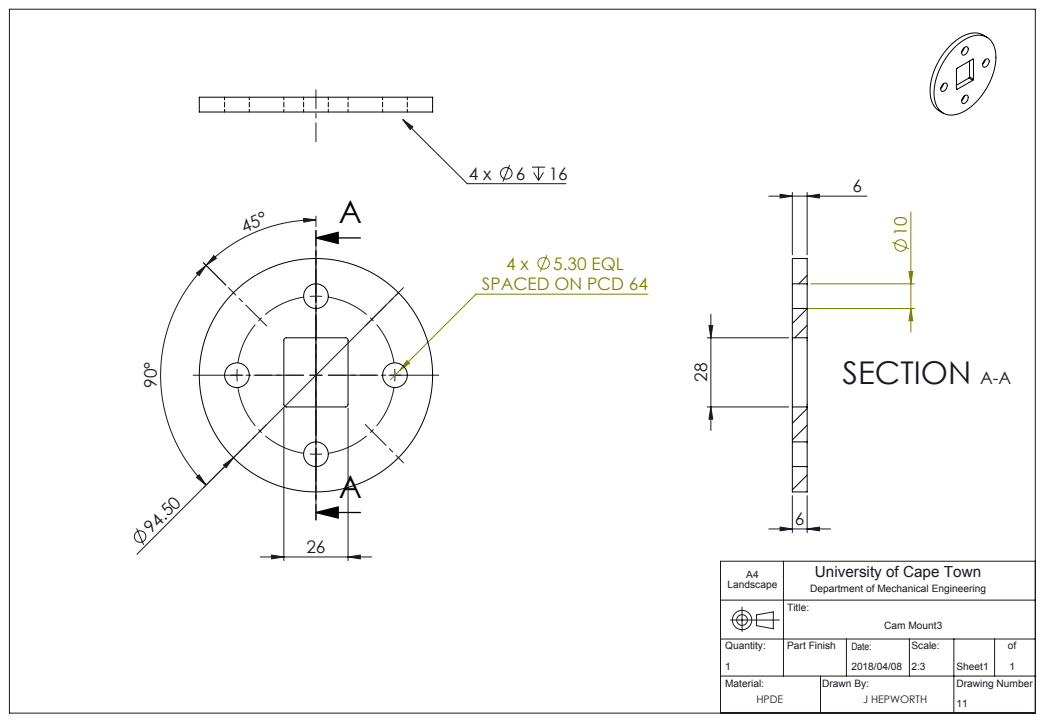
[picture p128: page 1]
SECTION A-A; HPDE; J HEPWORTH; Drawing Number; Drawn By:; Part Finish; Scale:; Sheet1; Cam Mount3

4 x 5.30 EQL
SPACED ON PCD 64

University of Cape Town
Department of Mechanical Engineering
Title:
