james-hepworth/masters/Mechanical Design/PDF Drawings/Cam Tube.pdf

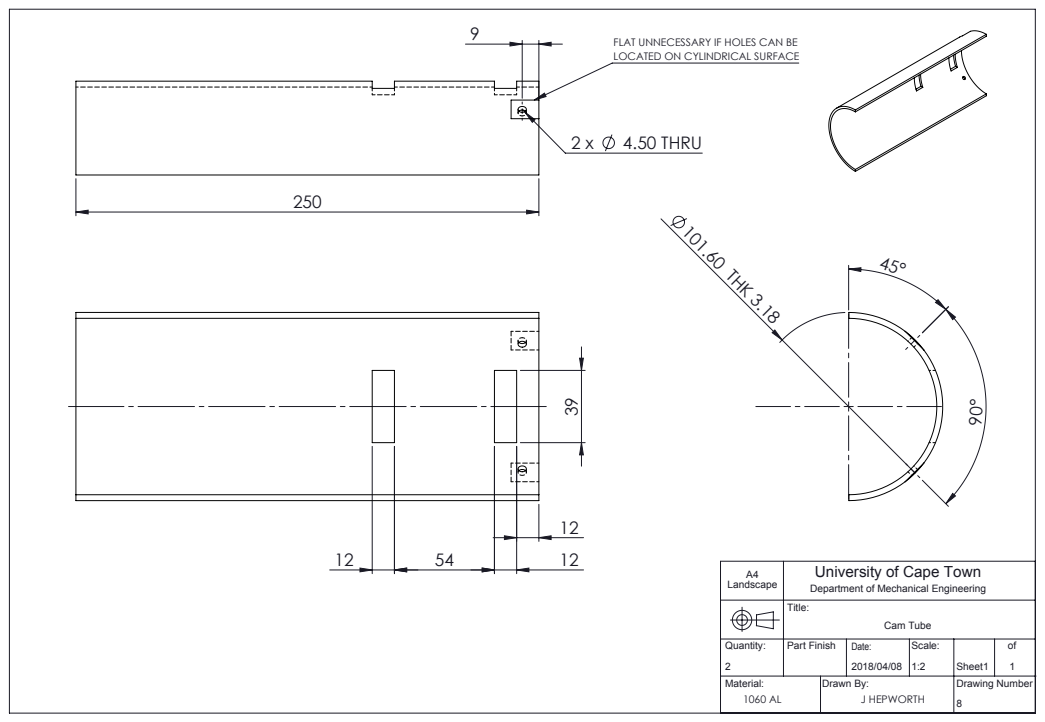
[picture p129: page 1]
4.50 THRU; 101.60 THK 3.18; J HEPWORTH; Drawing Number; Drawn By:; Part Finish; Scale:; Sheet1; Cam Tube

FLAT UNNECESSARY IF HOLES CAN BE
LOCATED ON CYLINDRICAL SURFACE

University of Cape Town
Department of Mechanical Engineering
Title:
