james-hepworth/masters/Mechanical Design/PDF Drawings/CS-Mount Adapter.pdf

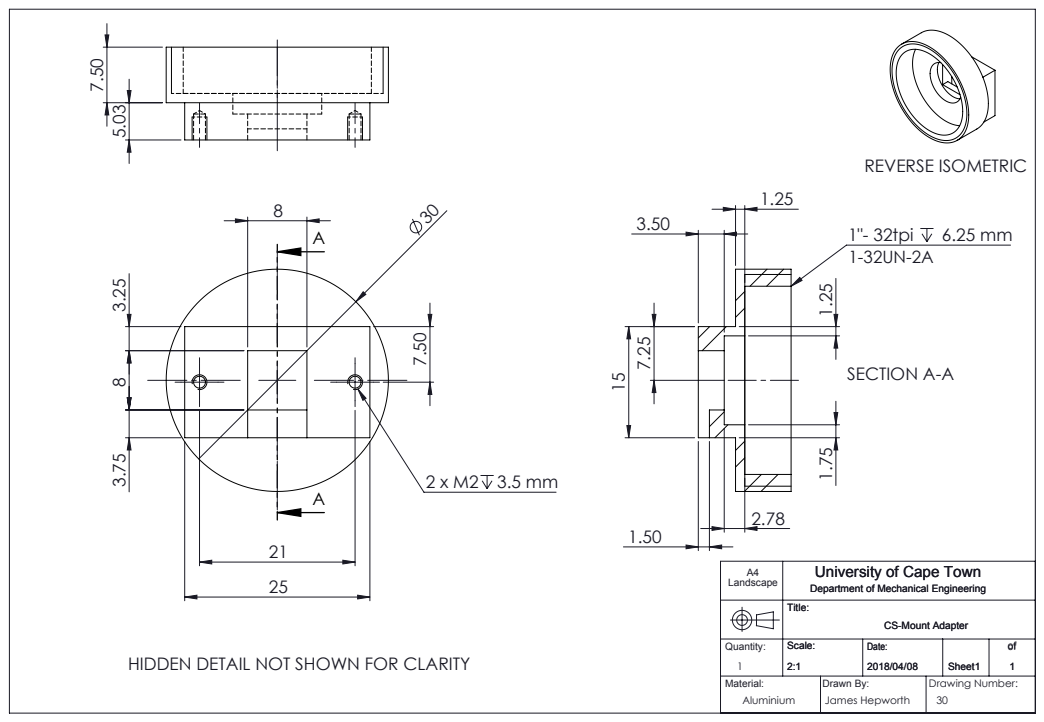
[picture p130: page 1]
REVERSE ISOMETRIC; SECTION A-A; 1"- 32tpi 6.25 mm; Aluminium; James Hepworth; Material:; Drawn By:; Drawing Number:

University of Cape Town
Department of Mechanical Engineering
Title:

CS-Mount Adapter

HIDDEN DETAIL NOT SHOWN FOR CLARITY
