james-hepworth/masters/Mechanical Design/PDF Drawings/IMU mount.pdf

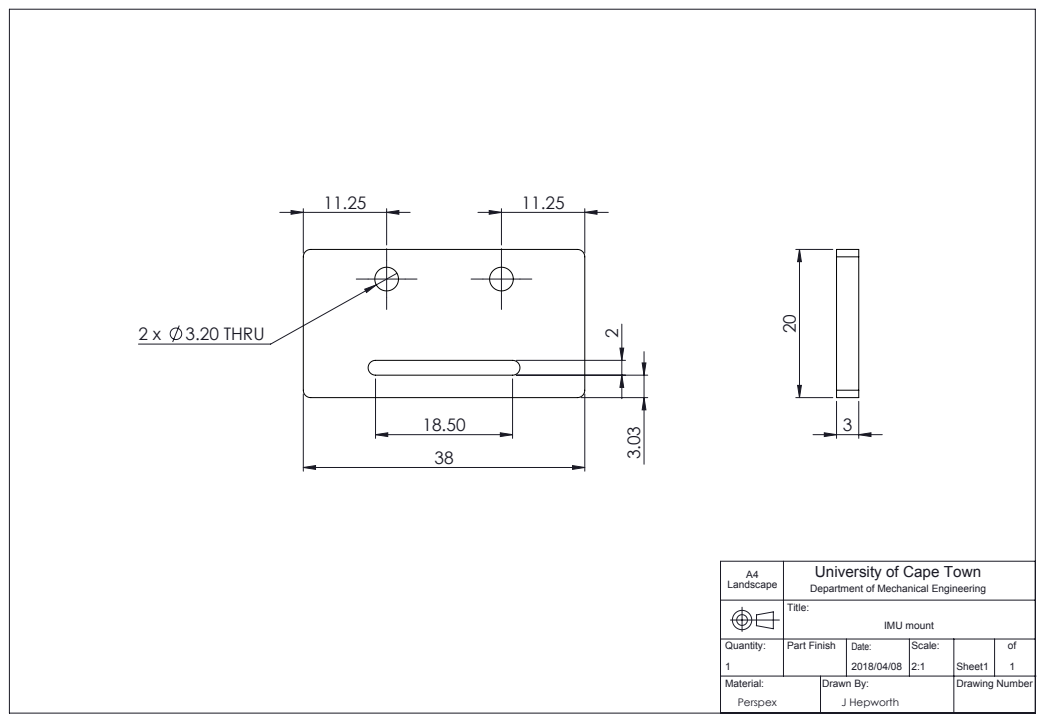
[picture p131: page 1]
2 x 3.20 THRU; Perspex; J Hepworth; Drawing Number; Drawn By:; Part Finish; Scale:; Sheet1; IMU mount

University of Cape Town
Department of Mechanical Engineering
Title:
