james-hepworth/masters/Mechanical Design/PDF Drawings/M5 Insert.pdf

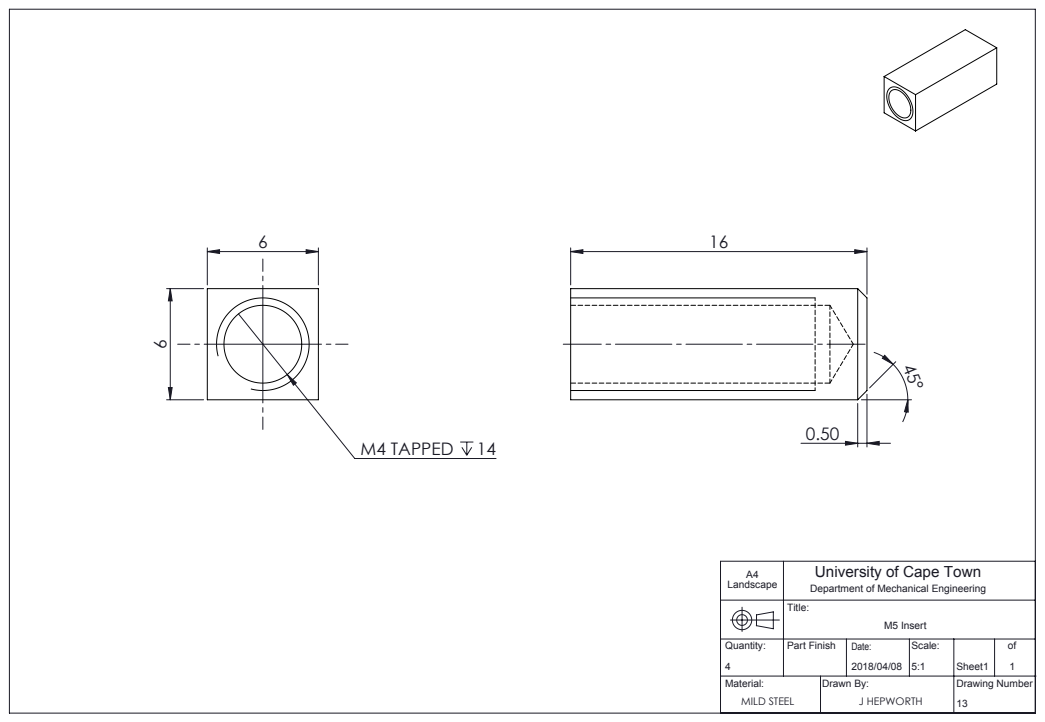
[picture p132: page 1]
M4 TAPPED 14; MILD STEEL; J HEPWORTH; Drawing Number; Drawn By:; Part Finish; Scale:; Sheet1; M5 Insert

University of Cape Town
Department of Mechanical Engineering
Title:
