james-hepworth/masters/Mechanical Design/PDF Drawings/Pot Coupling1.pdf

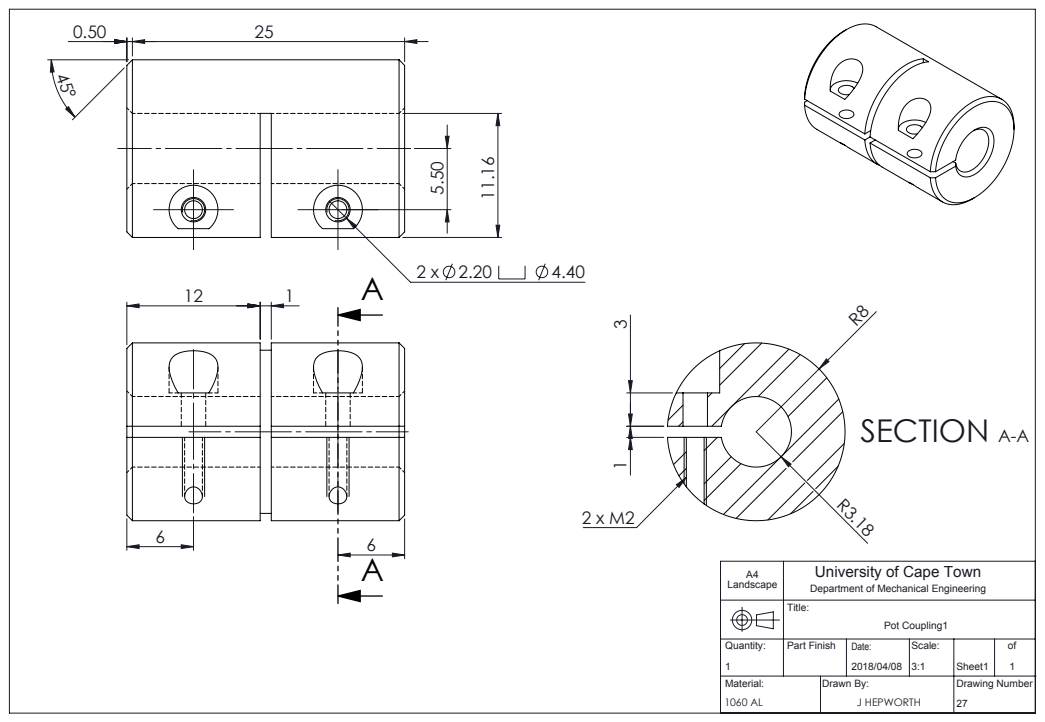
[picture p133: page 1]
SECTION A-A; J HEPWORTH; Drawing Number; Drawn By:; Part Finish; Scale:; Sheet1; Pot Coupling1

University of Cape Town
Department of Mechanical Engineering
Title:
