james-hepworth/masters/Mechanical Design/PDF Drawings/Pot Coupling2.pdf

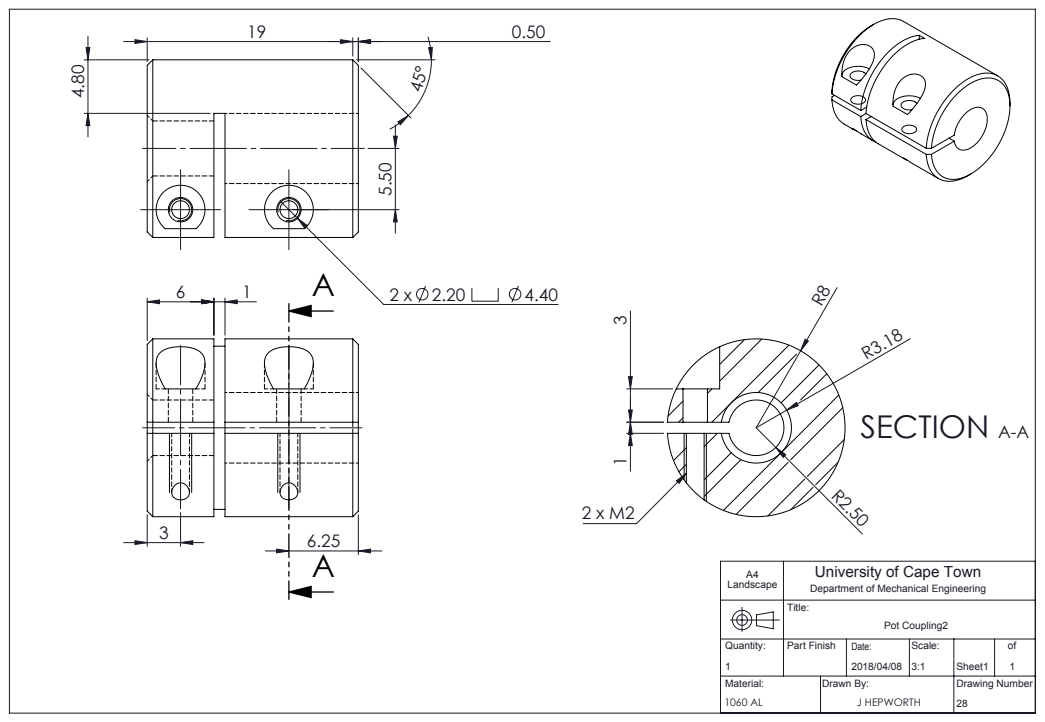
[picture p134: page 1]
SECTION A-A; J HEPWORTH; Drawing Number; Drawn By:; Part Finish; Scale:; Sheet1; Pot Coupling2

University of Cape Town
Department of Mechanical Engineering
Title:
