james-hepworth/masters/Mechanical Design/PDF Drawings/Pot Mount.pdf

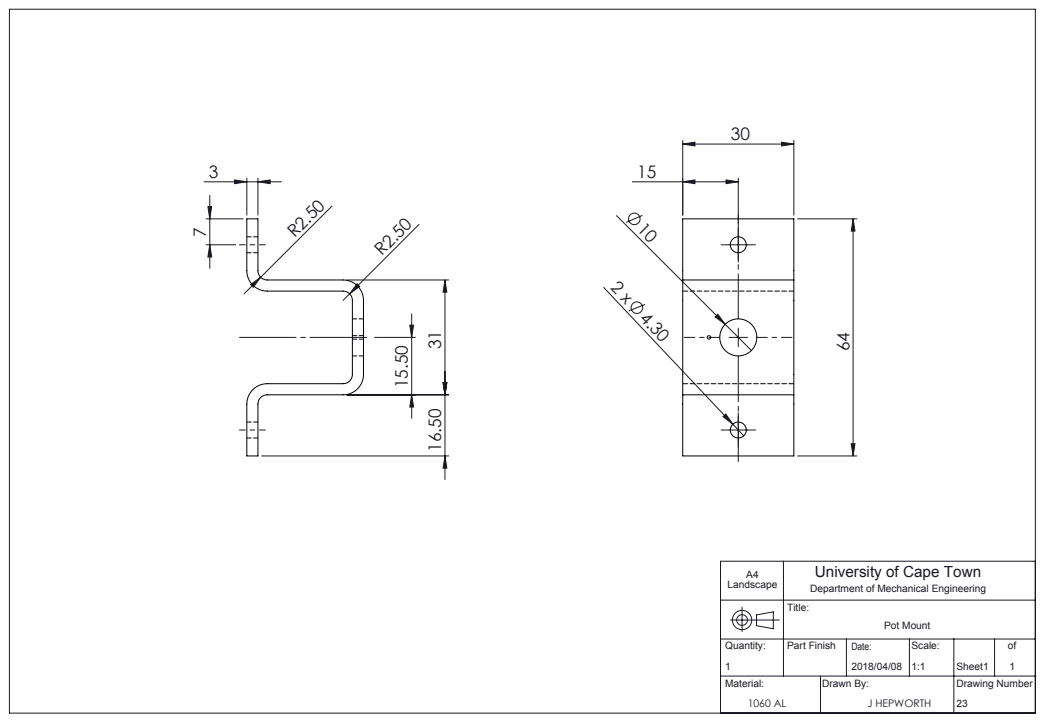
[picture p135: page 1]
J HEPWORTH; Drawing Number; Drawn By:; Part Finish; Scale:; Sheet1; Pot Mount

University of Cape Town
Department of Mechanical Engineering
Title:
