james-hepworth/masters/Mechanical Design/PDF Drawings/Retaining Disk 1.pdf

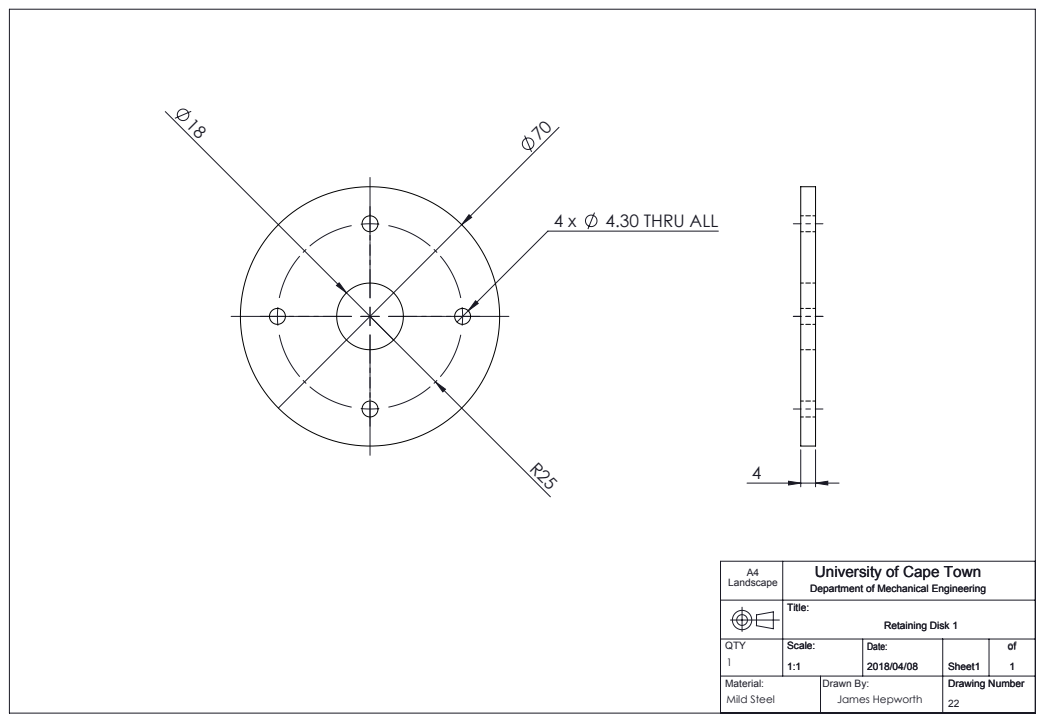
[picture p136: page 1]
4.30 THRU ALL; Mild Steel; James Hepworth; Drawing Number; Retaining Disk 1; Material:; Drawn By:

University of Cape Town
Department of Mechanical Engineering
Title:
