james-hepworth/masters/Mechanical Design/PDF Drawings/Shaft Coupling.pdf

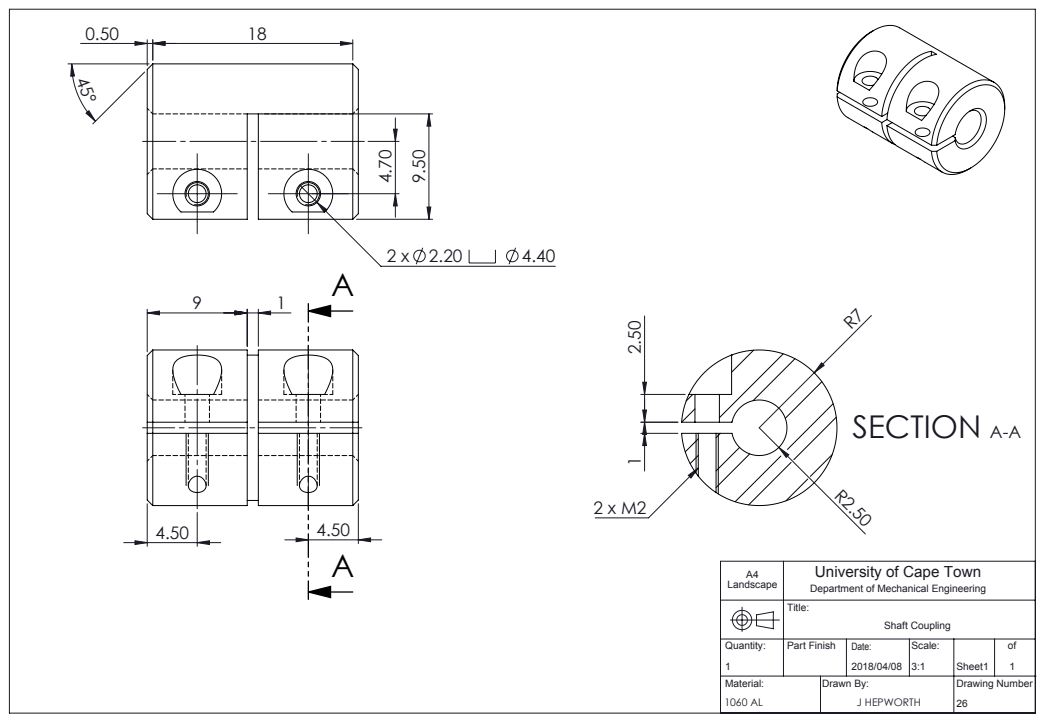
[picture p137: page 1]
SECTION A-A; J HEPWORTH; Drawing Number; Drawn By:; Part Finish; Scale:; Sheet1; Shaft Coupling

University of Cape Town
Department of Mechanical Engineering
Title:
