james-hepworth/masters/Mechanical Design/PDF Drawings/Side1.pdf

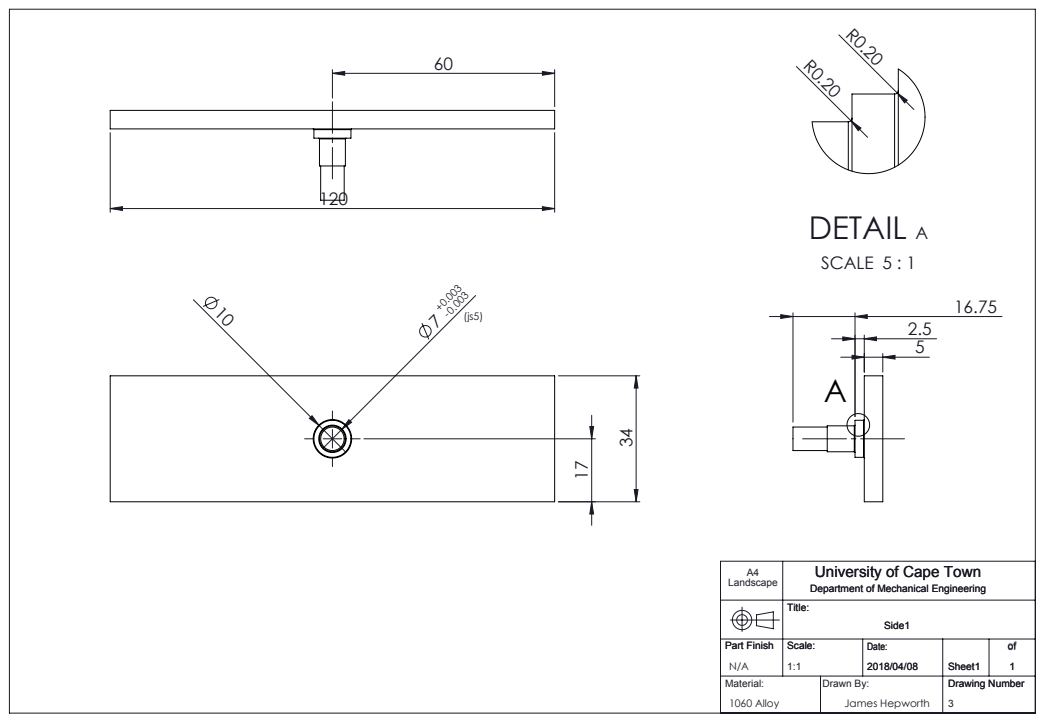
[picture p138: page 1]
DETAIL A; SCALE 5 : 1; 1060 Alloy; James Hepworth; Drawing Number; Material:; Drawn By:

University of Cape Town
Department of Mechanical Engineering
Title:

Part Finish Scale:
