james-hepworth/masters/Mechanical Design/PDF Drawings/Side2.pdf

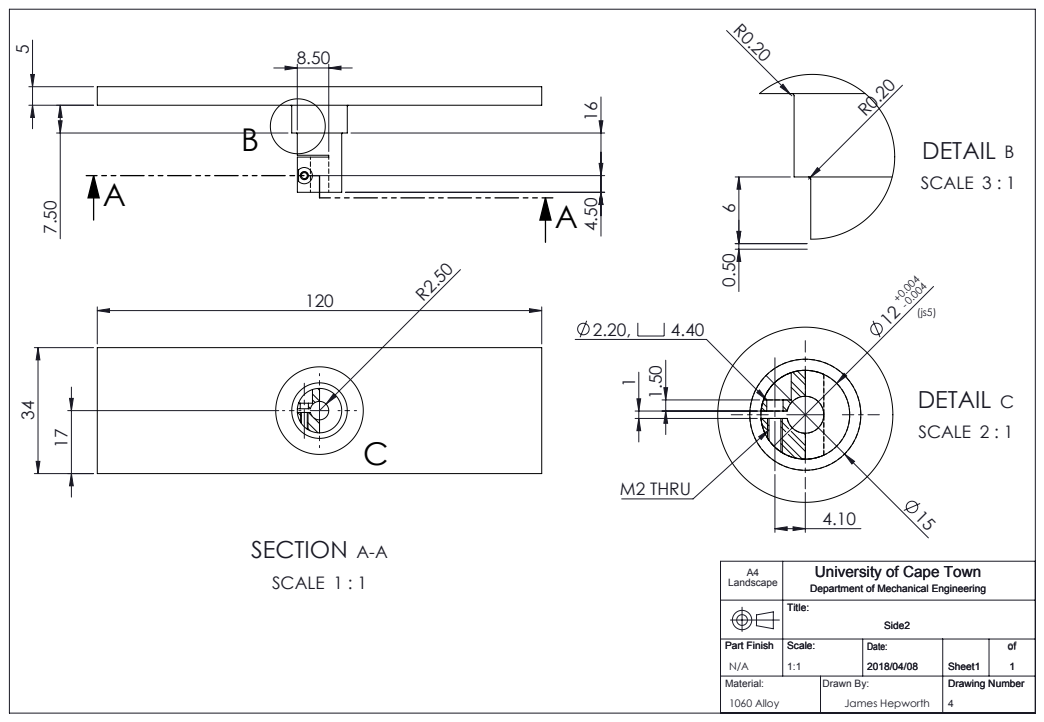
[picture p139: page 1]
SECTION A-A; SCALE 1 : 1; SCALE 3 : 1; SCALE 2 : 1; M2 THRU; 1060 Alloy; James Hepworth; Drawing Number; Material:; Drawn By:

University of Cape Town
Department of Mechanical Engineering
Title:

Part Finish Scale:
