james-hepworth/masters/Mechanical Design/PDF Drawings/Side_Housing.pdf

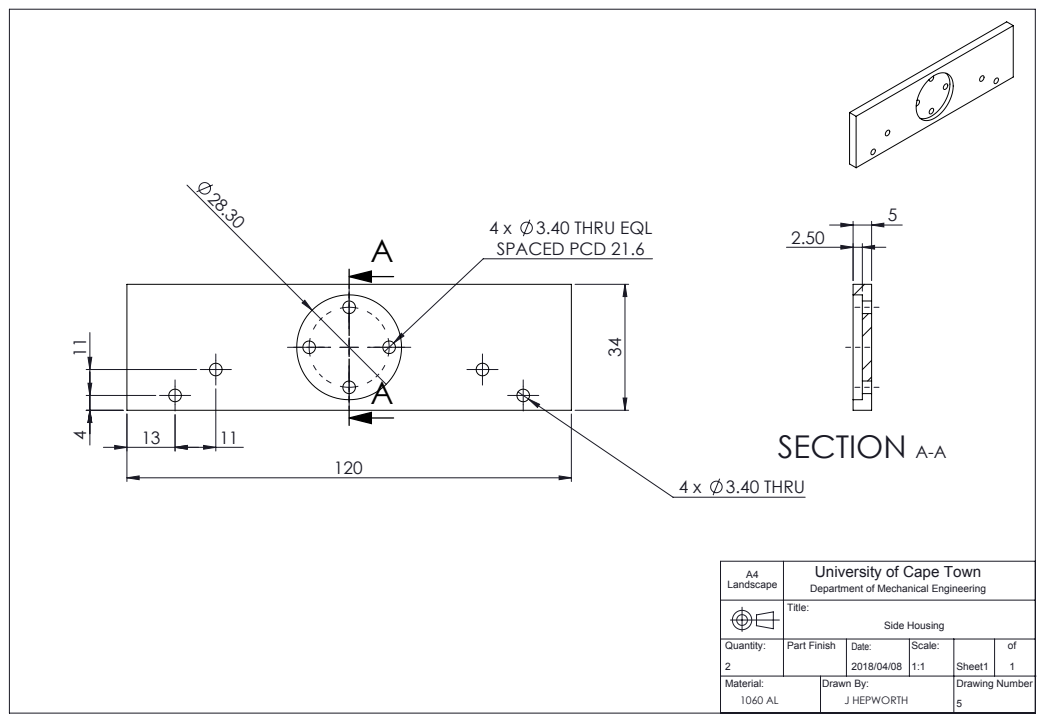
[picture p140: page 1]
4 x 3.40 THRU EQL SPACED PCD 21.6; 4 x 3.40 THRU; SECTION A-A; J HEPWORTH; Drawing Number; Drawn By:; Part Finish; Scale:; Sheet1; Side Housing

University of Cape Town
Department of Mechanical Engineering
Title:
