james-hepworth/masters/Mechanical Design/PDF Drawings/Telescope Mass.pdf

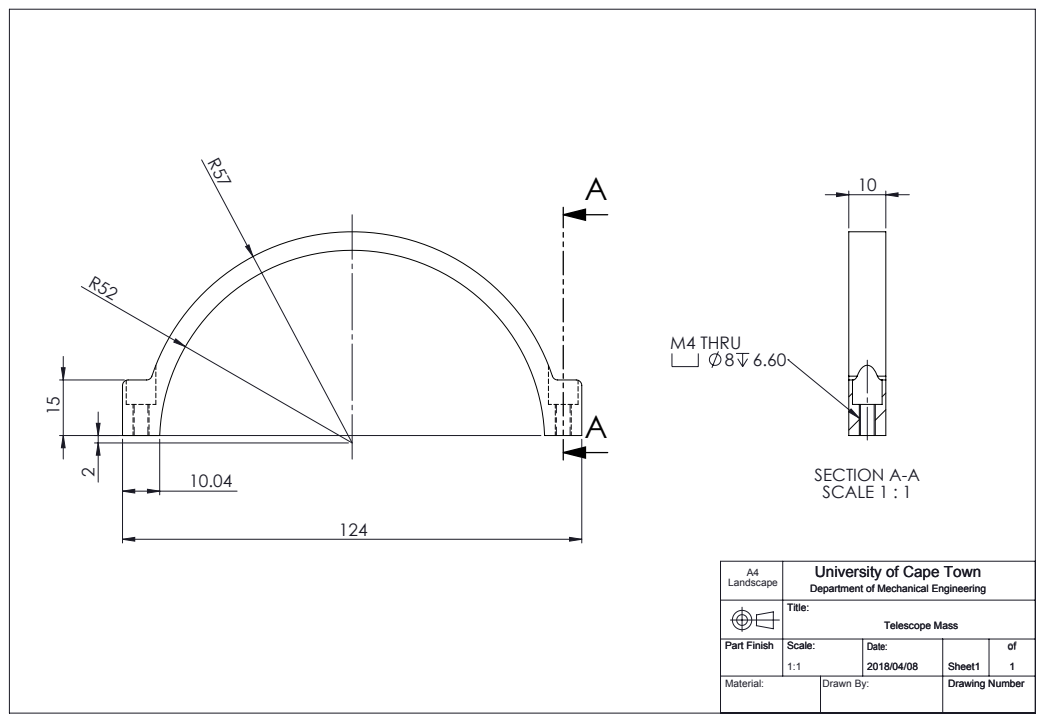
[picture p141: page 1]
SECTION A-A SCALE 1 : 1; M4 THRU 8 6.60; Drawing Number; Telescope Mass; Material:; Drawn By:

University of Cape Town
Department of Mechanical Engineering
Title:

Part Finish Scale:
