james-hepworth/masters/Mechanical Design/PDF Drawings/Tube Clamp Bottom.pdf

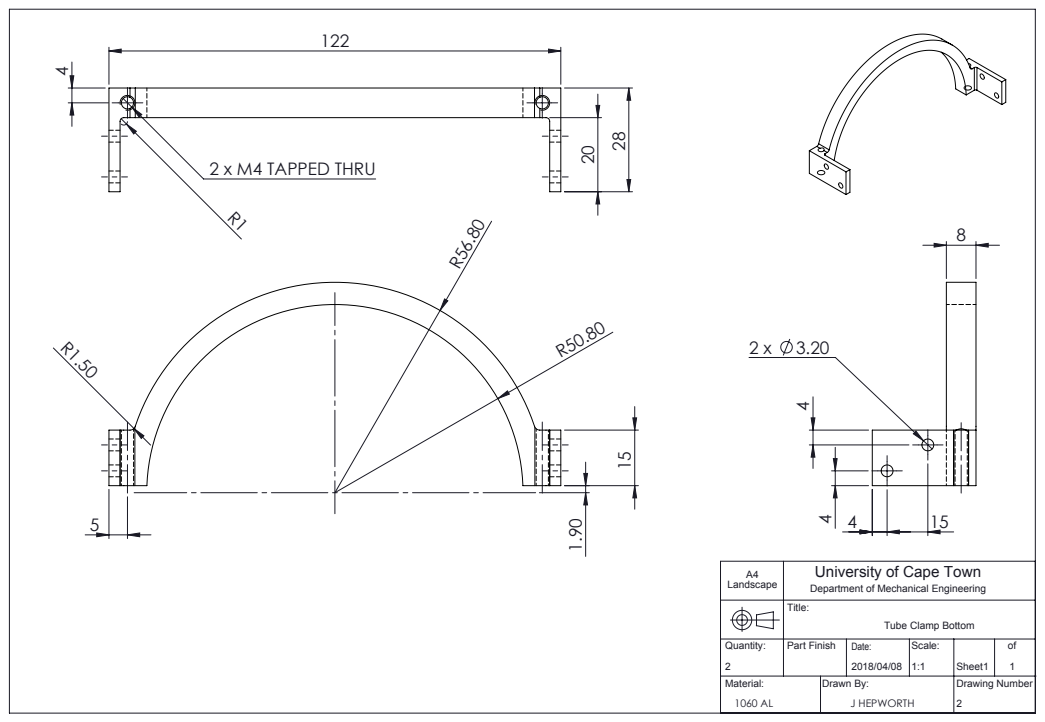
[picture p142: page 1]
2 x M4 TAPPED THRU; J HEPWORTH; Drawing Number; Part Finish; Scale:; Sheet1

University of Cape Town
Department of Mechanical Engineering
Title:

Tube Clamp Bottom
Date:
Drawn By:
