james-hepworth/masters/Mechanical Design/PDF Drawings/Tube Clamp.pdf

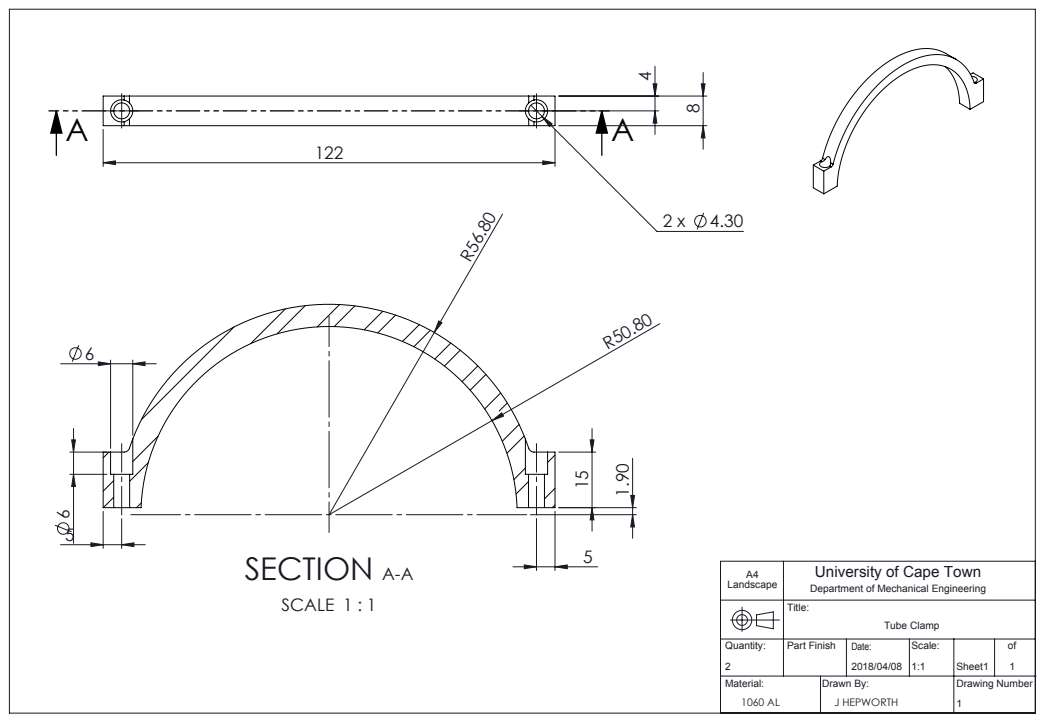
[picture p143: page 1]
SECTION A-A; SCALE 1 : 1; J HEPWORTH; Drawing Number; Drawn By:; Part Finish; Scale:; Sheet1; Tube Clamp

University of Cape Town
Department of Mechanical Engineering
Title:
