james-hepworth/masters/Mechanical Design/PDF Drawings/Tube Mass Bottom.pdf

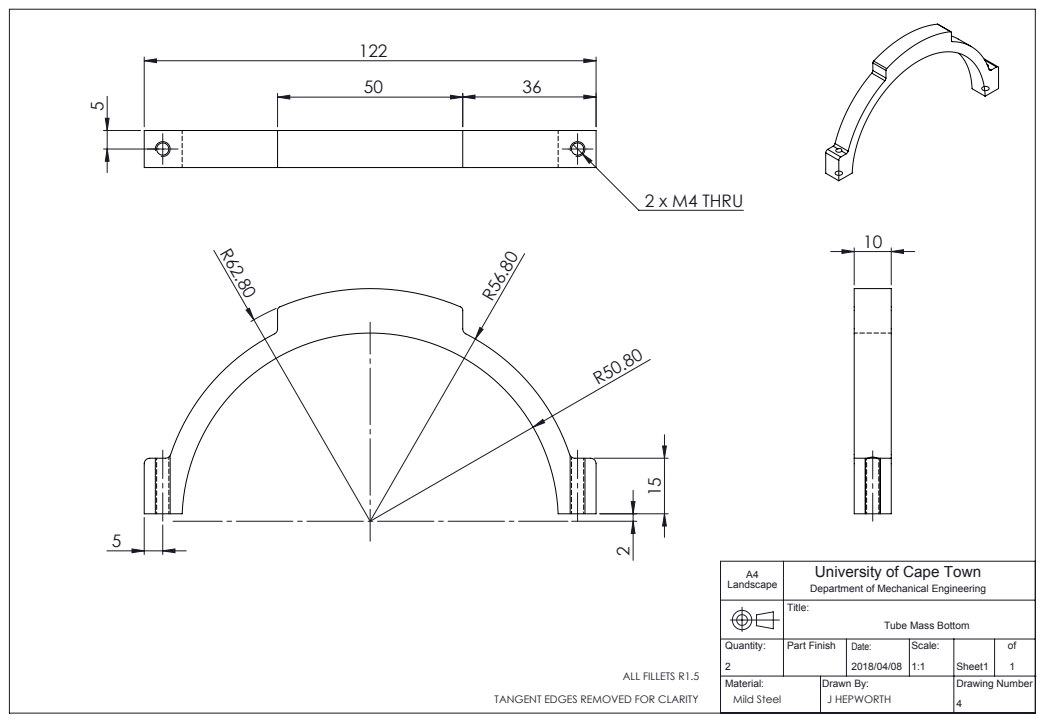
[picture p144: page 1]
2 x M4 THRU; TANGENT EDGES REMOVED FOR CLARITY; Mild Steel; J HEPWORTH; ALL FILLETS R1.5; Drawing Number; Part Finish; Scale:; Sheet1

University of Cape Town
Department of Mechanical Engineering
Title:

Tube Mass Bottom
Date:
Drawn By:
