james-hepworth/masters/Mechanical Design/PDF Drawings/Tube Mass.pdf

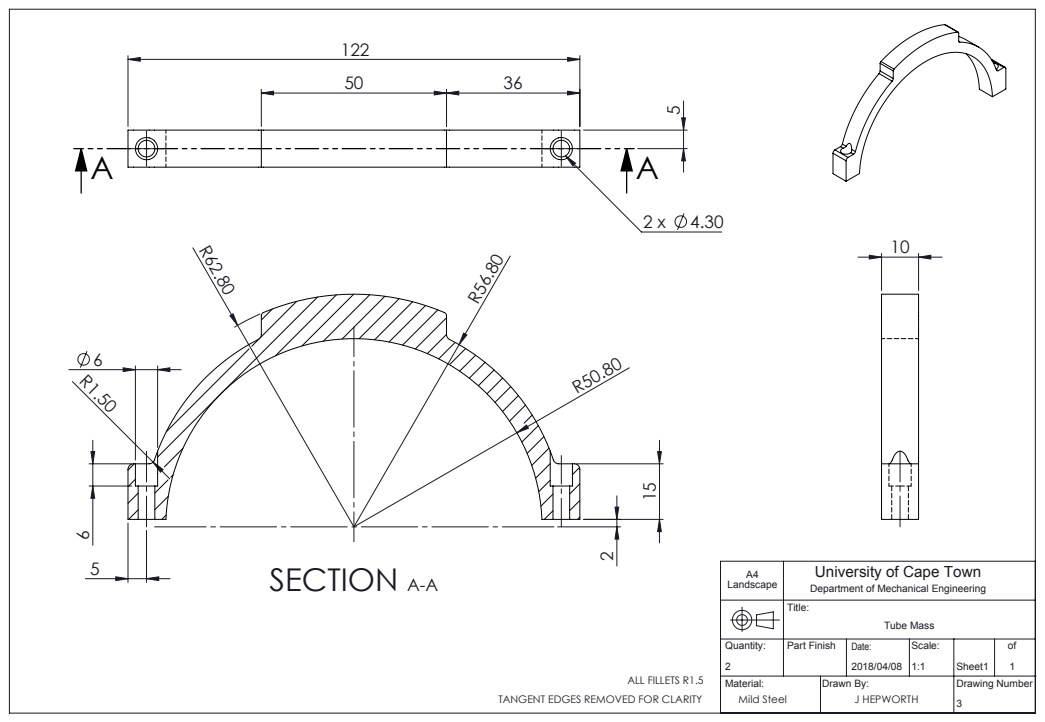
[picture p145: page 1]
SECTION A-A; ALL FILLETS R1.5; Mild Steel; J HEPWORTH; Drawing Number; Drawn By:; Part Finish; Scale:; Sheet1; Tube Mass

University of Cape Town
Department of Mechanical Engineering
Title:

TANGENT EDGES REMOVED FOR CLARITY
