james-hepworth/masters/Mechanical Design/PDF Drawings/Yaw Inner Race.pdf

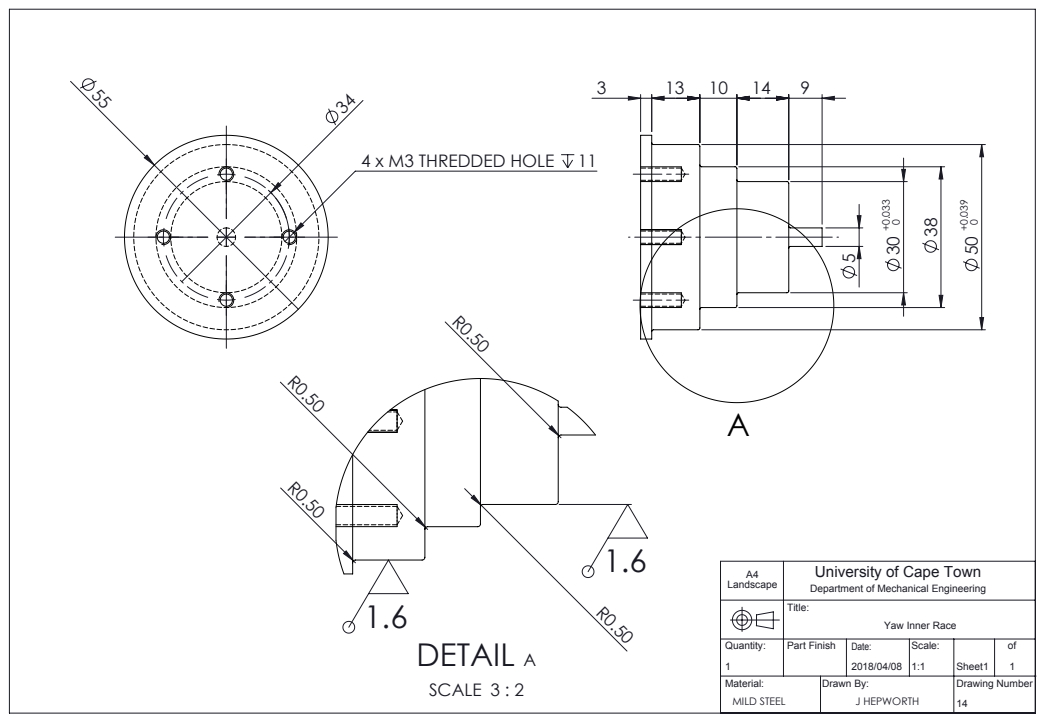
[picture p146: page 1]
4 x M3 THREDDED HOLE 11; DETAIL A; SCALE 3 : 2; MILD STEEL; J HEPWORTH; Drawing Number; Part Finish; Scale:; Sheet1

University of Cape Town
Department of Mechanical Engineering
Title:

Yaw Inner Race
Date:
Drawn By:
