james-hepworth/masters/Mechanical Design/PDF Drawings/Yaw Outer Race.pdf

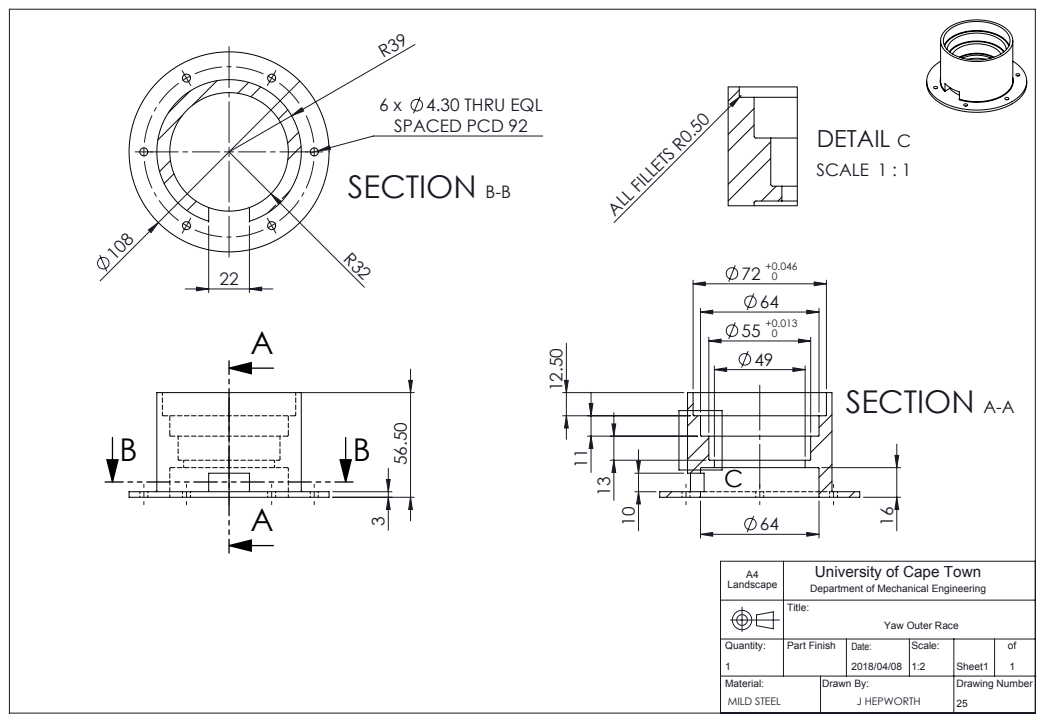
[picture p147: page 1]
SECTION A-A; 6 x 4.30 THRU EQL SPACED PCD 92; SECTION B-B; ALL FILLETS R0.50; DETAIL C SCALE 1 : 1; MILD STEEL; J HEPWORTH; Drawing Number; Part Finish; Scale:; Sheet1

University of Cape Town
Department of Mechanical Engineering
Title:

Yaw Outer Race
Date:
Drawn By:
