james-hepworth/masters/Mechanical Design/PDF Drawings/Cam Holder.pdf

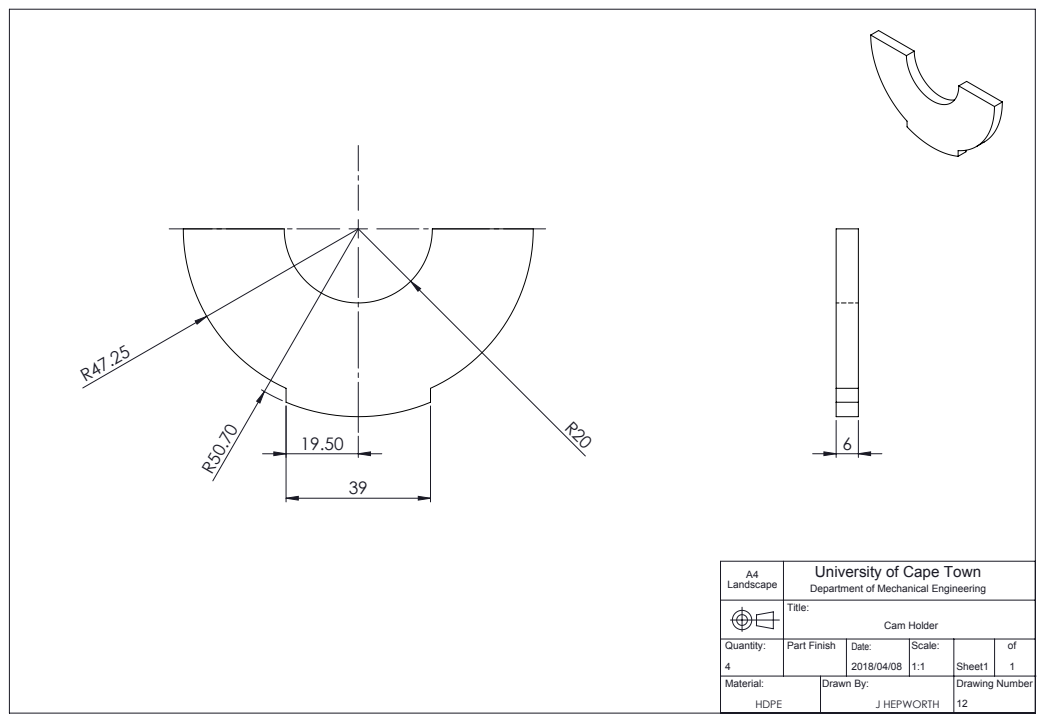
[picture p148: page 1]
HDPE; J HEPWORTH; Landscape 4; Drawing Number; Drawn By:; Part Finish; Scale:; Sheet1; Cam Holder

University of Cape Town
Department of Mechanical Engineering
Title:
