james-hepworth/masters/Mechanical Design/PDF Drawings/Gimbal Base.pdf

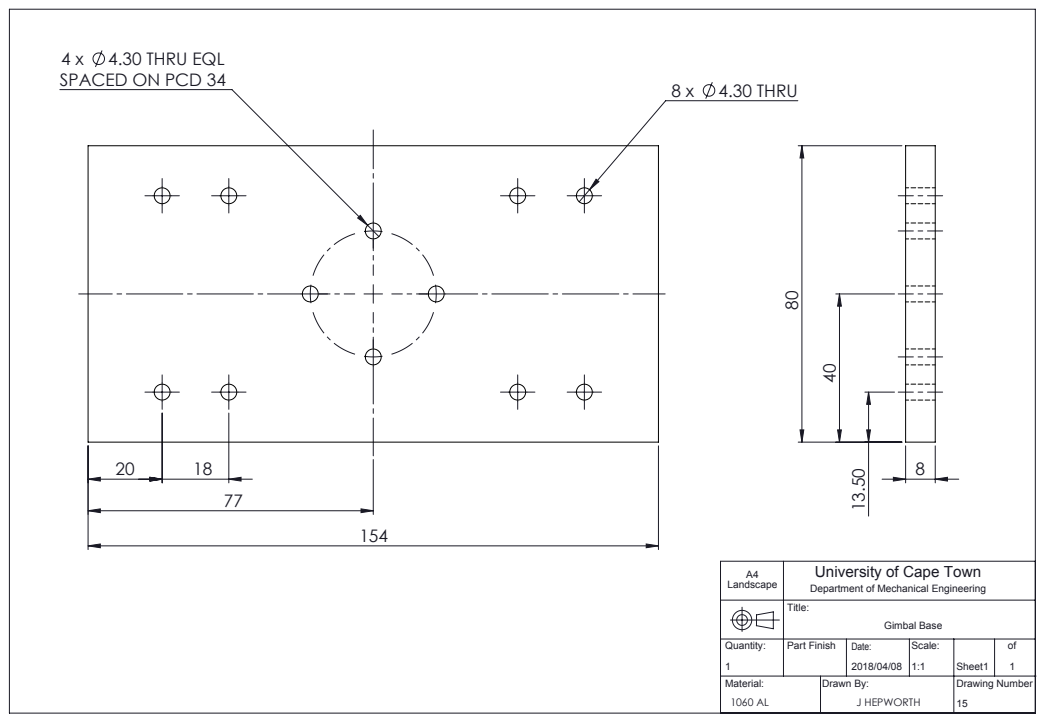
[picture p149: page 1]
8 x 4.30 THRU; J HEPWORTH; Drawing Number; Drawn By:; Part Finish; Scale:; Sheet1; Gimbal Base

4 x 4.30 THRU EQL
SPACED ON PCD 34

University of Cape Town
Department of Mechanical Engineering
Title:
