james-hepworth/masters/Mechanical Design/PDF Drawings/Mass Block CNC L.pdf

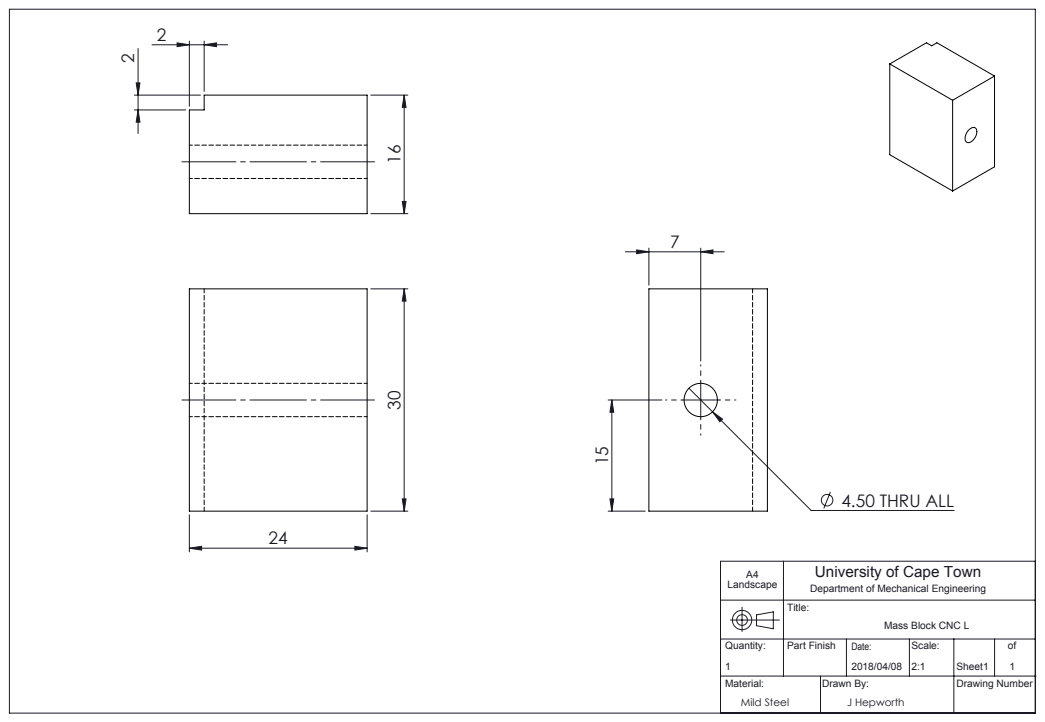
[picture p150: page 1]
4.50 THRU ALL; Mild Steel; J Hepworth; Drawing Number; Part Finish; Scale:; Sheet1

University of Cape Town
Department of Mechanical Engineering
Title:

Mass Block CNC L
Date:
Drawn By:
