james-hepworth/masters/Mechanical Design/PDF Drawings/Mass Block2.pdf

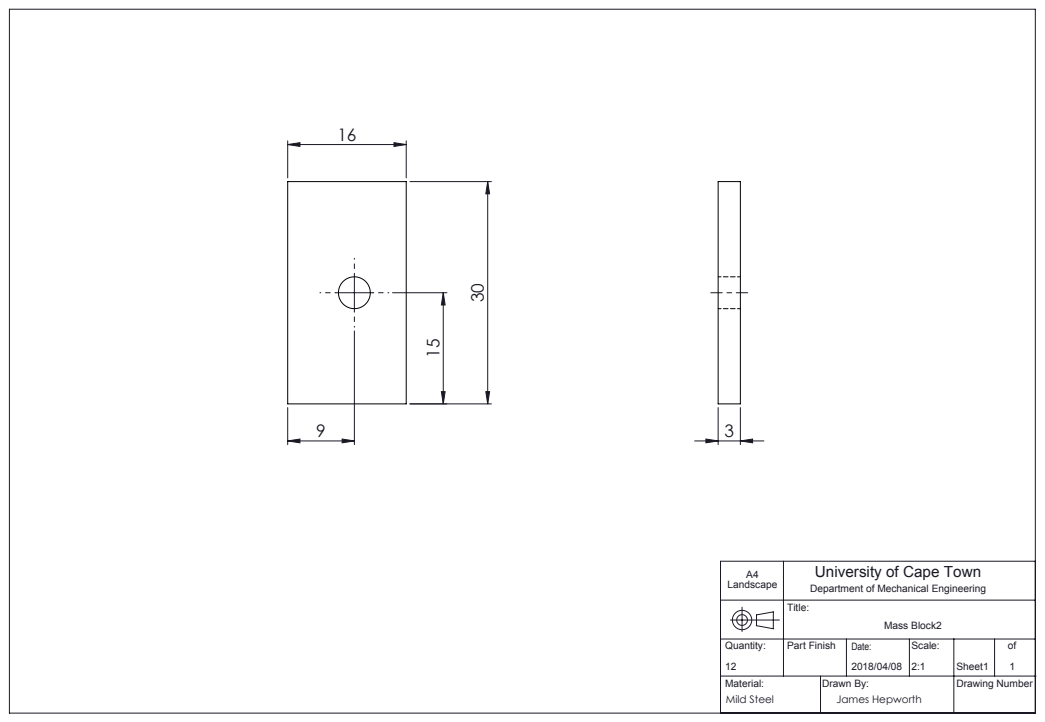
[picture p151: page 1]
Mild Steel; James Hepworth; Drawing Number; Drawn By:; Part Finish; Scale:; Sheet1; Mass Block2

University of Cape Town
Department of Mechanical Engineering
Title:
