james-hepworth/masters/Mechanical Design/PDF Drawings/Side1_Turned.pdf

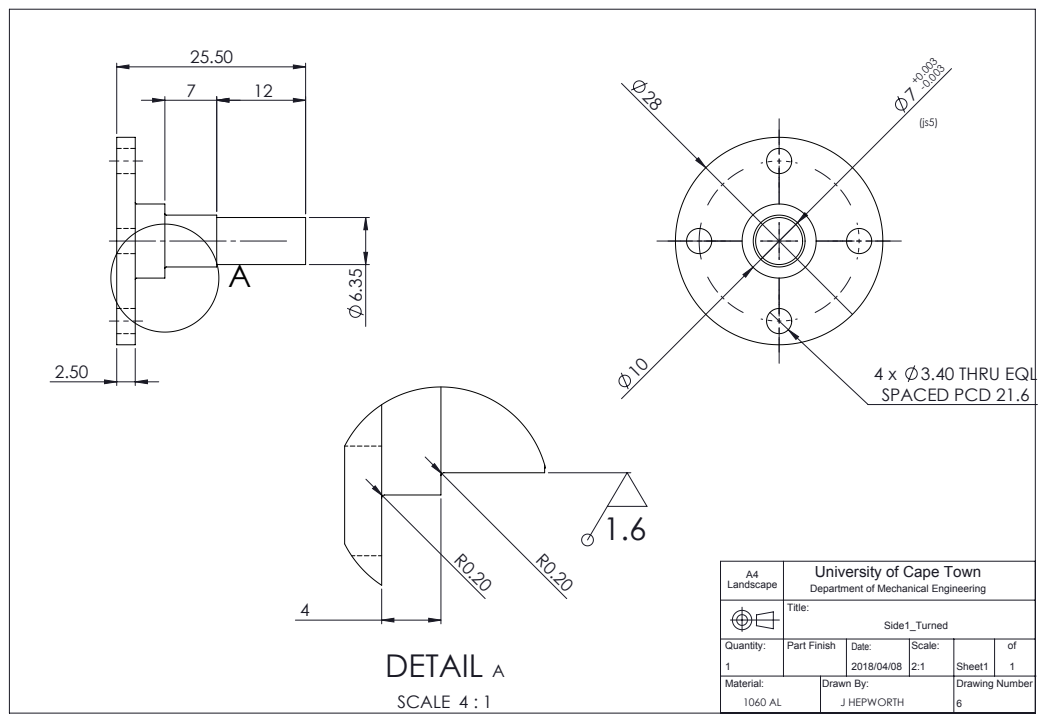
[picture p152: page 1]
4 x 3.40 THRU EQL SPACED PCD 21.6; DETAIL A; SCALE 4 : 1; J HEPWORTH; Drawing Number; Drawn By:; Part Finish; Scale:; Sheet1

University of Cape Town
Department of Mechanical Engineering
Title:
