james-hepworth/masters/Mechanical Design/PDF Drawings/Side2_Turned.pdf

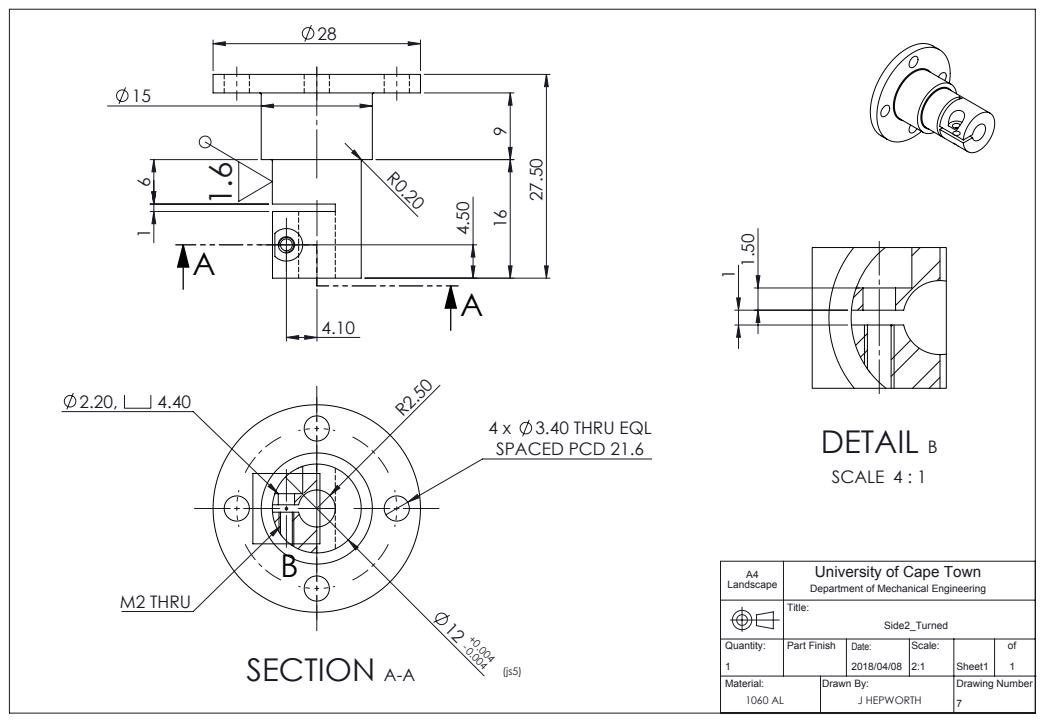
[picture p153: page 1]
4 x 3.40 THRU EQL SPACED PCD 21.6; SECTION A-A; M2 THRU; DETAIL B; SCALE 4 : 1; J HEPWORTH; Drawing Number; Drawn By:; Part Finish; Scale:; Sheet1

University of Cape Town
Department of Mechanical Engineering
Title:
