james-hepworth/masters/Mechanical Design/PDF Drawings/Telescop Modeller Tray.pdf

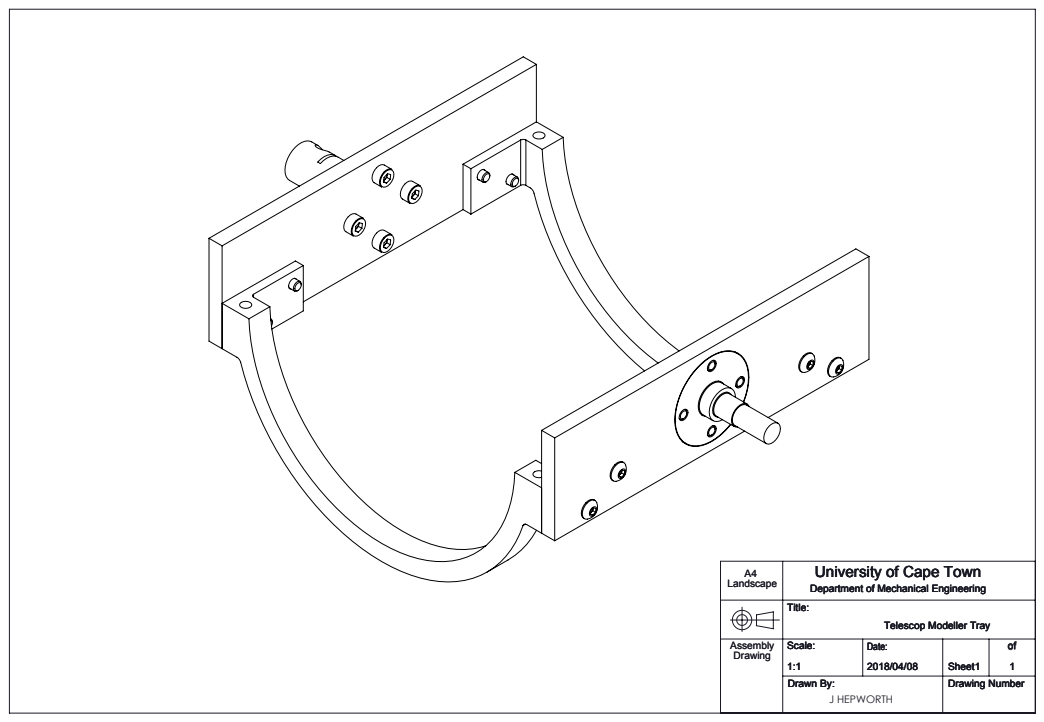
[picture p154: page 1]
J HEPWORTH; Drawing Number; Drawn By:

University of Cape Town
Department of Mechanical Engineering
Title:

Telescop Modeller Tray
Date:
