james-hepworth/masters/Mechanical Design/PDF Drawings/Upright1.pdf

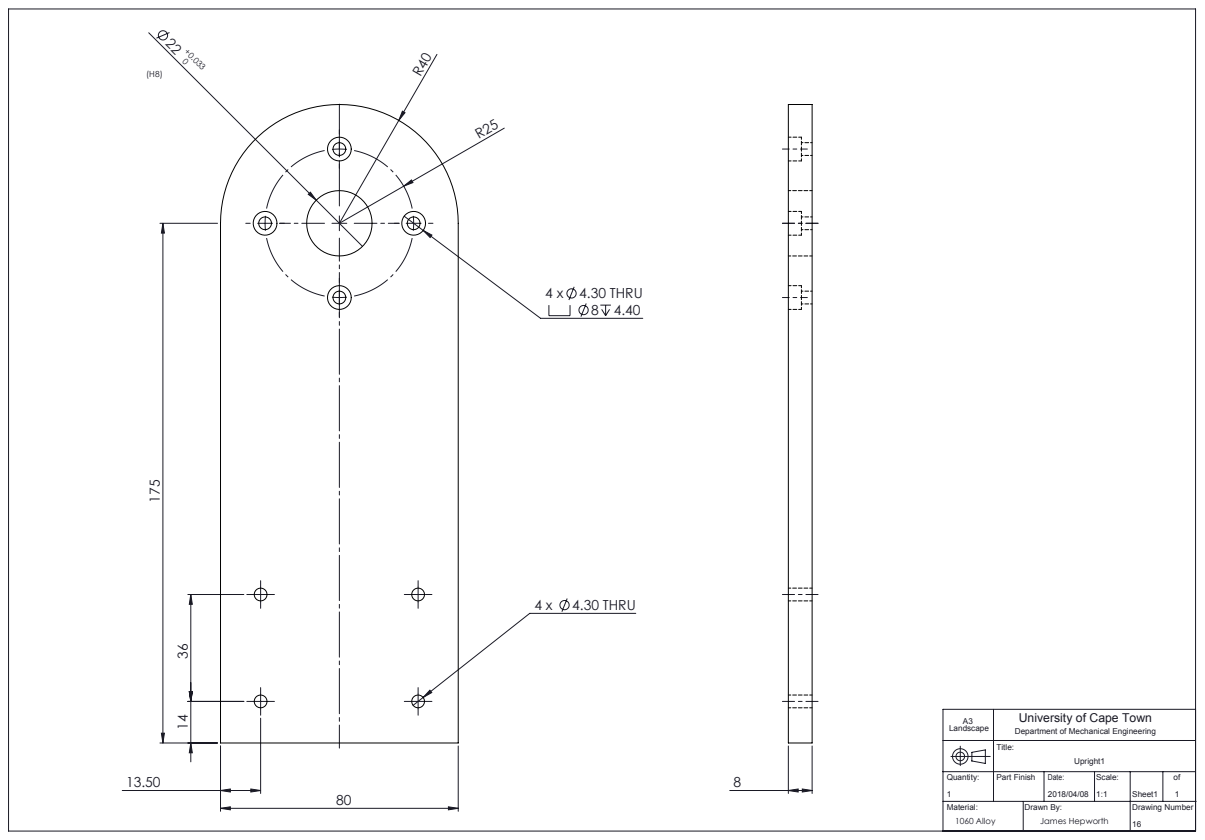
[picture p155: page 1]
4 x 4.30 THRU; 4 x 4.30 THRU 8 4.40; 1060 Alloy; James Hepworth; Sheet1; Part Finish; Scale:; Drawn By:; Drawing Number

University of Cape Town
Department of Mechanical Engineering
Title:
