james-hepworth/masters/Mechanical Design/PDF Drawings/Upright2.pdf

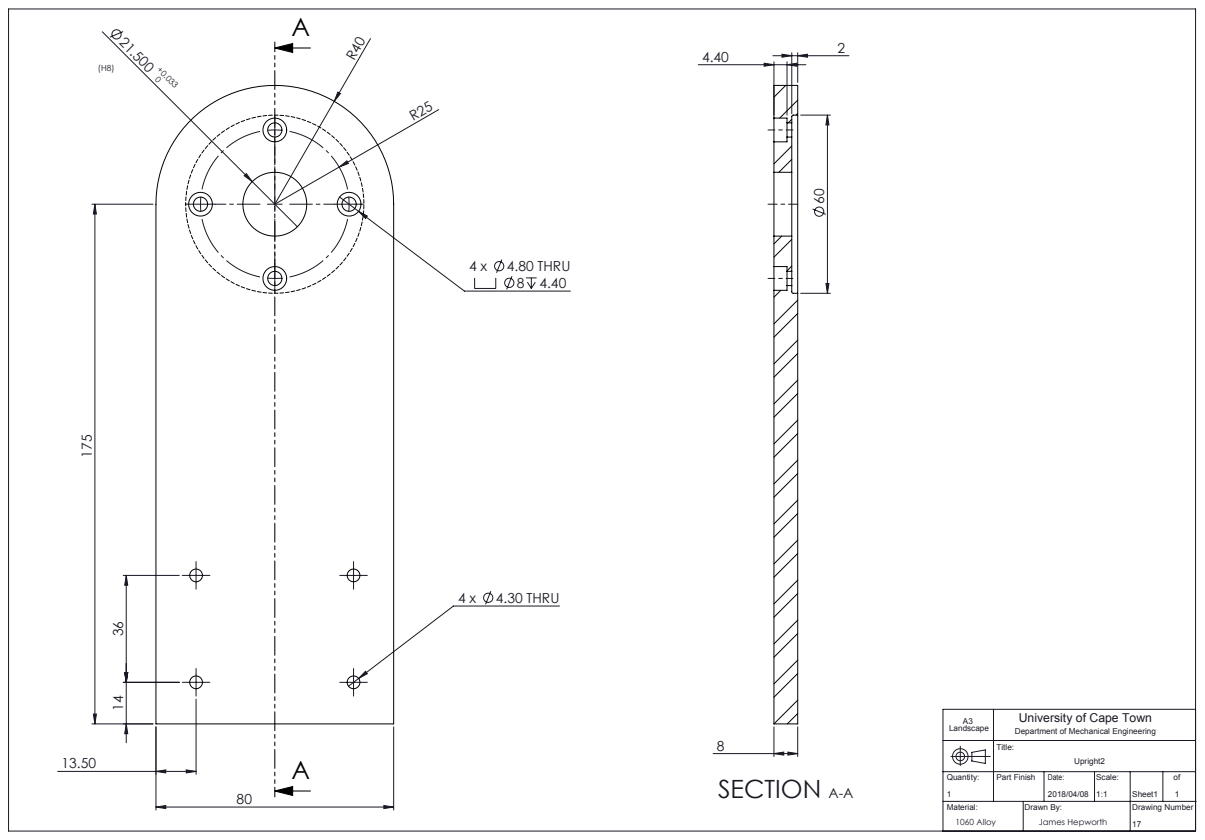
[picture p156: page 1]
4 x 4.30 THRU; 4 x 4.80 THRU 8 4.40; SECTION A-A; 1060 Alloy; James Hepworth; Sheet1; Part Finish; Scale:; Drawn By:; Drawing Number

University of Cape Town
Department of Mechanical Engineering
Title:
